blemay360/Chessboard/README.md

# chessboard
Code for a chessboard with computer vision piece tracking
