blemay360/Chessboard/Design/Gimp Files/vision chart.pdf

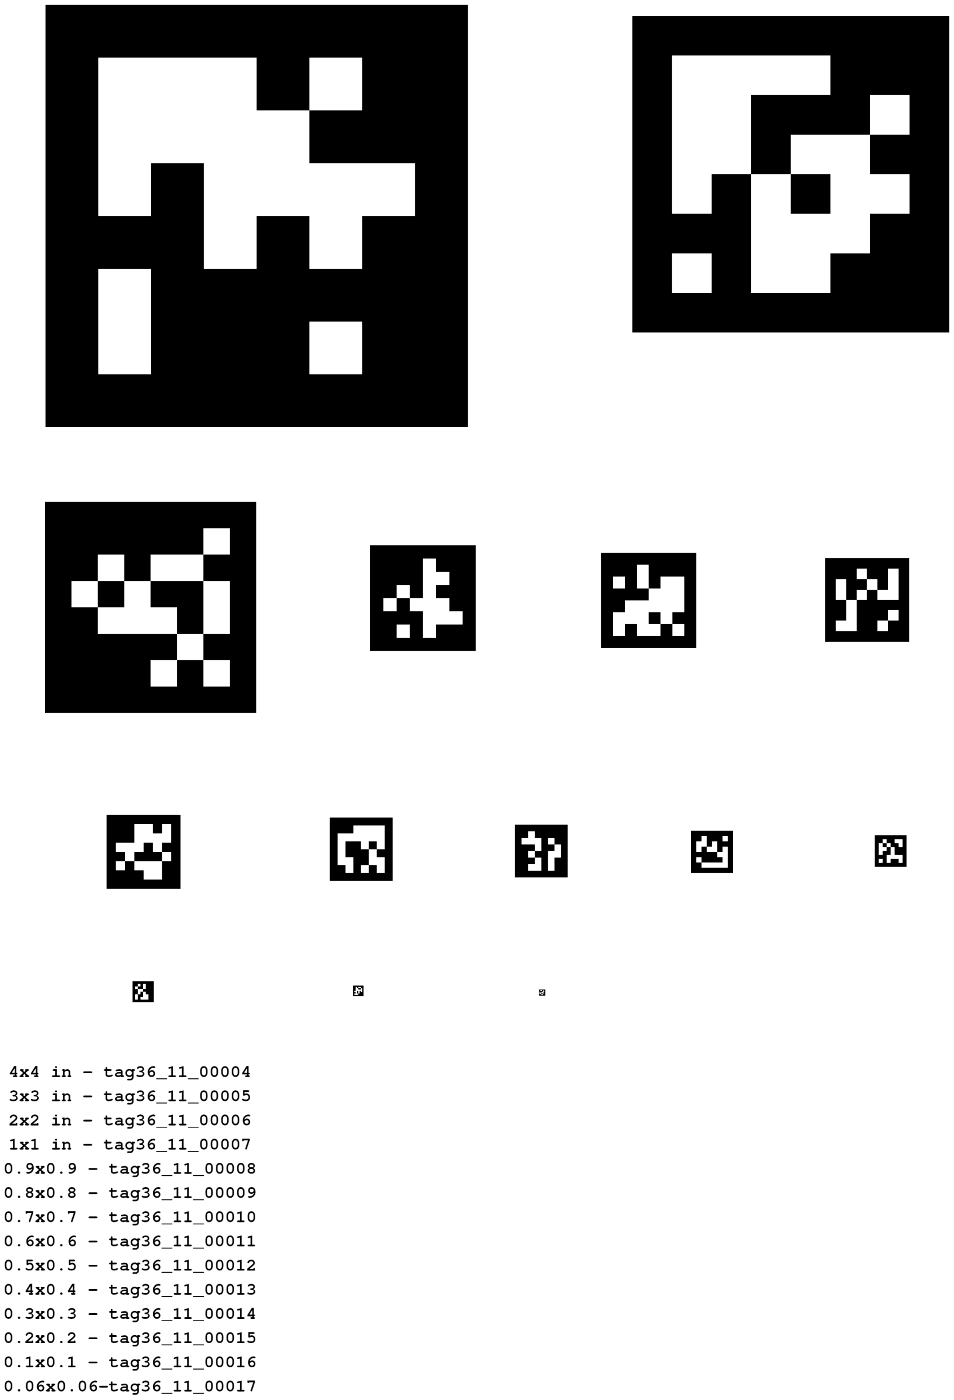
[picture p17: page 1]
