blemay360/Chessboard/Design/Report/Images/ControlSchematicDesign.png

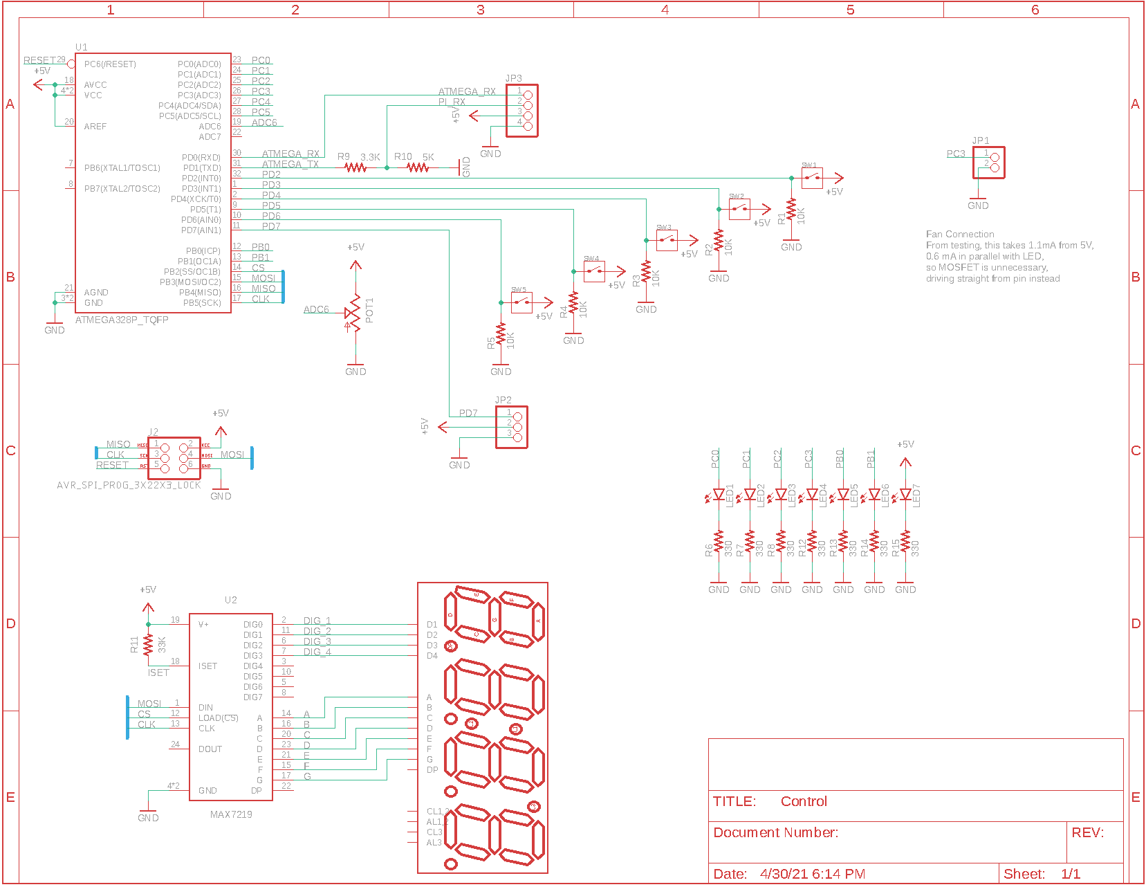
Design/Report/Images/ControlSchematicDesign.png
