blemay360/Chessboard/Software/TestingImages/ItalianGamePaper/ItalianGame1.jpg

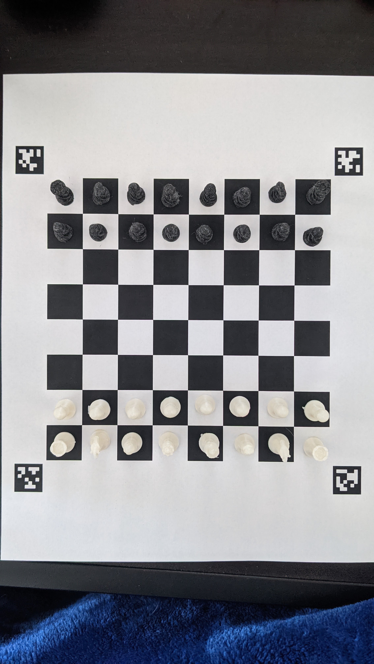
Software/TestingImages/ItalianGamePaper/ItalianGame1.jpg
