blemay360/Chessboard/Software/TestingImages/ItalianGamePaper/ItalianGame2.jpg

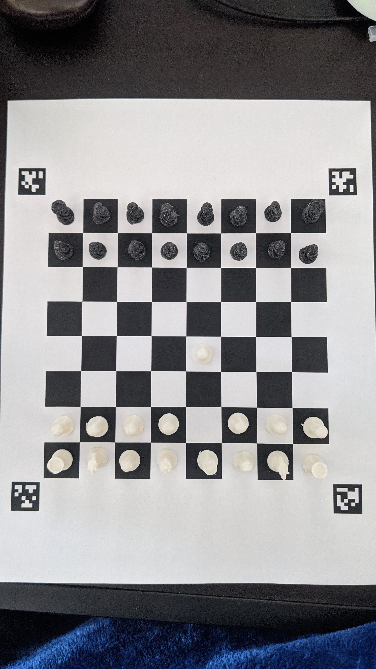
Software/TestingImages/ItalianGamePaper/ItalianGame2.jpg
