blemay360/Chessboard/Software/TestingImages/ItalianGamePaper/ItalianGame3.jpg

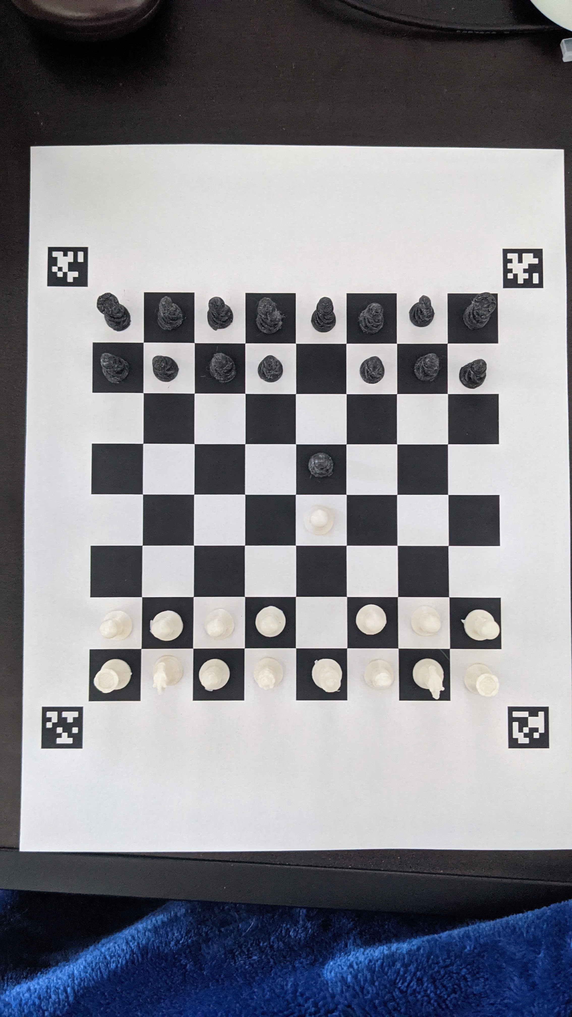
Software/TestingImages/ItalianGamePaper/ItalianGame3.jpg
