blemay360/Chessboard/Software/TestingImages/ItalianGamePaper/ItalianGame4.jpg

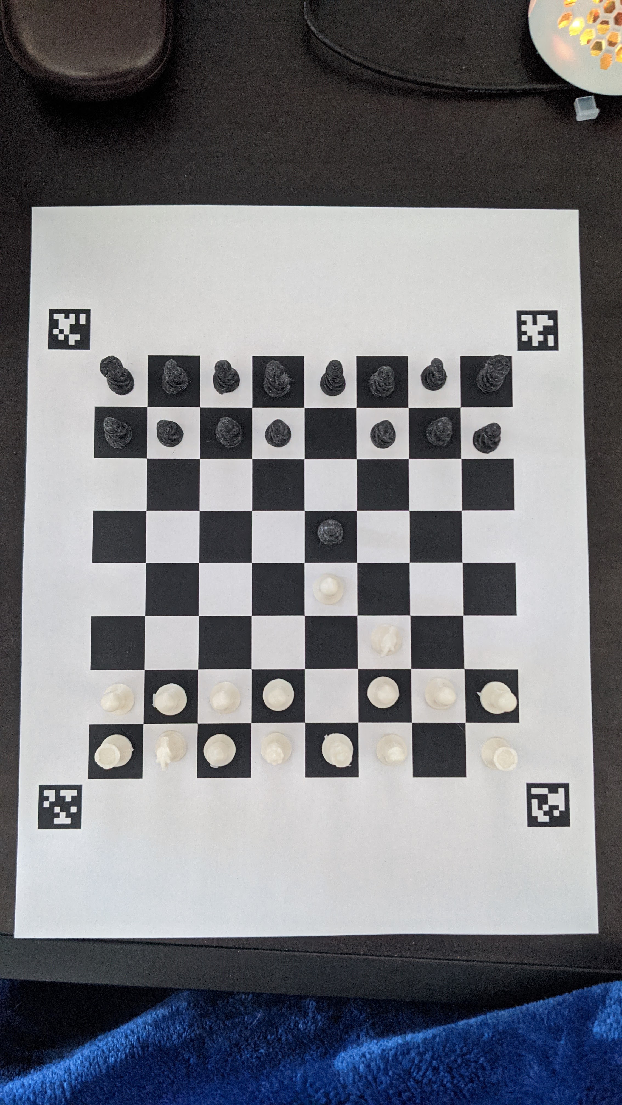
Software/TestingImages/ItalianGamePaper/ItalianGame4.jpg
