blemay360/Chessboard/Software/TestingImages/ItalianGamePaper/ItalianGame5.jpg

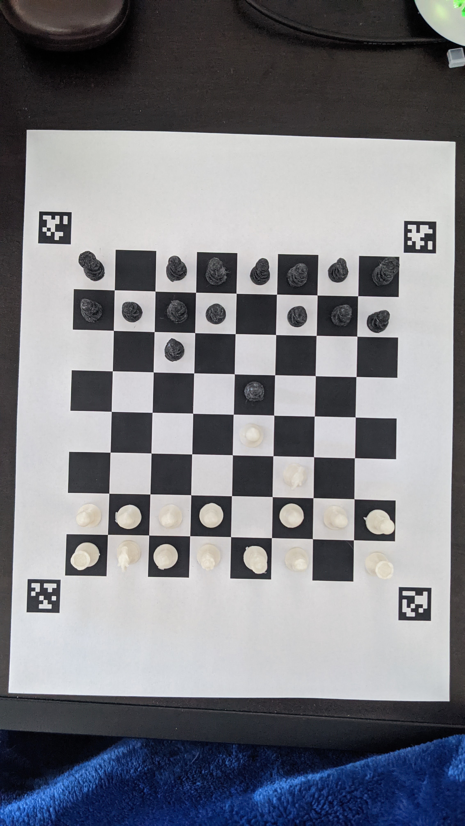
Software/TestingImages/ItalianGamePaper/ItalianGame5.jpg
