blemay360/Chessboard/Software/TestingImages/ItalianGamePaper/ItalianGame6.jpg

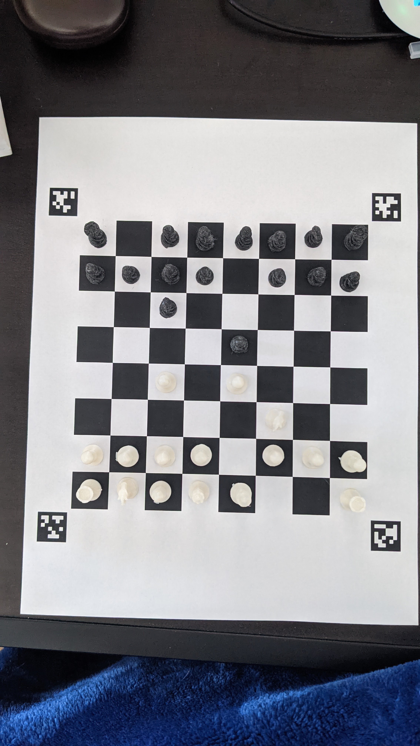
Software/TestingImages/ItalianGamePaper/ItalianGame6.jpg
