blemay360/Chessboard/Software/TestingImages/ItalianGamePaper/ItalianGame7.jpg

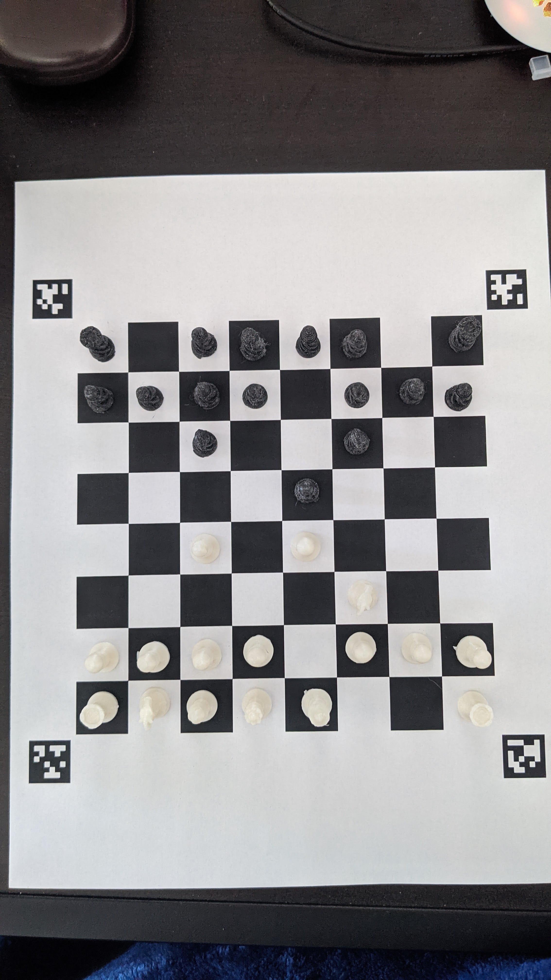
Software/TestingImages/ItalianGamePaper/ItalianGame7.jpg
