blemay360/Chessboard/Software/TestingImages/ItalianGamePaper/ItalianGame8.jpg

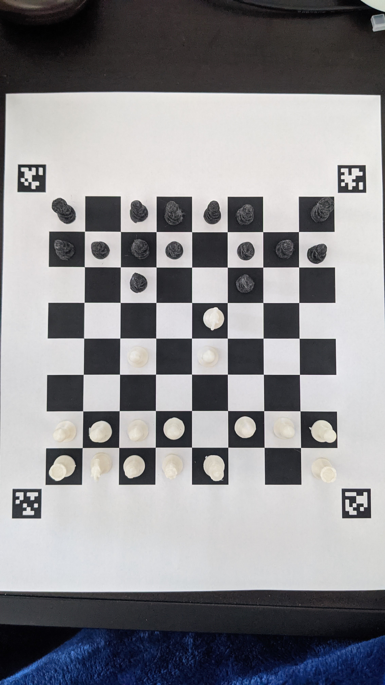
Software/TestingImages/ItalianGamePaper/ItalianGame8.jpg
