blemay360/Chessboard/Software/TestingImages/ItalianGamePaper/ItalianGame9.jpg

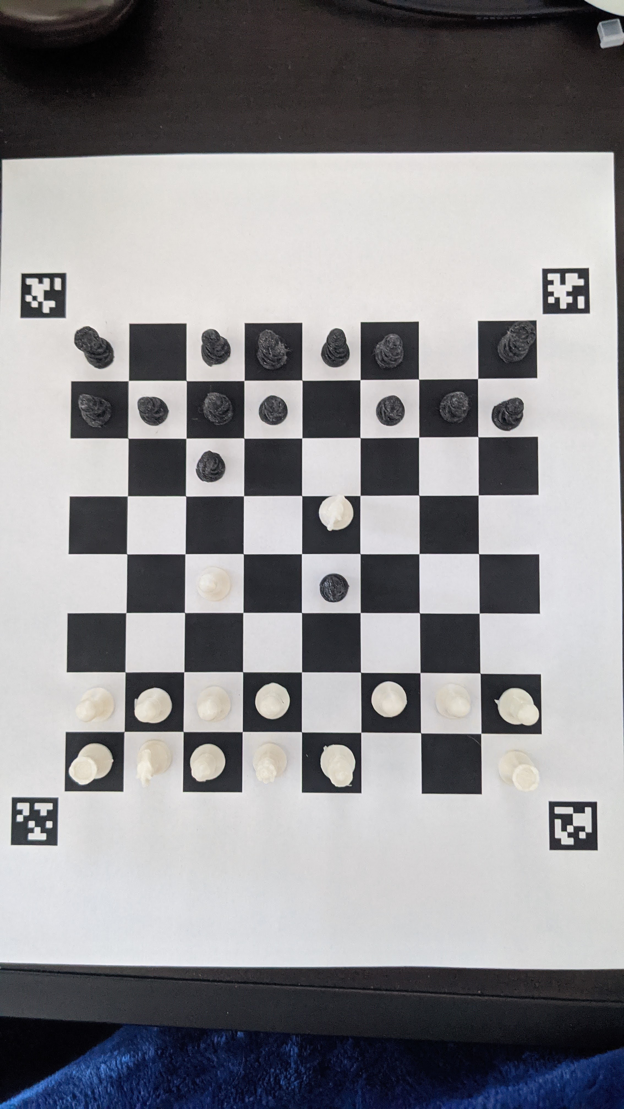
Software/TestingImages/ItalianGamePaper/ItalianGame9.jpg
