blemay360/Chessboard/Software/TestingImages/ItalianGamePaper/ItalianGame10.jpg

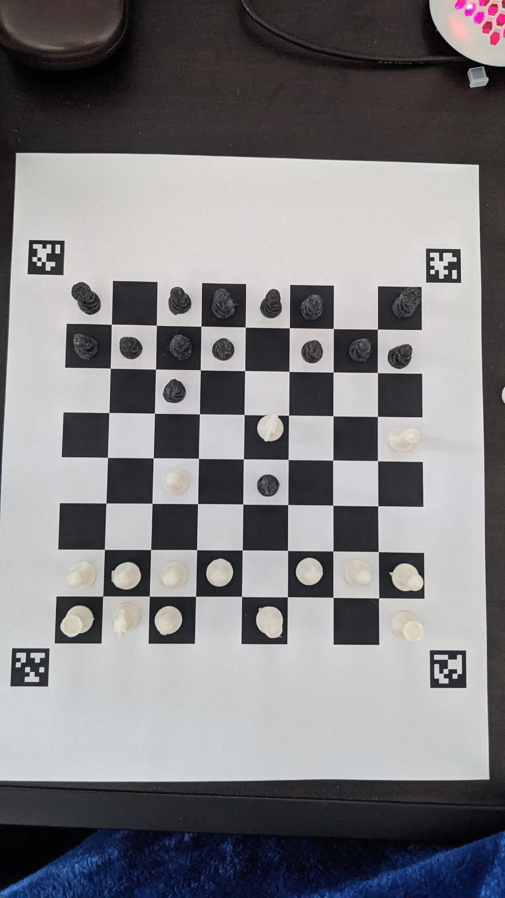
Software/TestingImages/ItalianGamePaper/ItalianGame10.jpg
