blemay360/Chessboard/Software/TestingImages/ItalianGamePaper/ItalianGame11.jpg

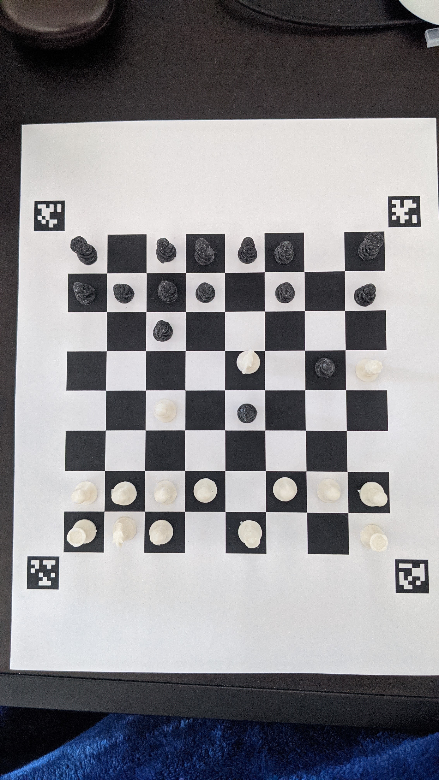
Software/TestingImages/ItalianGamePaper/ItalianGame11.jpg
