blemay360/Chessboard/Software/TestingImages/ItalianGamePaper/ItalianGame12.jpg

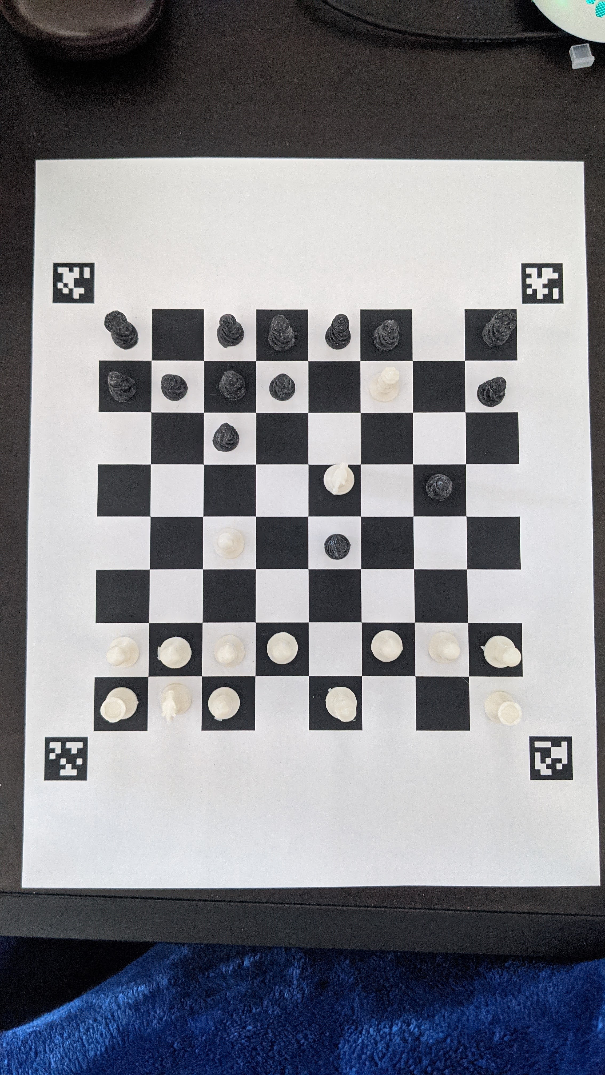
Software/TestingImages/ItalianGamePaper/ItalianGame12.jpg
