blemay360/Chessboard/Software/TestingImages/ItalianGamePaper/ItalianGame_AllBlack1.jpg

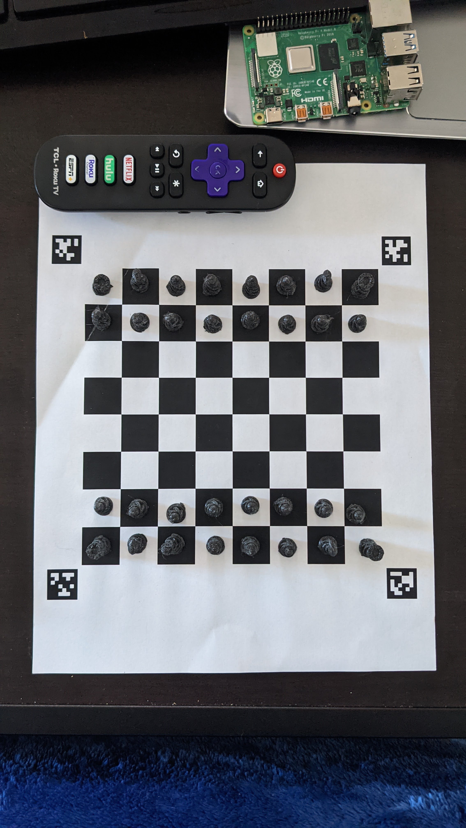
Software/TestingImages/ItalianGamePaper/ItalianGame_AllBlack1.jpg
