blemay360/Chessboard/Software/TestingImages/ItalianGamePaper/ItalianGame_AllBlack2.jpg

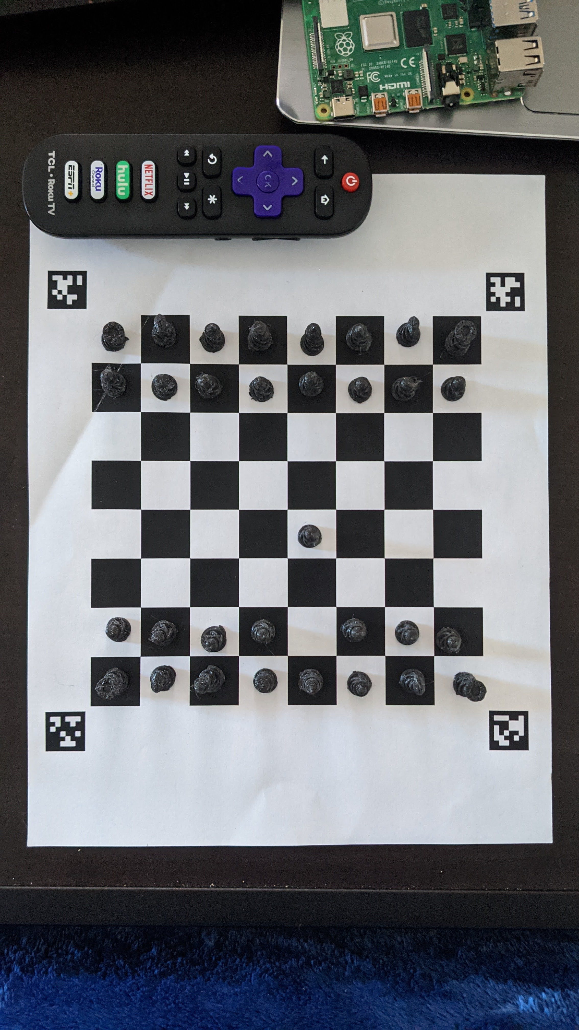
Software/TestingImages/ItalianGamePaper/ItalianGame_AllBlack2.jpg
