blemay360/Chessboard/Software/TestingImages/ItalianGamePaper/ItalianGame_AllBlack3.jpg

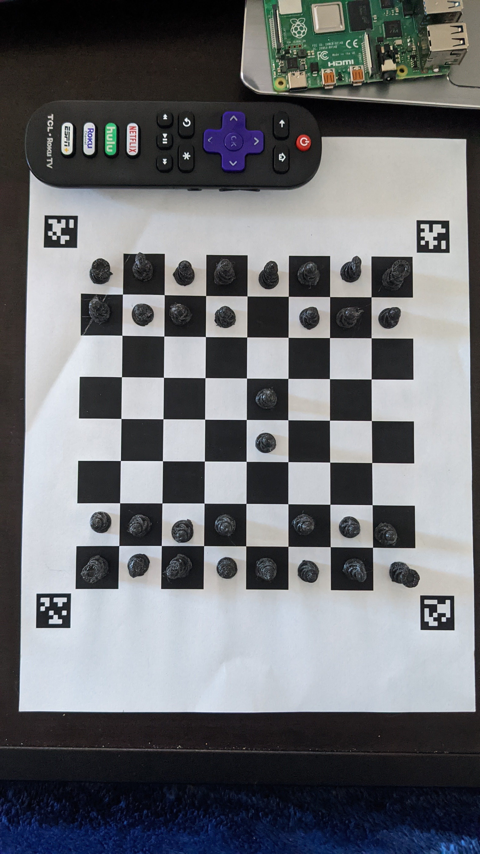
Software/TestingImages/ItalianGamePaper/ItalianGame_AllBlack3.jpg
