blemay360/Chessboard/Software/TestingImages/ItalianGamePaper/ItalianGame_AllBlack6.jpg

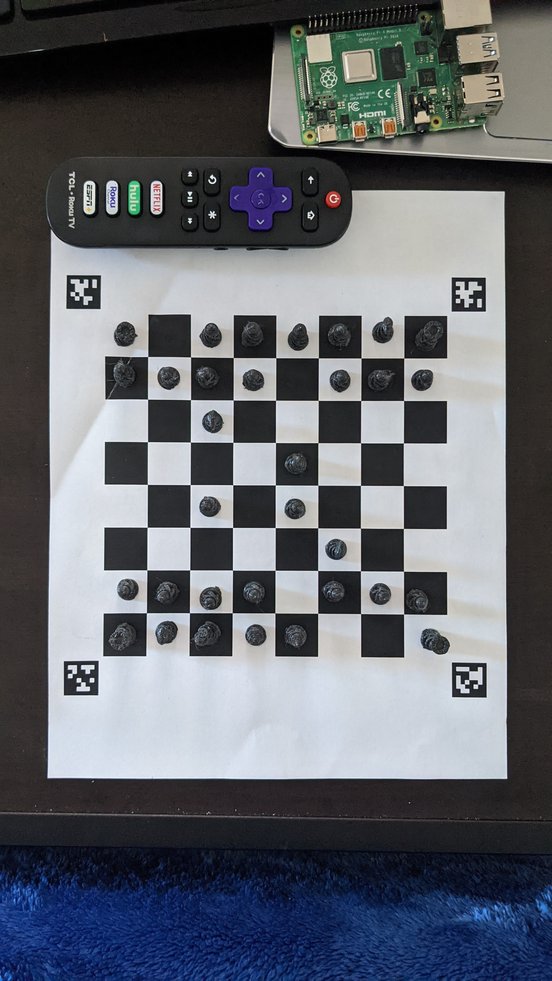
Software/TestingImages/ItalianGamePaper/ItalianGame_AllBlack6.jpg
