blemay360/Chessboard/Mechanical/STL files/Camera Standoff.stl

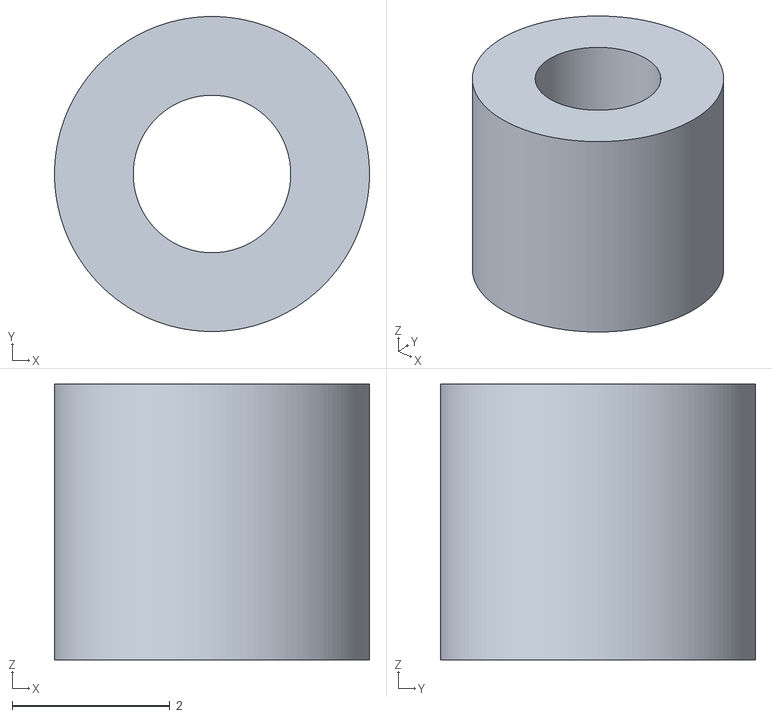
[picture p35: CAD file, 2021-04-05]
Mechanical/STL files/Camera Standoff.stl
4.00 x 4.00 x 3.50
