blemay360/Chessboard/Mechanical/STL files/Board mount MVP.stl

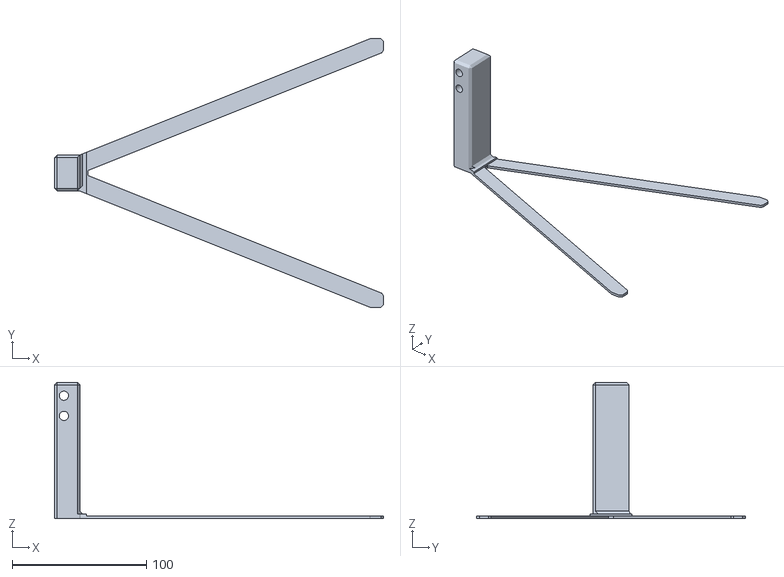
[picture p36: CAD file, 2021-04-05]
Mechanical/STL files/Board mount MVP.stl
245.0 x 200.0 x 101.6
