blemay360/Chessboard/Mechanical/STL files/Queen.STL

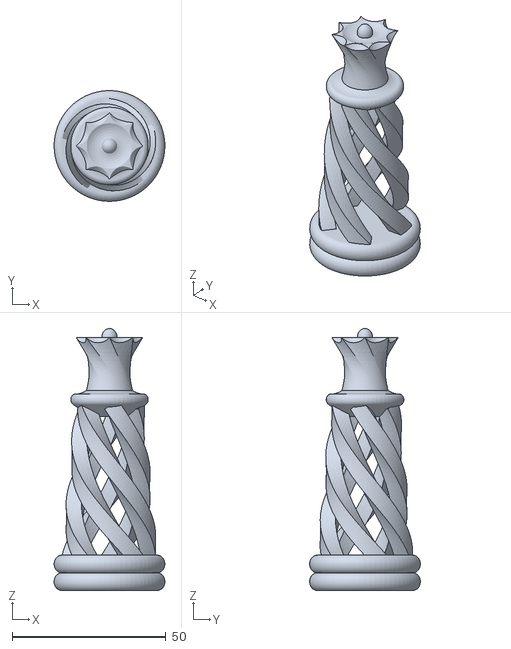
[picture p37: CAD file, 2021-03-10]
Mechanical/STL files/Queen.STL
36.0 x 36.0 x 85.1
