blemay360/Chessboard/Mechanical/STL files/Pawn.stl

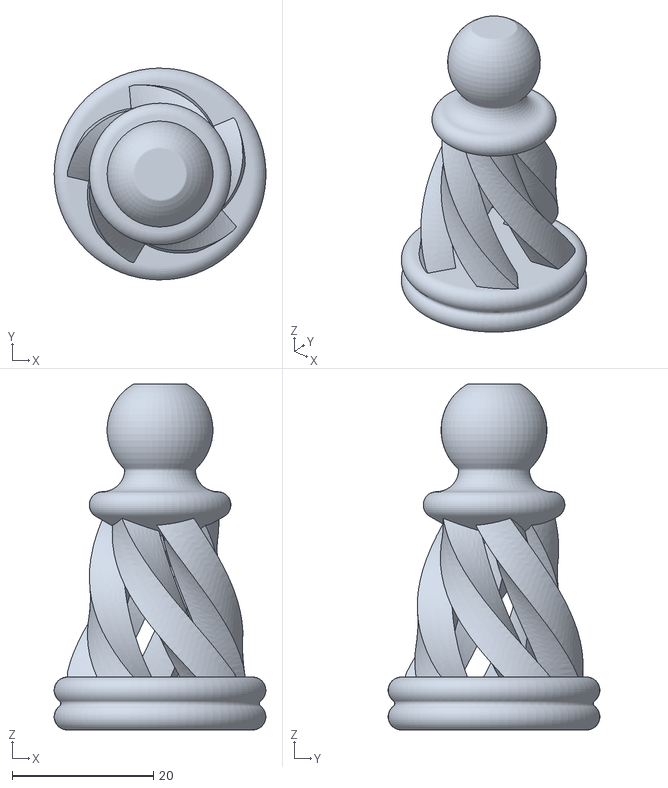
[picture p38: CAD file, 2021-03-10]
Mechanical/STL files/Pawn.stl
30.0 x 30.0 x 49.0
