blemay360/Chessboard/Mechanical/STL files/King.STL

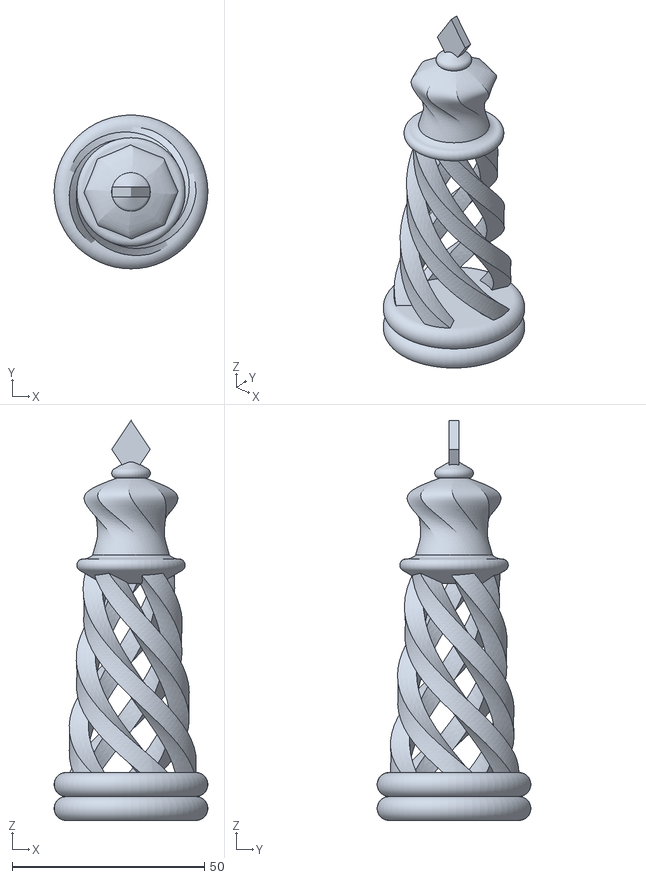
[picture p39: CAD file, 2021-03-10]
Mechanical/STL files/King.STL
40.0 x 40.0 x 104.0
