blemay360/Chessboard/Mechanical/STL files/Rook2.STL

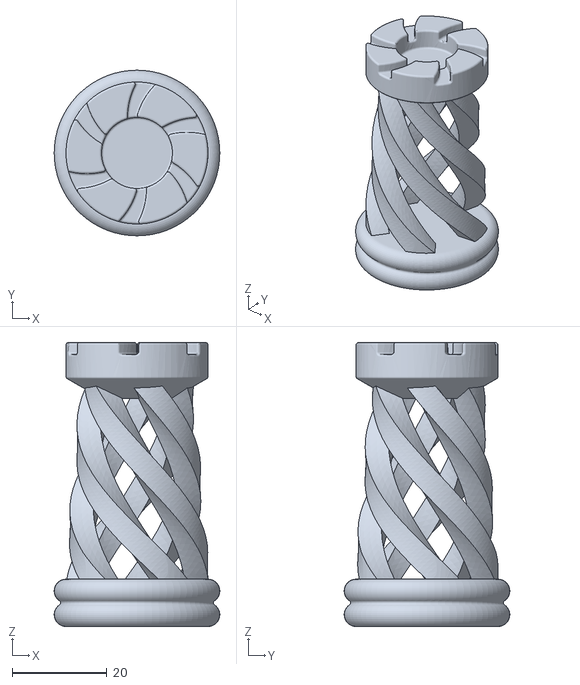
[picture p40: CAD file, 2021-03-10]
Mechanical/STL files/Rook2.STL
35.0 x 35.0 x 60.0
