blemay360/Chessboard/Mechanical/STL files/Knight.STL

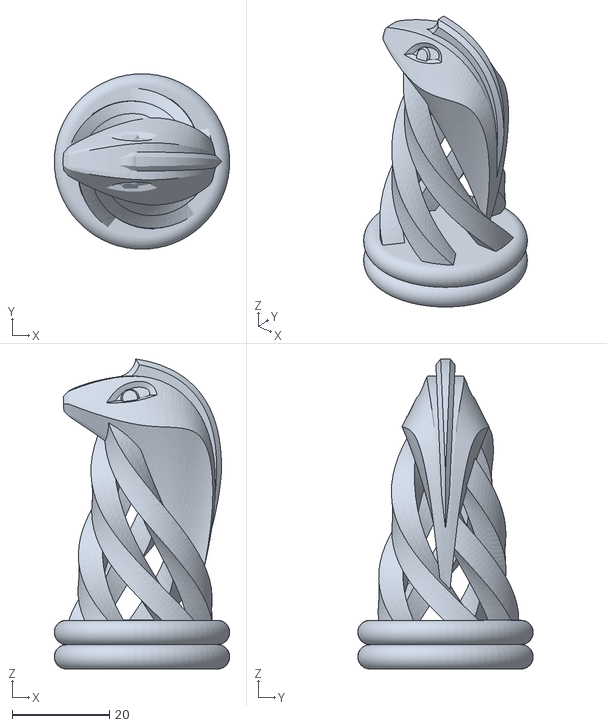
[picture p41: CAD file, 2021-03-10]
Mechanical/STL files/Knight.STL
36.0 x 36.0 x 63.6
