blemay360/Chessboard/Mechanical/STL files/Bishop.stl

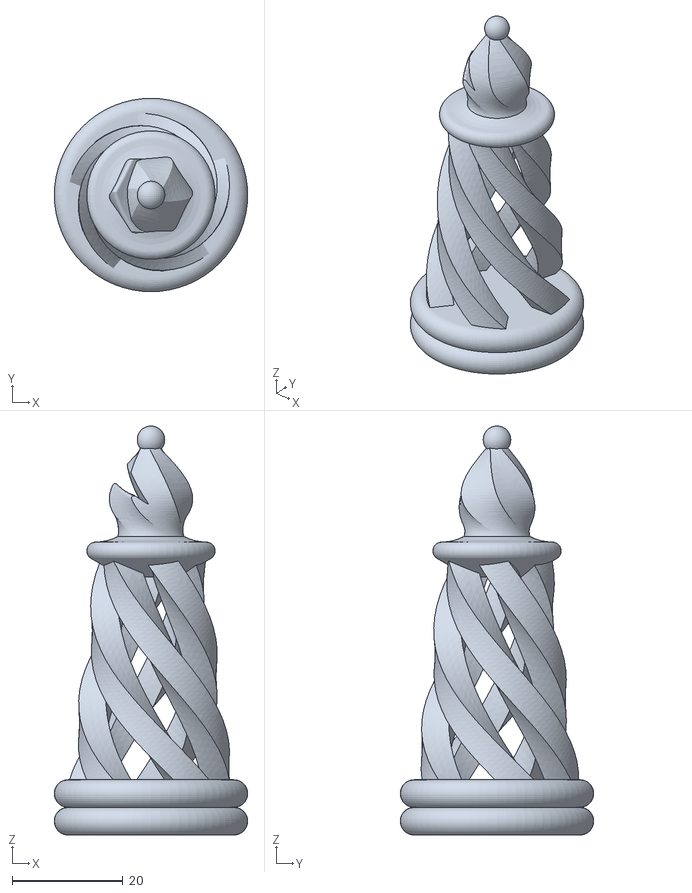
[picture p42: CAD file, 2021-03-10]
Mechanical/STL files/Bishop.stl
35.0 x 35.0 x 74.0
