blemay360/Chessboard/Design/Report/Images/11in_TestChessboard_16h5_Comparison_5pt.png

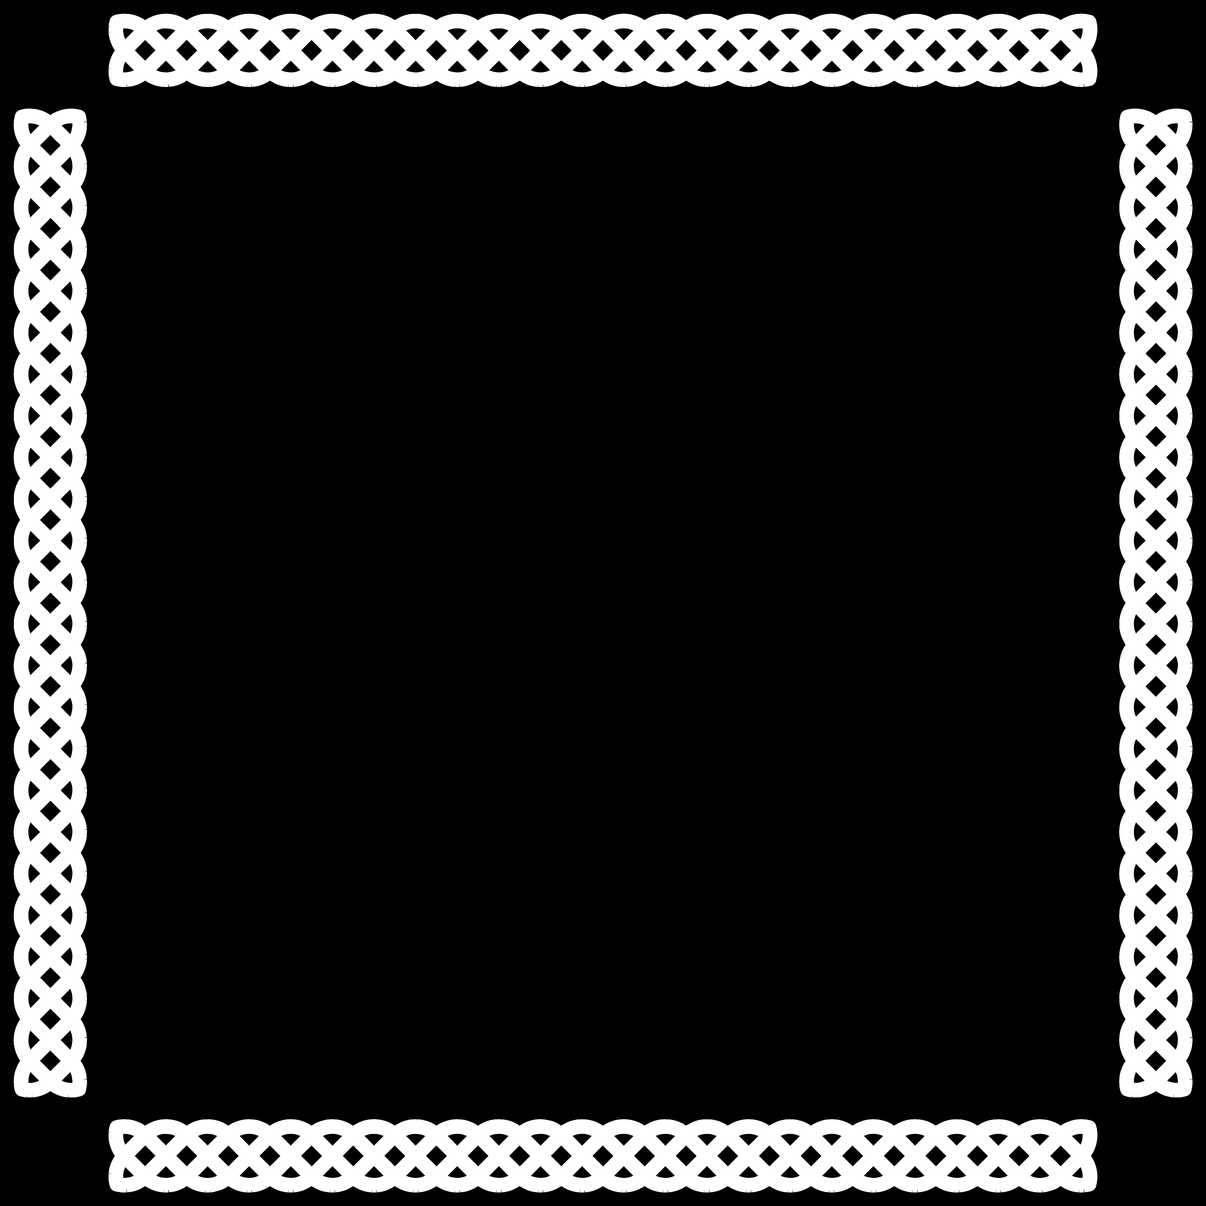
Design/Report/Images/11in_TestChessboard_16h5_Comparison_5pt.png
