blemay360/Chessboard/Software/BorderComparisonImages/11in_TestChessboard_16h5_Comparison_12pt.png

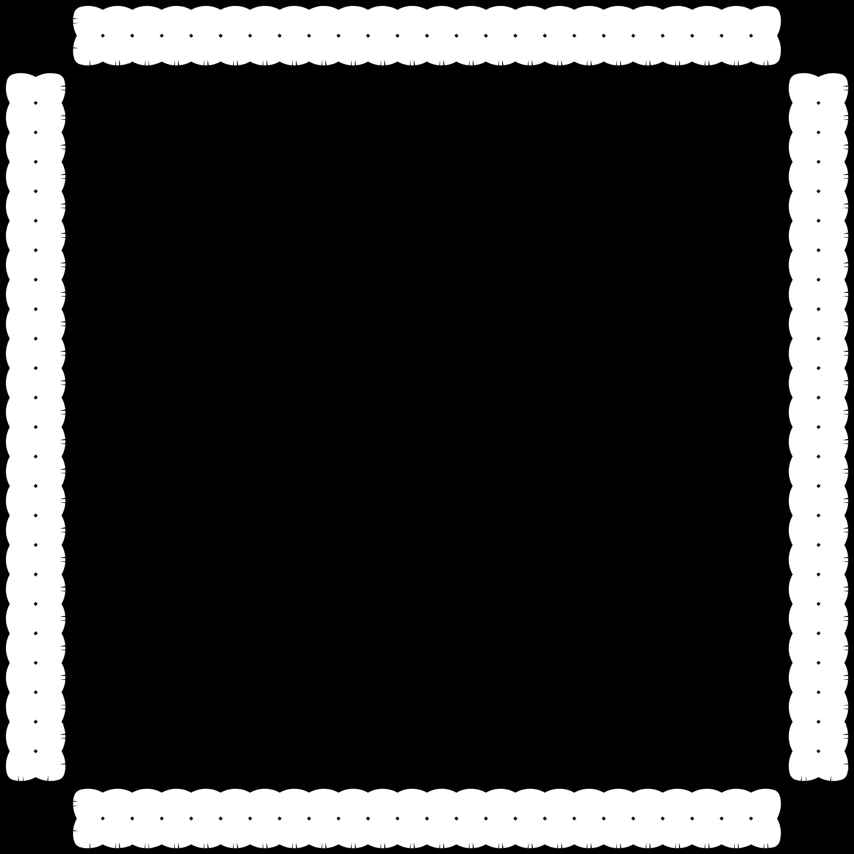
Software/BorderComparisonImages/11in_TestChessboard_16h5_Comparison_12pt.png
