blemay360/Chessboard/Software/TestingImages/ExampleCollage.png

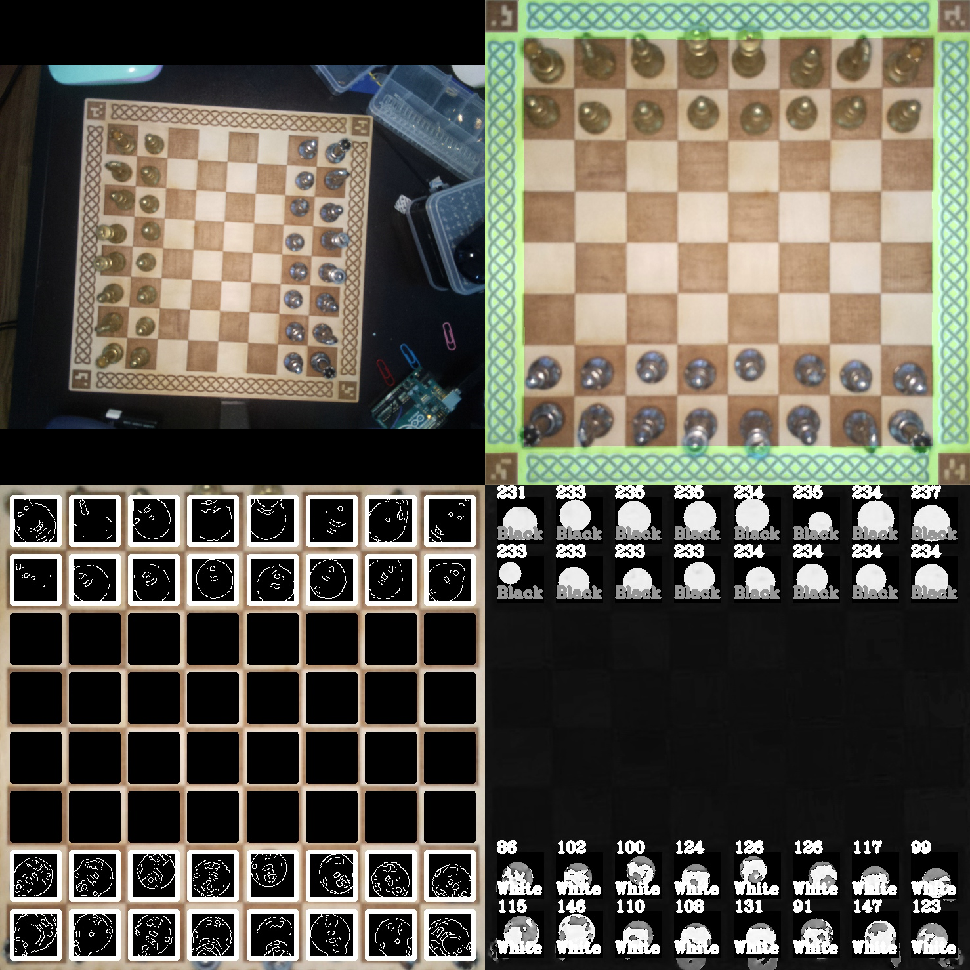
Software/TestingImages/ExampleCollage.png
