blemay360/Chessboard/Software/TestingImages/ItalianGamePaper/ItalianGame_CaptureTesting1.jpg

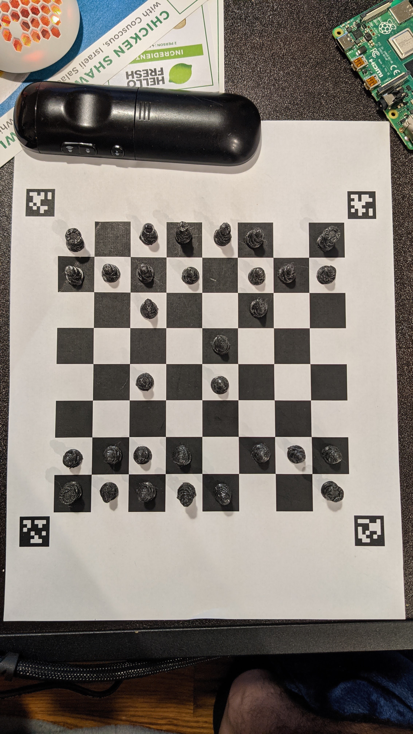
Software/TestingImages/ItalianGamePaper/ItalianGame_CaptureTesting1.jpg
