blemay360/Chessboard/Software/TestingImages/ItalianGamePaper/ItalianGame_CaptureTesting2.jpg

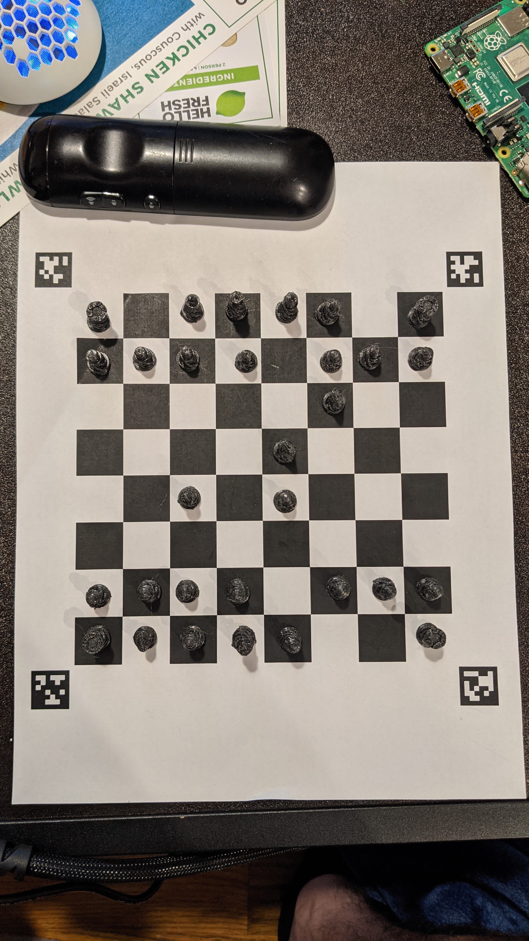
Software/TestingImages/ItalianGamePaper/ItalianGame_CaptureTesting2.jpg
