blemay360/Chessboard/Software/TestingImages/ItalianGamePaper/ItalianGame_CaptureTesting3.jpg

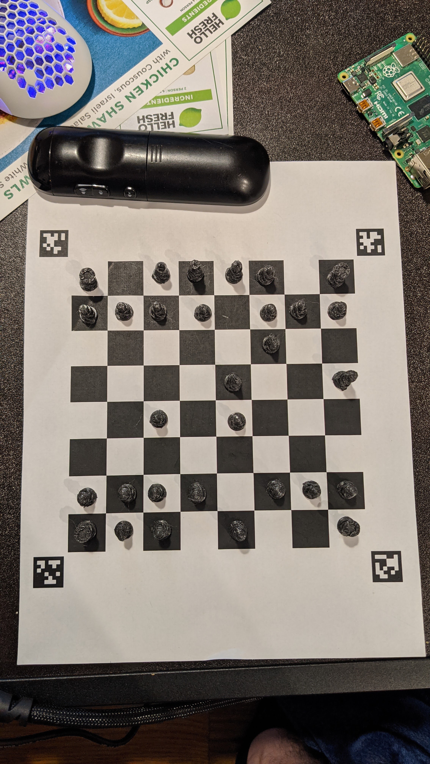
Software/TestingImages/ItalianGamePaper/ItalianGame_CaptureTesting3.jpg
