blemay360/Chessboard/Software/TestingImages/ItalianGamePaper/ItalianGame_CaptureTesting4.jpg

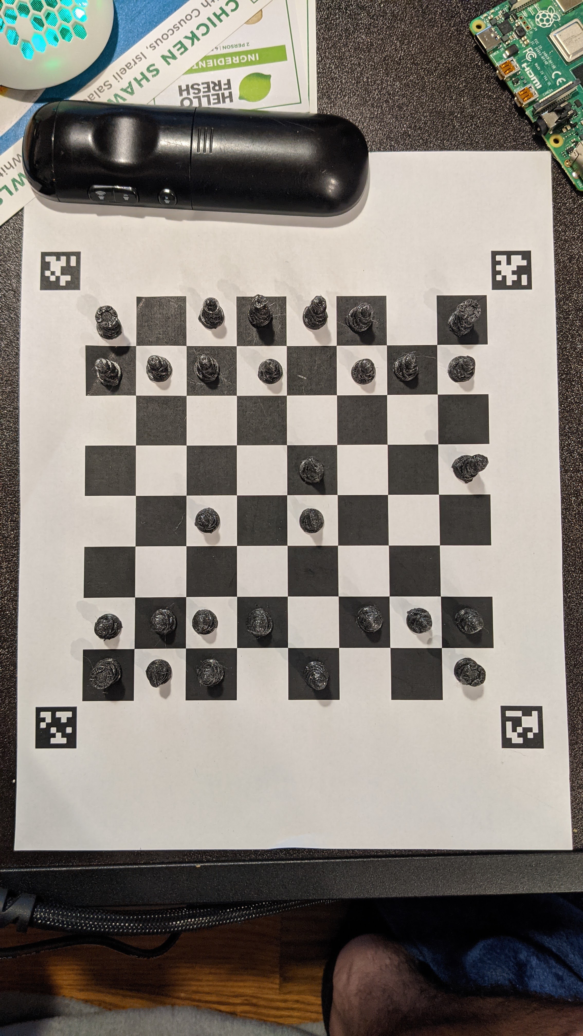
Software/TestingImages/ItalianGamePaper/ItalianGame_CaptureTesting4.jpg
