blemay360/Chessboard/Software/TestingImages/ItalianGamePaper/ItalianGame_CaptureTesting5.jpg

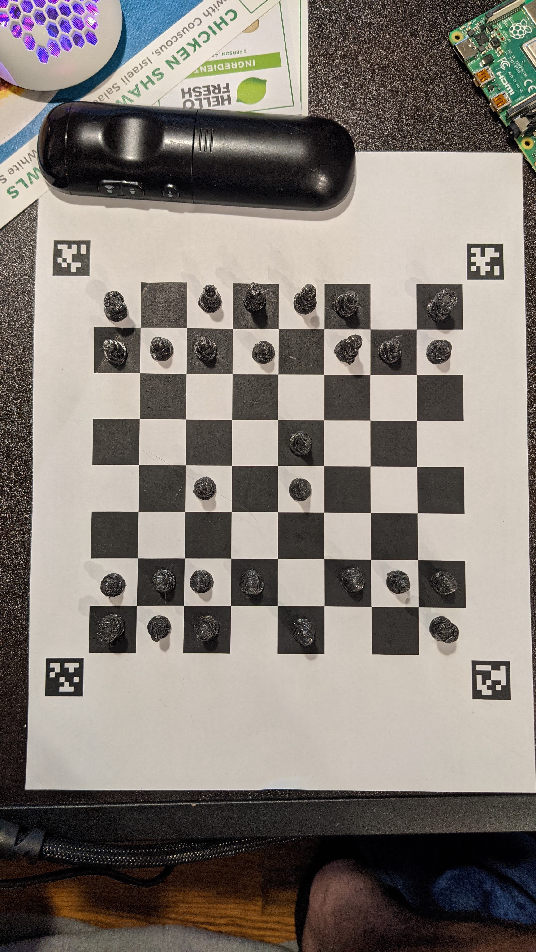
Software/TestingImages/ItalianGamePaper/ItalianGame_CaptureTesting5.jpg
