blemay360/Chessboard/Software/TestingImages/ItalianGamePaper/ItalianGame_CaptureTesting6.jpg

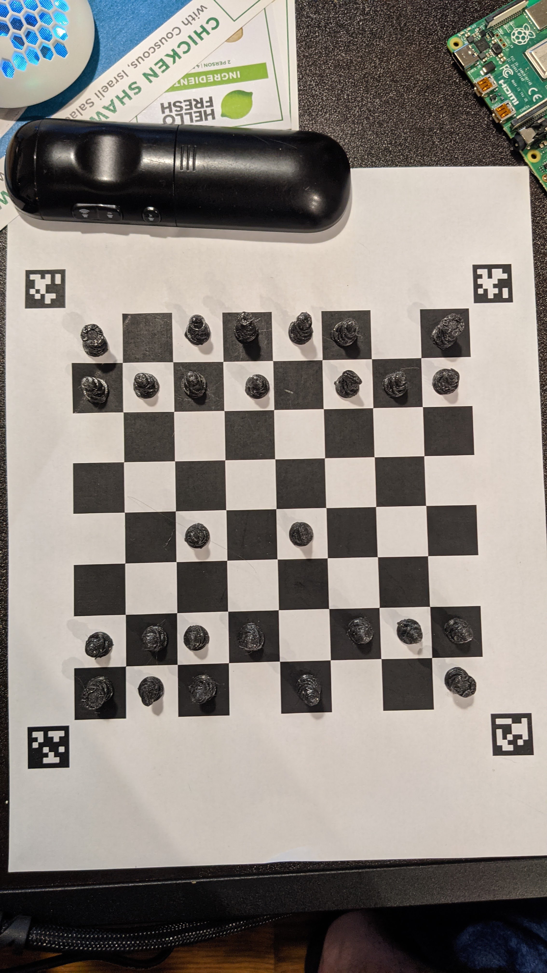
Software/TestingImages/ItalianGamePaper/ItalianGame_CaptureTesting6.jpg
