blemay360/Chessboard/Software/TestingImages/ItalianGamePaper/ItalianGame_CaptureTesting7.jpg

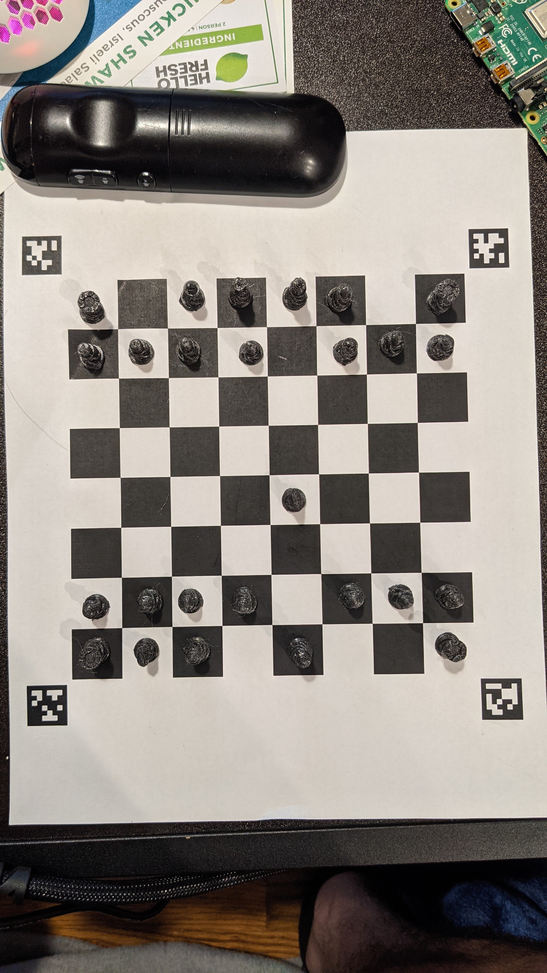
Software/TestingImages/ItalianGamePaper/ItalianGame_CaptureTesting7.jpg
