blemay360/Chessboard/Software/TestingImages/LargeBoard/1.jpg

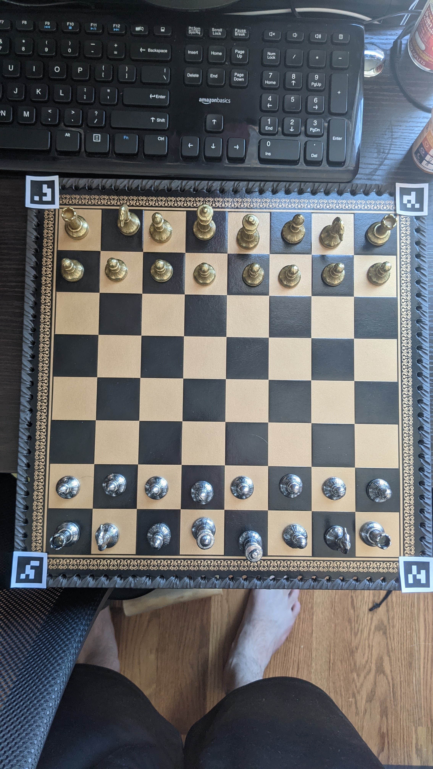
Software/TestingImages/LargeBoard/1.jpg
