blemay360/Chessboard/Software/TestingImages/LargeBoard/1night.jpg

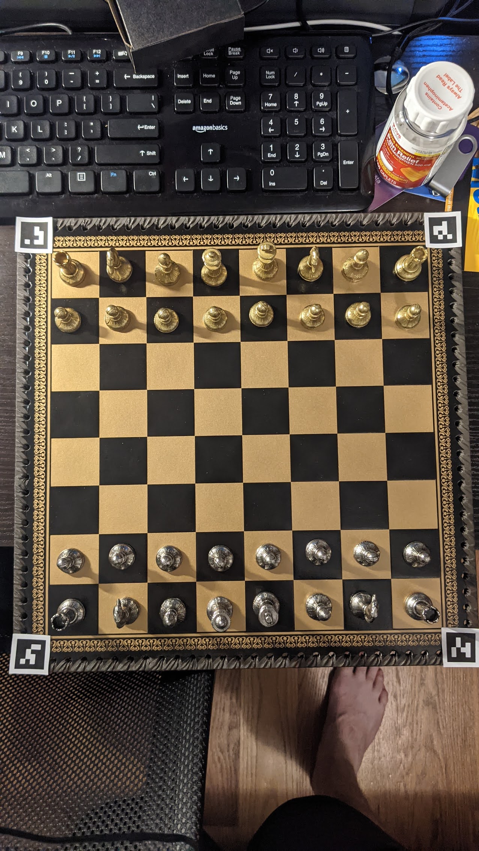
Software/TestingImages/LargeBoard/1night.jpg
