blemay360/Chessboard/Software/TestingImages/LargeBoard/2.jpg

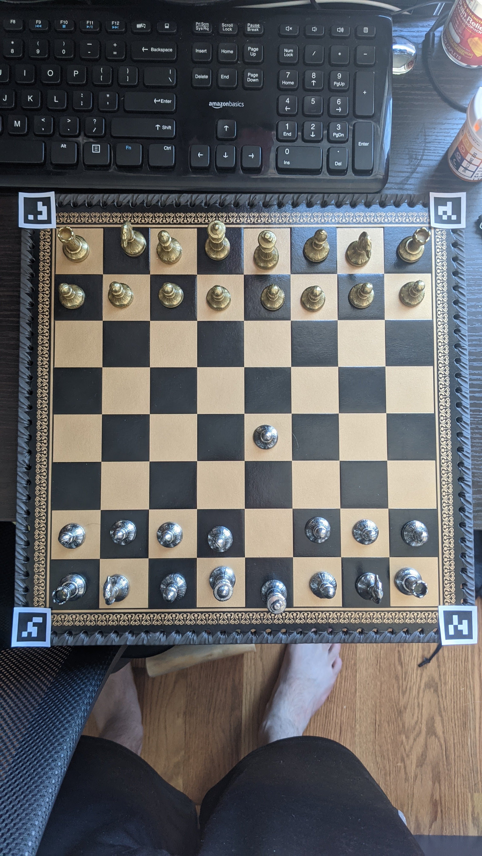
Software/TestingImages/LargeBoard/2.jpg
