blemay360/Chessboard/Software/TestingImages/LargeBoard/3.jpg

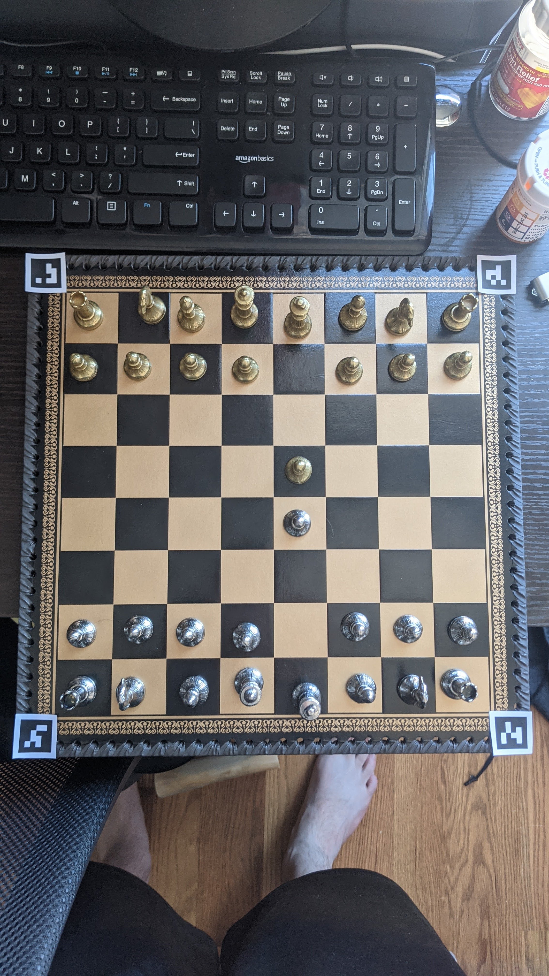
Software/TestingImages/LargeBoard/3.jpg
