blemay360/Chessboard/Software/TestingImages/LargeBoard/4.jpg

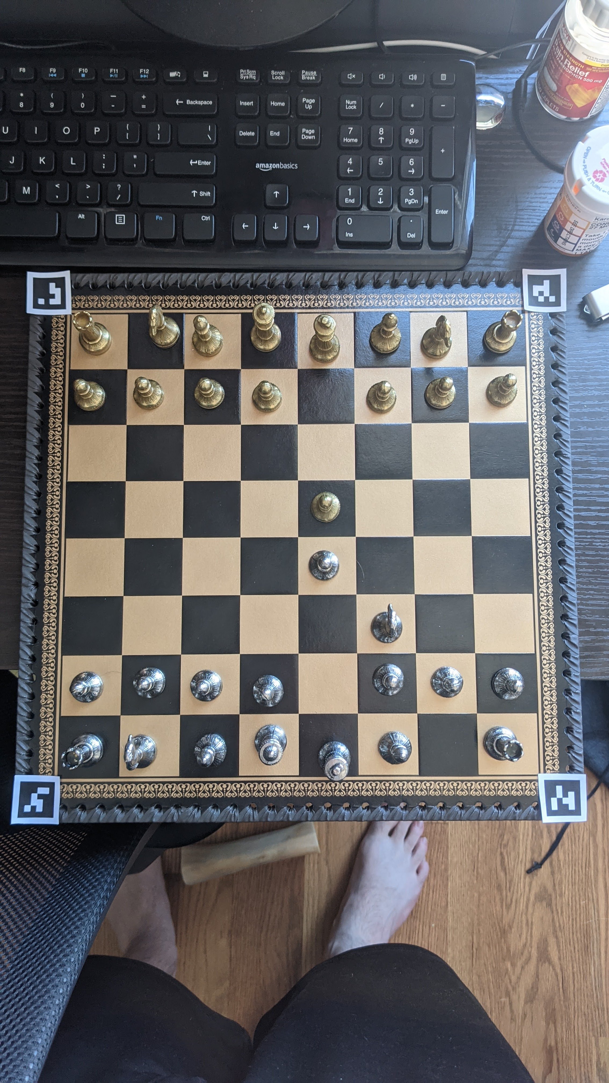
Software/TestingImages/LargeBoard/4.jpg
