blemay360/Chessboard/Software/TestingImages/LargeBoard/6.jpg

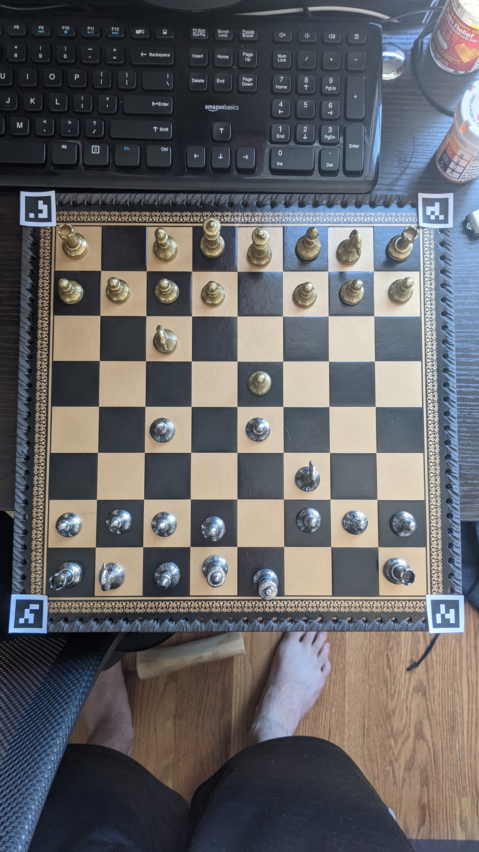
Software/TestingImages/LargeBoard/6.jpg
