blemay360/Chessboard/Software/TestingImages/MiscImages/3d_box.jpeg

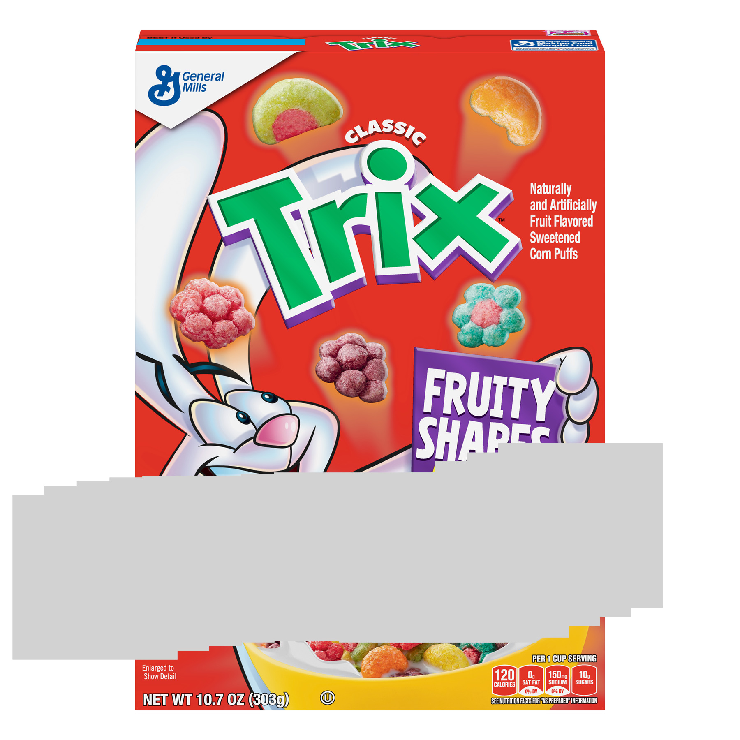
Software/TestingImages/MiscImages/3d_box.jpeg
