blemay360/Chessboard/Software/TestingImages/MiscImages/16bitApriltags.jpg

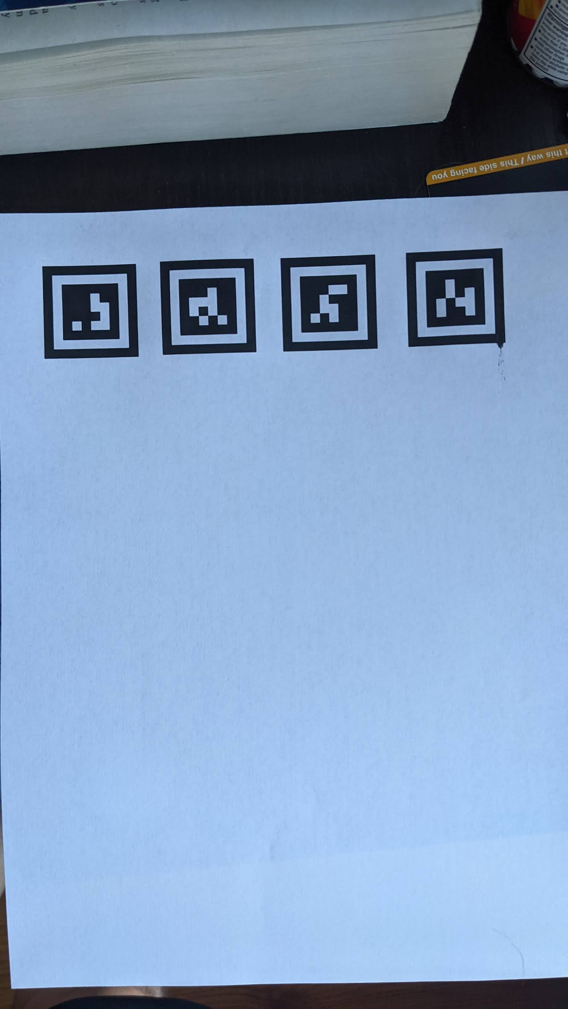
Software/TestingImages/MiscImages/16bitApriltags.jpg
