blemay360/Chessboard/Software/TestingImages/MiscImages/16bitApriltags_onBoard.jpg

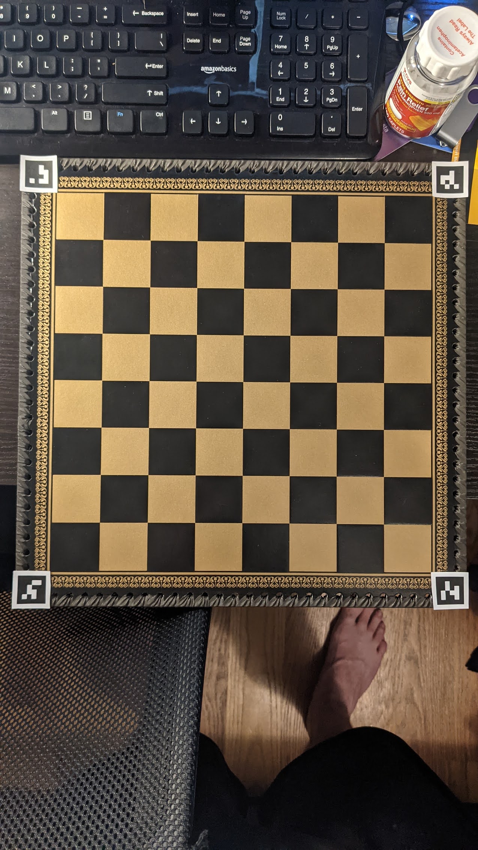
Software/TestingImages/MiscImages/16bitApriltags_onBoard.jpg
