blemay360/Chessboard/Software/TestingImages/MiscImages/16bitApriltagsCutout.jpg

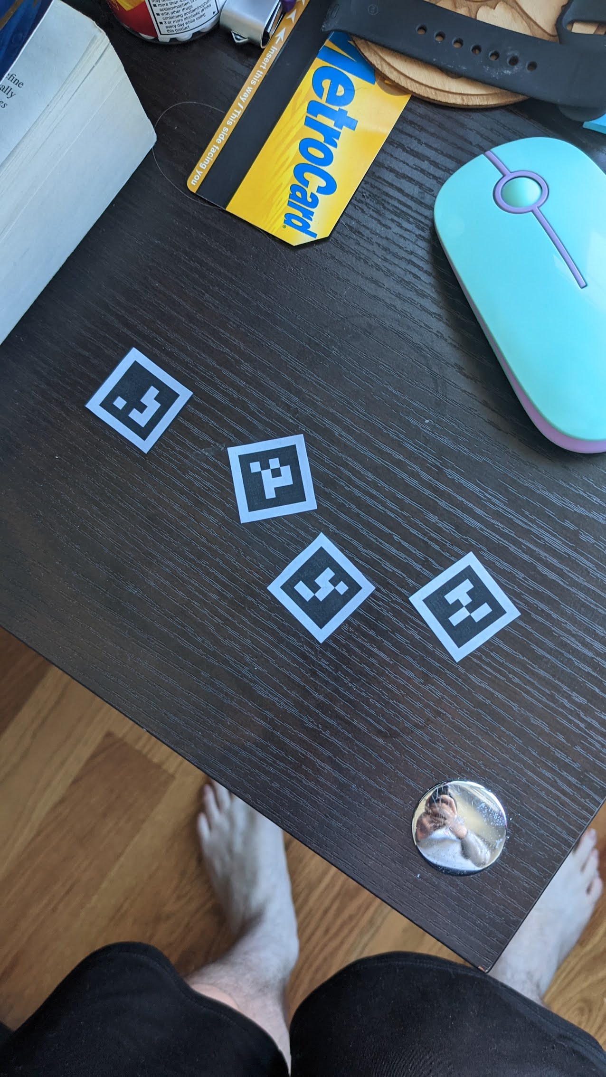
Software/TestingImages/MiscImages/16bitApriltagsCutout.jpg
