blemay360/Chessboard/Software/TestingImages/MiscImages/aprilTagImageBorders.jpg

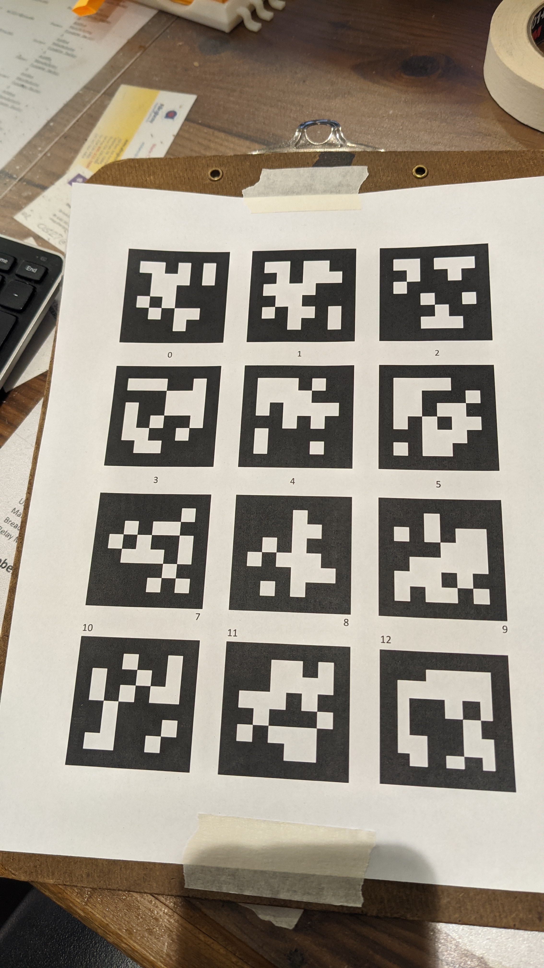
Software/TestingImages/MiscImages/aprilTagImageBorders.jpg
