blemay360/Chessboard/Software/TestingImages/MiscImages/box.jpeg

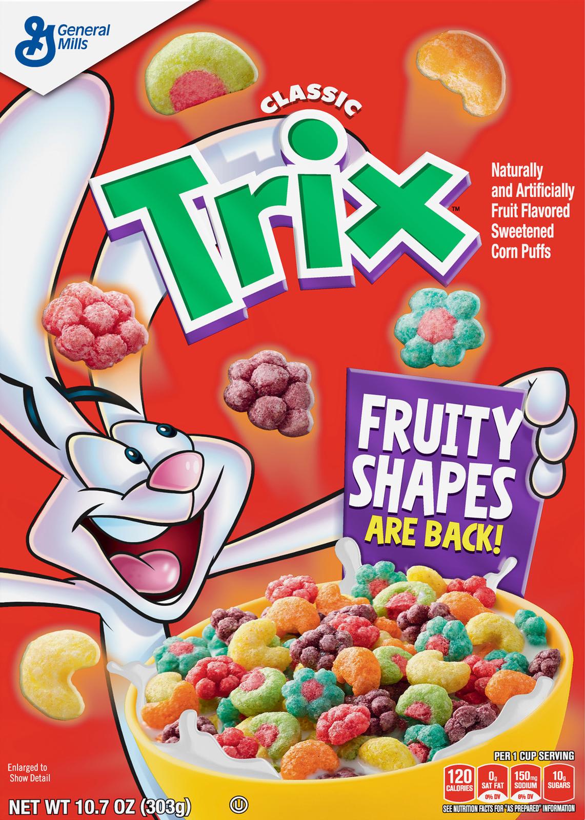
Software/TestingImages/MiscImages/box.jpeg
