blemay360/Chessboard/Software/TestingImages/MiscImages/box_on_table.jpeg

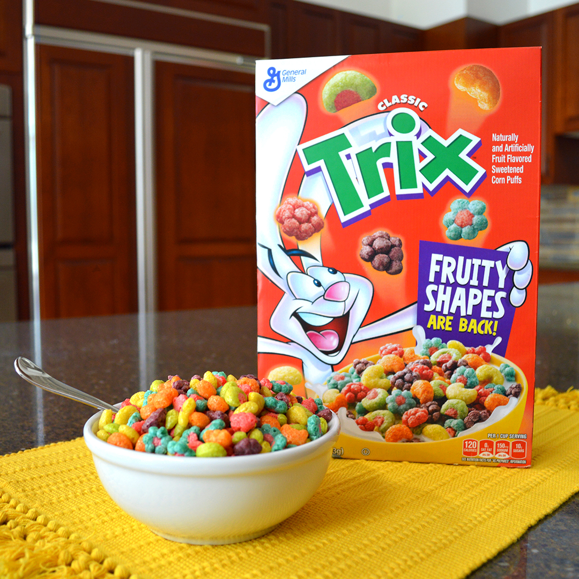
Software/TestingImages/MiscImages/box_on_table.jpeg
