blemay360/Chessboard/Software/TestingImages/MiscImages/CelticKnotTesting1.jpg

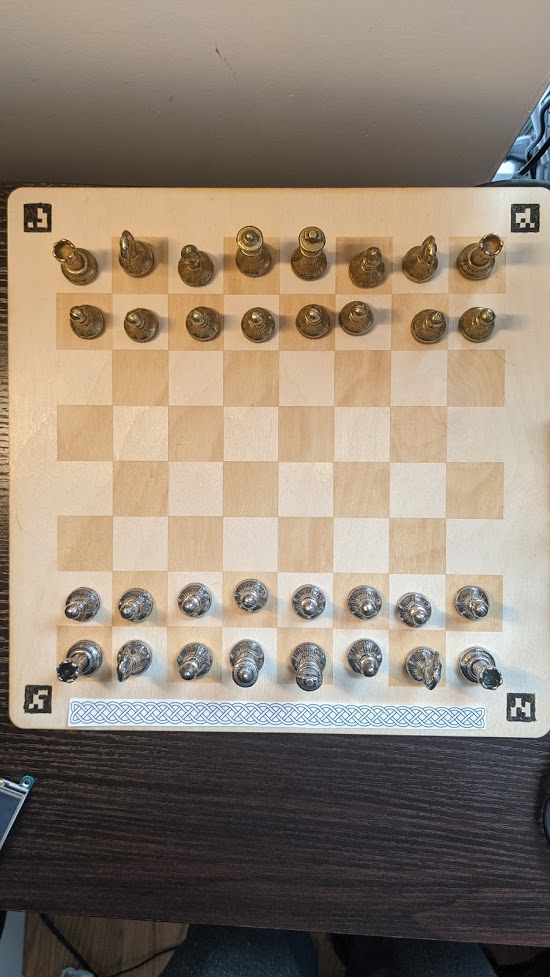
Software/TestingImages/MiscImages/CelticKnotTesting1.jpg
