blemay360/Chessboard/Software/TestingImages/MiscImages/CelticKnotTesting2.jpg

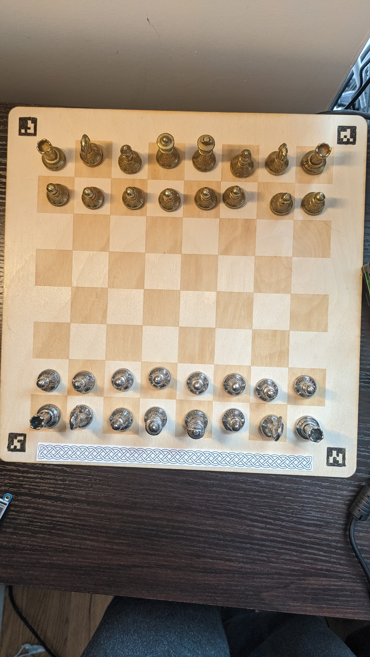
Software/TestingImages/MiscImages/CelticKnotTesting2.jpg
