blemay360/Chessboard/Software/TestingImages/MiscImages/chessboardAprilTagGrayBorder.jpg

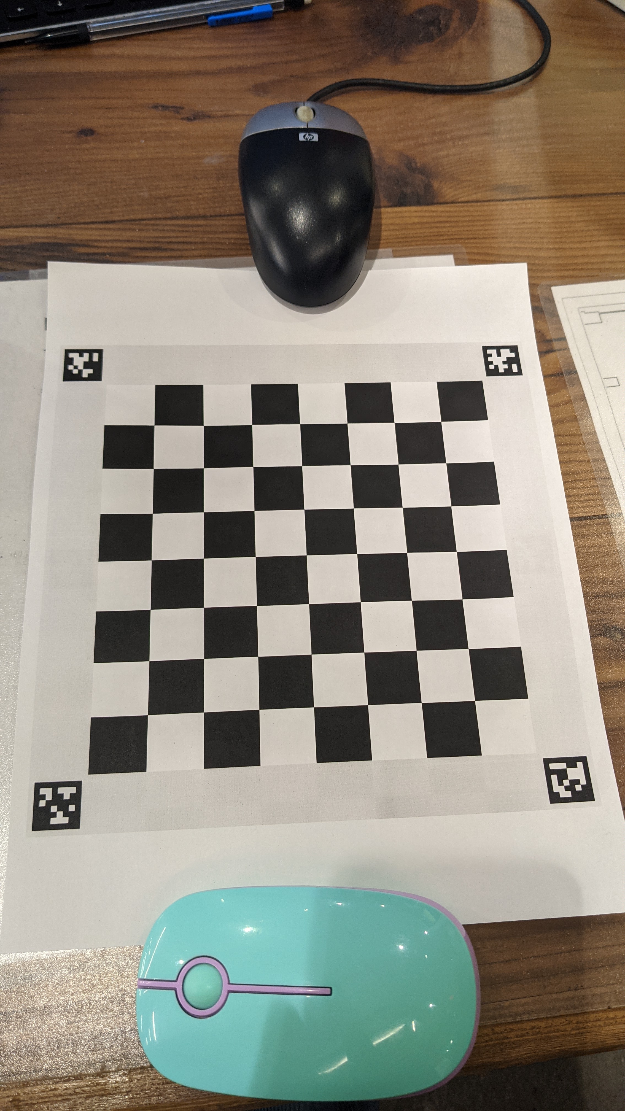
Software/TestingImages/MiscImages/chessboardAprilTagGrayBorder.jpg
