blemay360/Chessboard/Software/TestingImages/MiscImages/chessboardAprilTagWhiteBorder.jpg

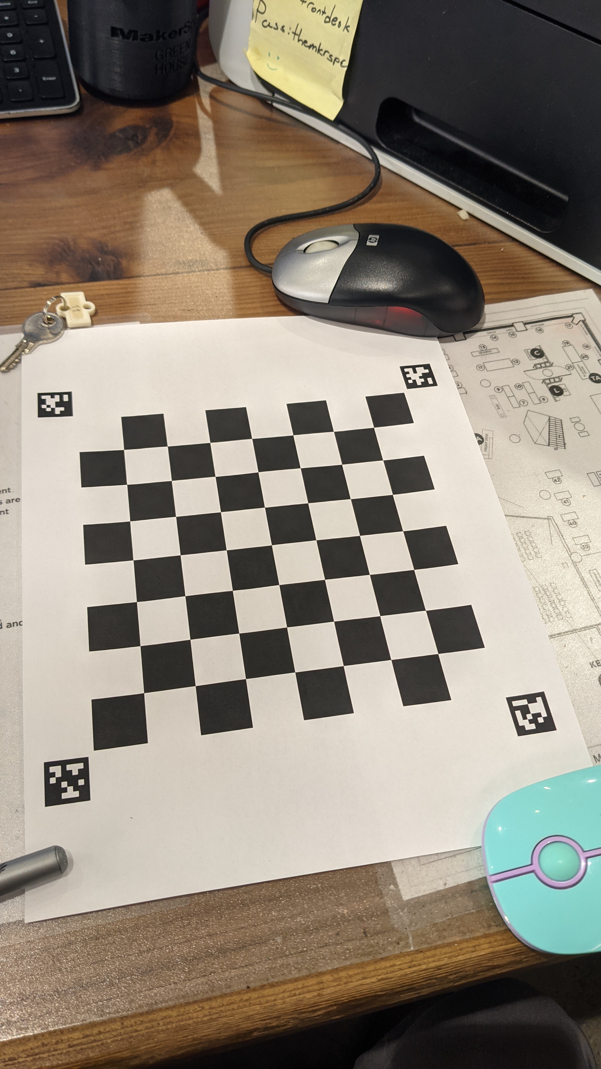
Software/TestingImages/MiscImages/chessboardAprilTagWhiteBorder.jpg
