blemay360/Chessboard/Software/TestingImages/MiscImages/chessboardAprilTagWhiteBorderOnePiece.jpg

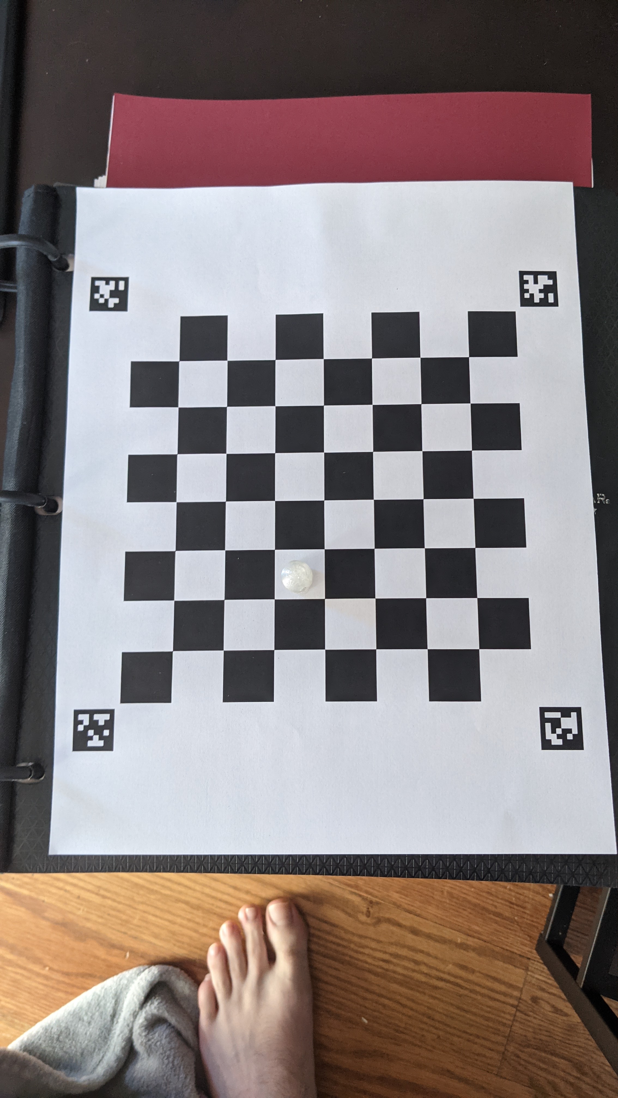
Software/TestingImages/MiscImages/chessboardAprilTagWhiteBorderOnePiece.jpg
