blemay360/Chessboard/Software/TestingImages/MiscImages/LightingTesting.jpg

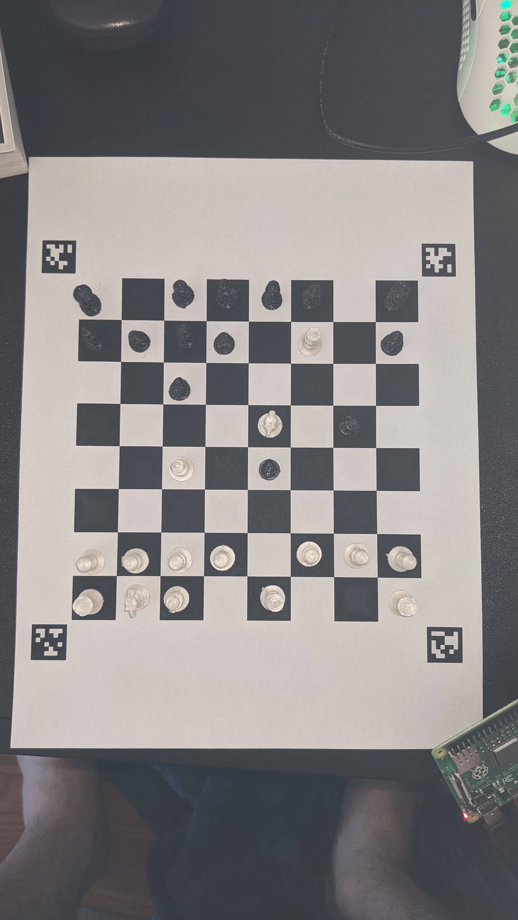
Software/TestingImages/MiscImages/LightingTesting.jpg
