blemay360/Chessboard/Software/TestingImages/MiscImages/LightingTesting_cropped.jpg

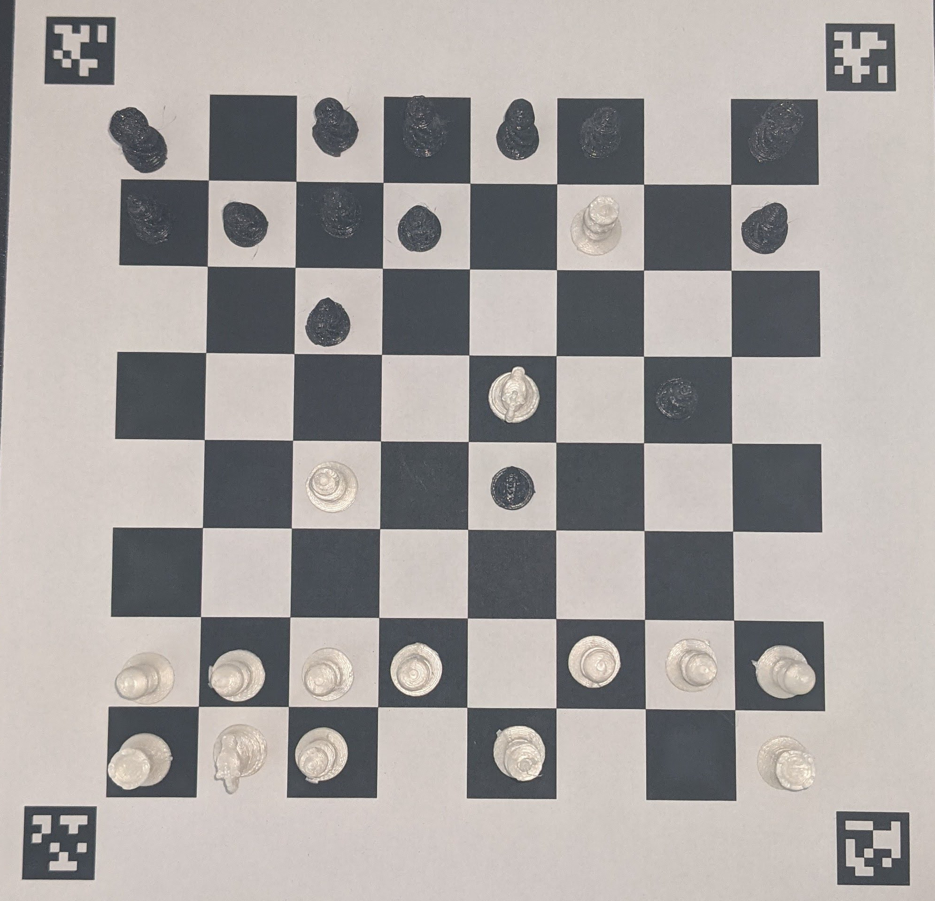
Software/TestingImages/MiscImages/LightingTesting_cropped.jpg
