blemay360/Chessboard/Software/TestingImages/MiscImages/PXL_20210308_211909004~2.jpg

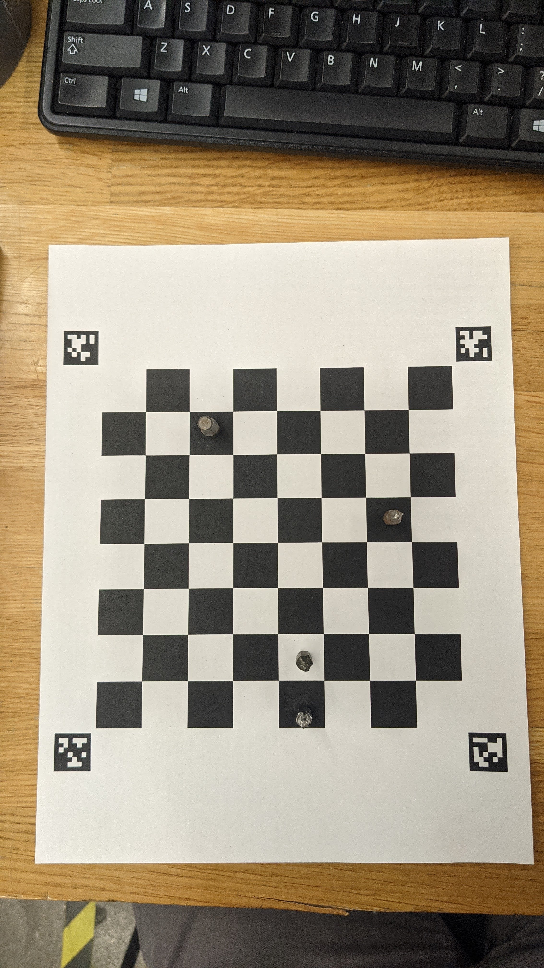
Software/TestingImages/MiscImages/PXL_20210308_211909004~2.jpg
