blemay360/Chessboard/Software/TestingImages/MiscImages/PXL_20210308_230904002.jpg

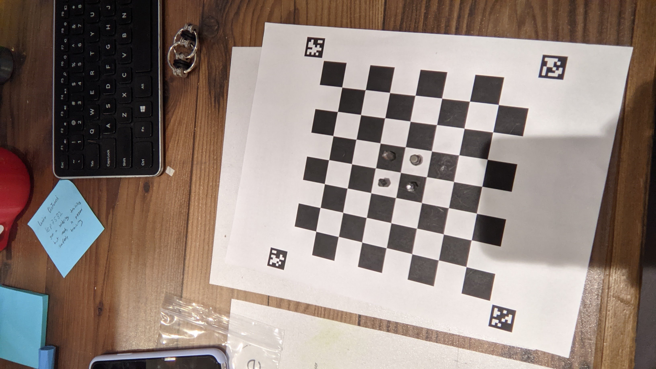
Software/TestingImages/MiscImages/PXL_20210308_230904002.jpg
