blemay360/Chessboard/Software/TestingImages/MiscImages/PXL_20210309_190502183.jpg

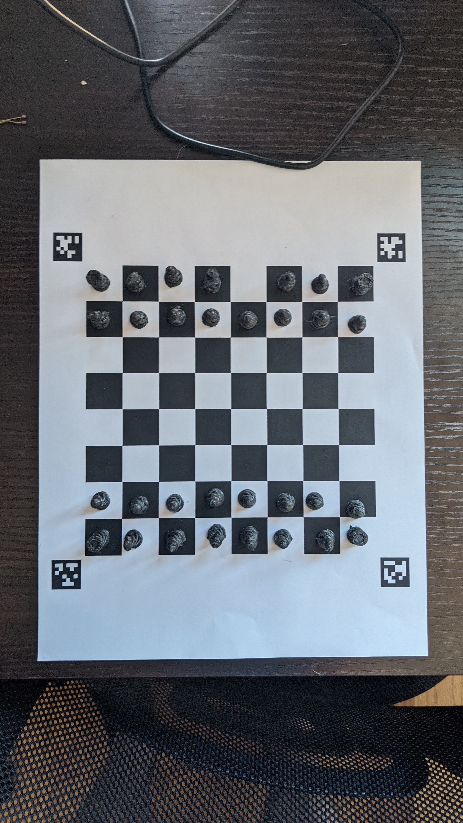
Software/TestingImages/MiscImages/PXL_20210309_190502183.jpg
