blemay360/Chessboard/Software/TestingImages/PiImages/1_cropped.jpg

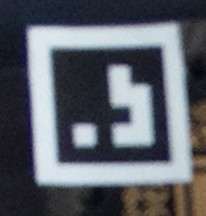
Software/TestingImages/PiImages/1_cropped.jpg
