blemay360/Chessboard/Software/TestingImages/StandardSeries/1.jpg

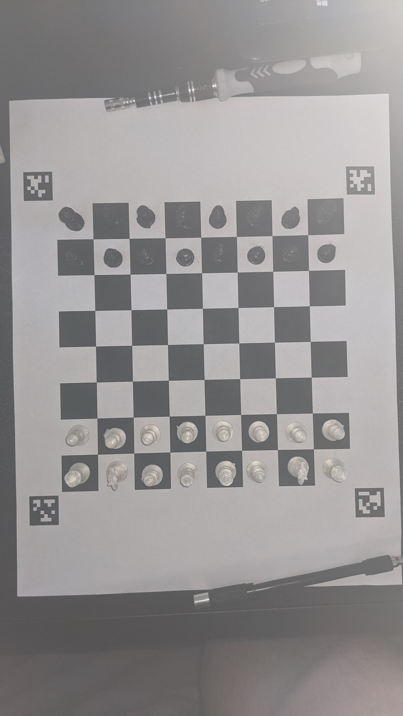
Software/TestingImages/StandardSeries/1.jpg
