blemay360/Chessboard/Software/TestingImages/StandardSeries/2.jpg

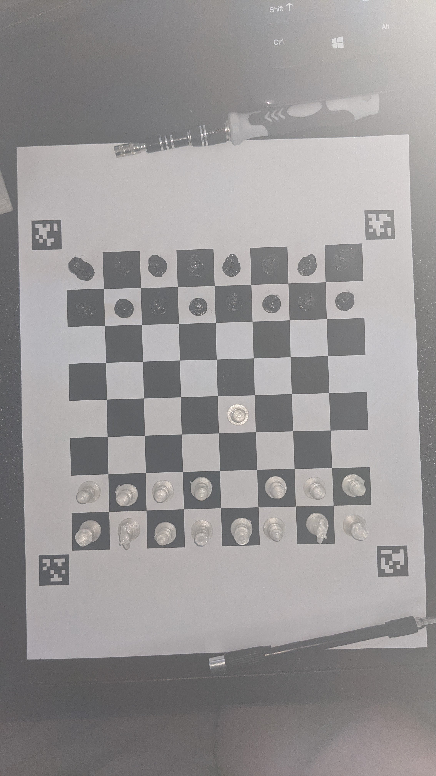
Software/TestingImages/StandardSeries/2.jpg
