blemay360/Chessboard/Software/TestingImages/StandardSeries/3.jpg

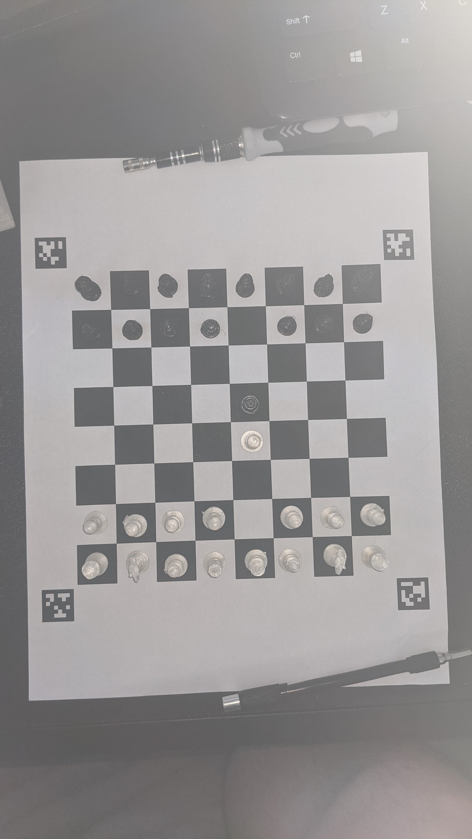
Software/TestingImages/StandardSeries/3.jpg
