blemay360/Chessboard/Software/TestingImages/StandardSeries/4.jpg

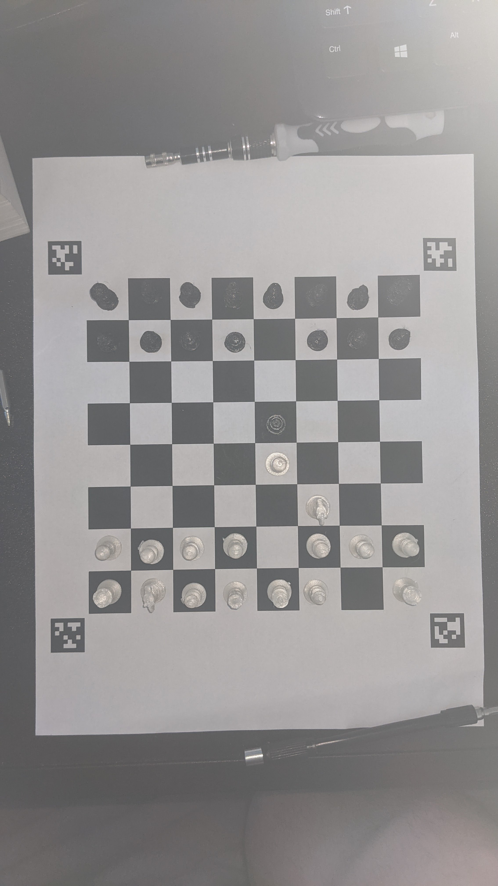
Software/TestingImages/StandardSeries/4.jpg
