blemay360/Chessboard/Software/TestingImages/StandardSeries/5.jpg

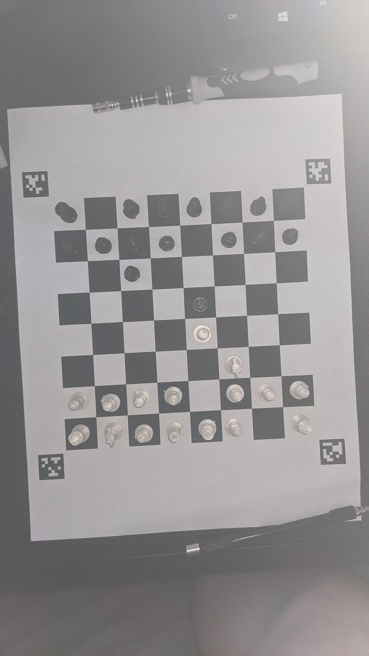
Software/TestingImages/StandardSeries/5.jpg
