blemay360/Chessboard/Software/TestingImages/StandardSeries/6.jpg

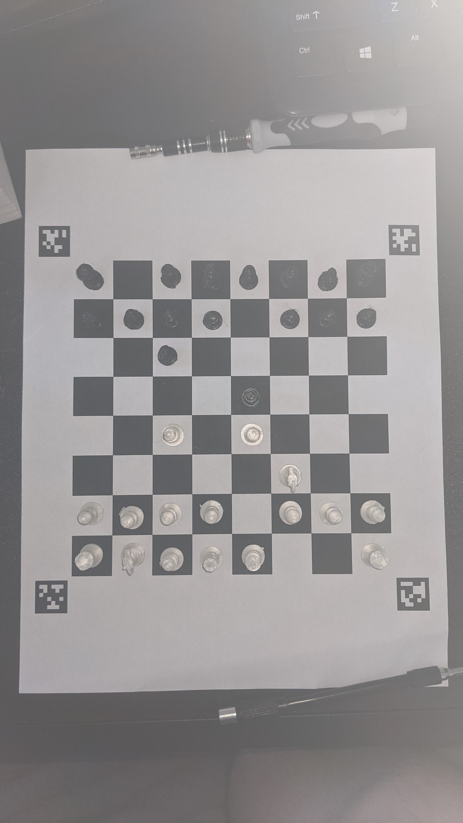
Software/TestingImages/StandardSeries/6.jpg
