blemay360/Chessboard/Software/TestingImages/StandardSeries/7.jpg

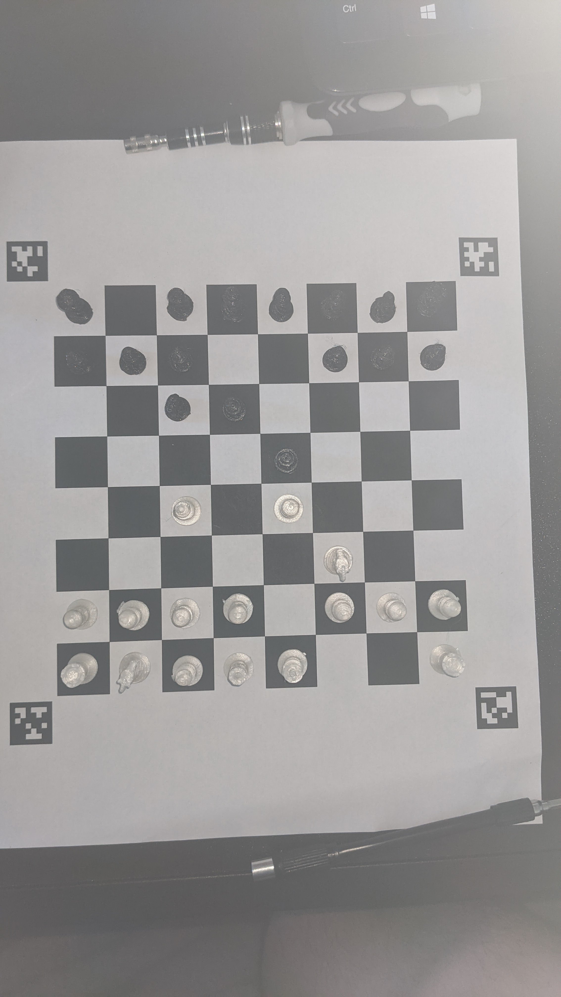
Software/TestingImages/StandardSeries/7.jpg
