blemay360/Chessboard/Software/TestingImages/StandardSeries/8.jpg

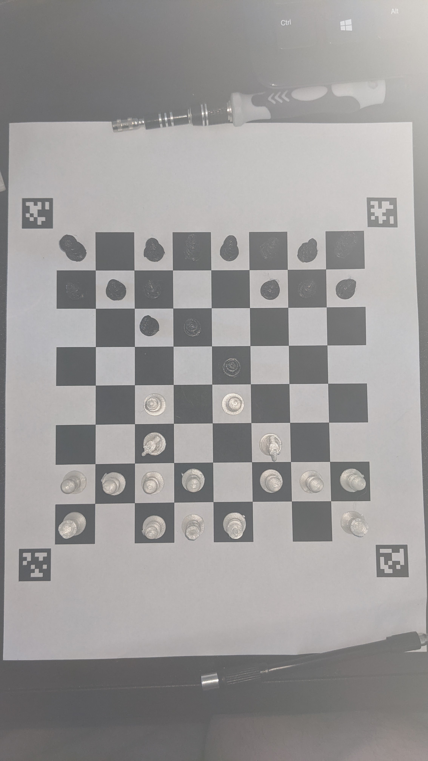
Software/TestingImages/StandardSeries/8.jpg
