blemay360/Chessboard/Software/TestingImages/StandardSeries/10.jpg

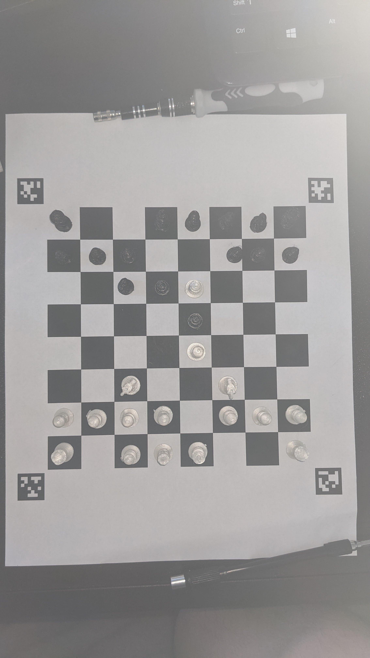
Software/TestingImages/StandardSeries/10.jpg
