blemay360/Chessboard/Software/TestingImages/StandardSeries/13.jpg

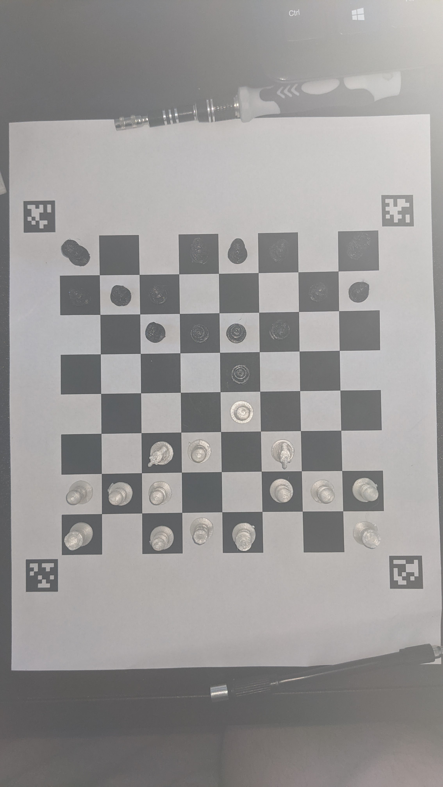
Software/TestingImages/StandardSeries/13.jpg
