blemay360/Chessboard/Software/TestingImages/StandardSeries/14.jpg

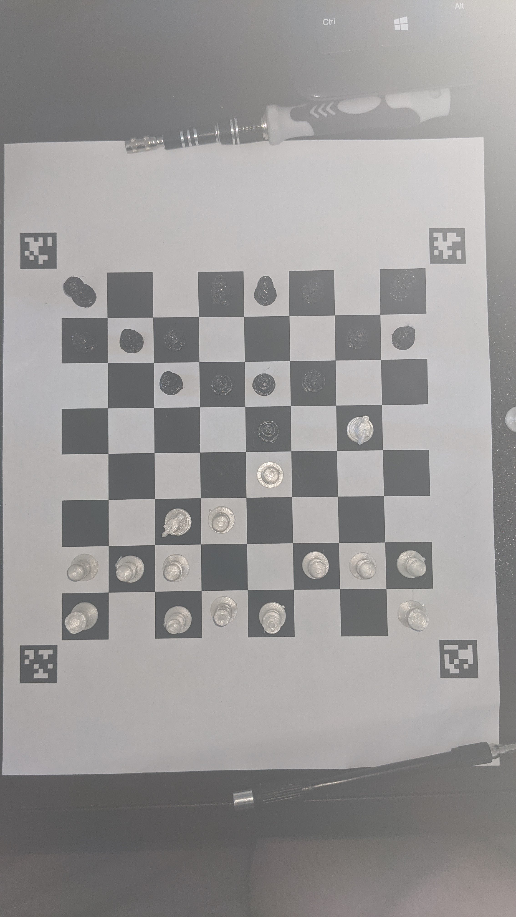
Software/TestingImages/StandardSeries/14.jpg
