blemay360/Chessboard/Software/TestingImages/StandardSeries/15.jpg

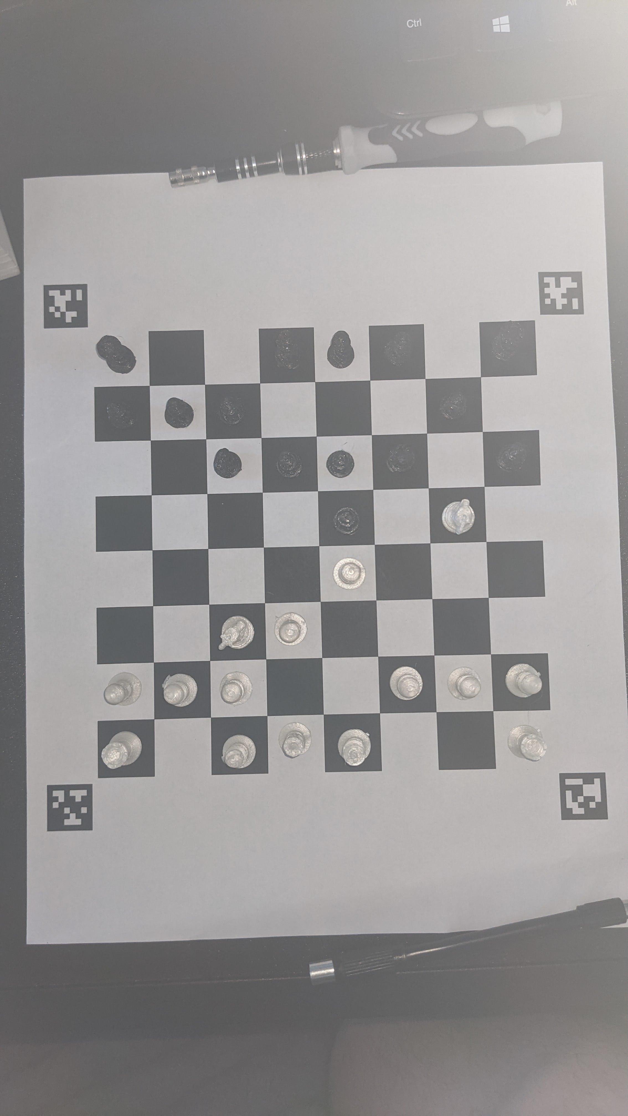
Software/TestingImages/StandardSeries/15.jpg
