blemay360/Chessboard/Software/TestingImages/StandardSeries/17.jpg

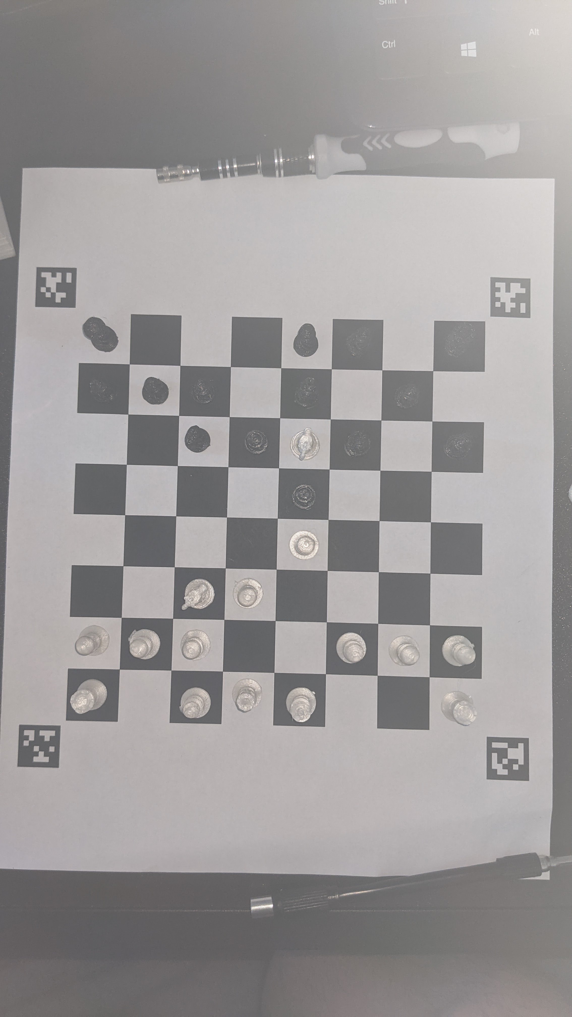
Software/TestingImages/StandardSeries/17.jpg
