blemay360/Chessboard/Software/TestingImages/StandardSeries/18.jpg

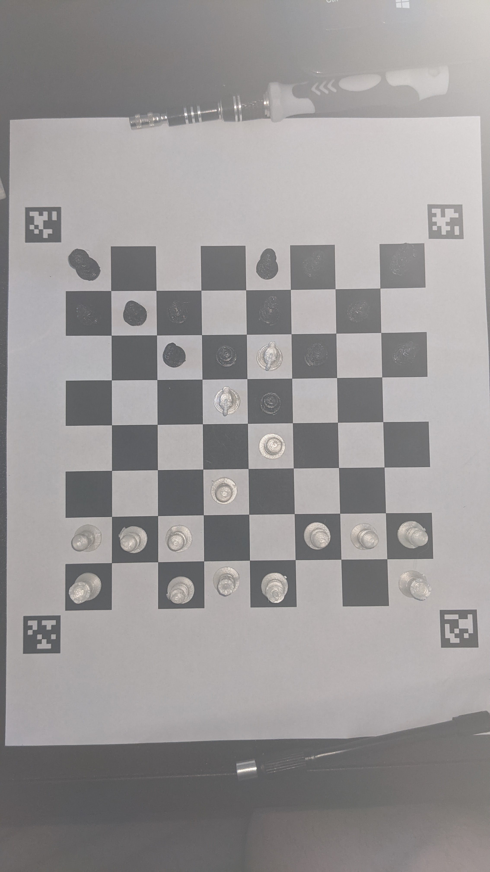
Software/TestingImages/StandardSeries/18.jpg
