blemay360/Chessboard/Software/TestingImages/StandardSeries/22.jpg

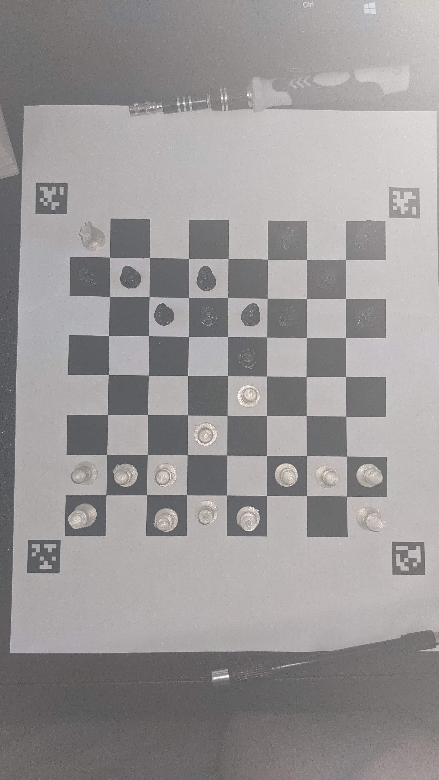
Software/TestingImages/StandardSeries/22.jpg
