blemay360/Chessboard/Software/TestingImages/StandardSeries/23.jpg

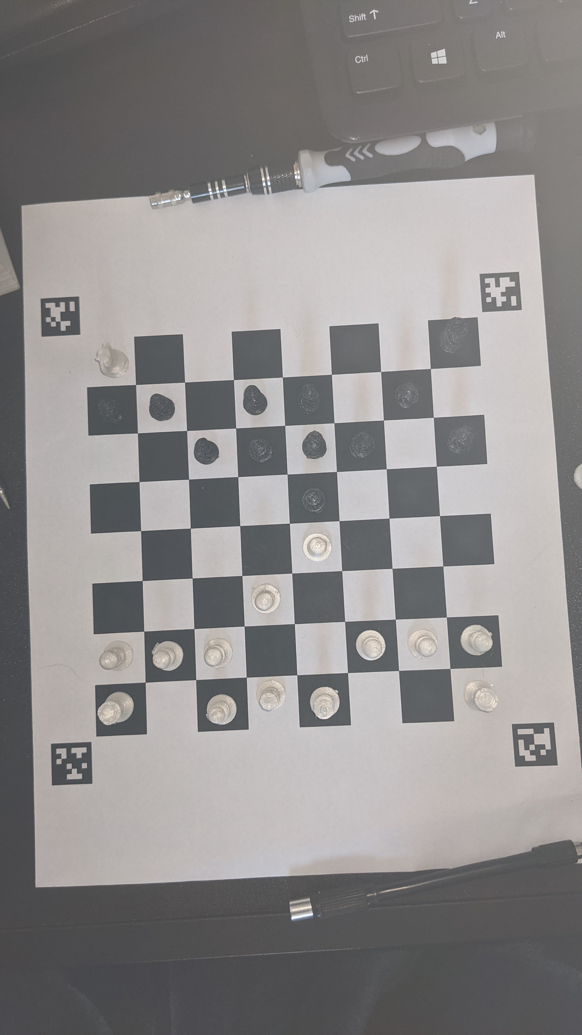
Software/TestingImages/StandardSeries/23.jpg
