blemay360/Chessboard/Software/TestingImages/StandardSeries/24.jpg

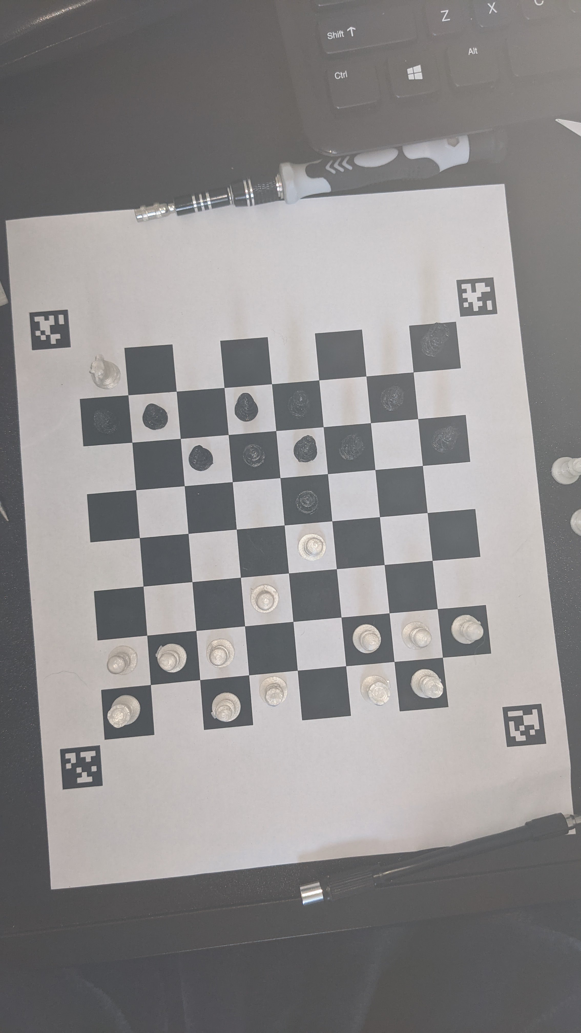
Software/TestingImages/StandardSeries/24.jpg
