blemay360/Chessboard/Software/TestingImages/StandardSeries/25.jpg

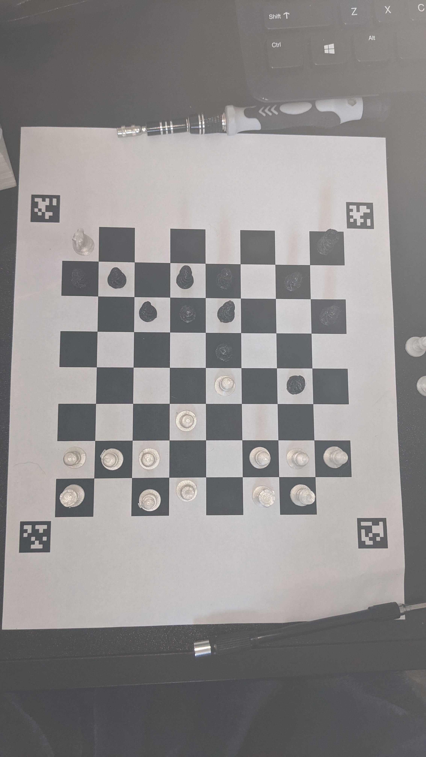
Software/TestingImages/StandardSeries/25.jpg
