blemay360/Chessboard/Software/TestingImages/StandardSeries/26.jpg

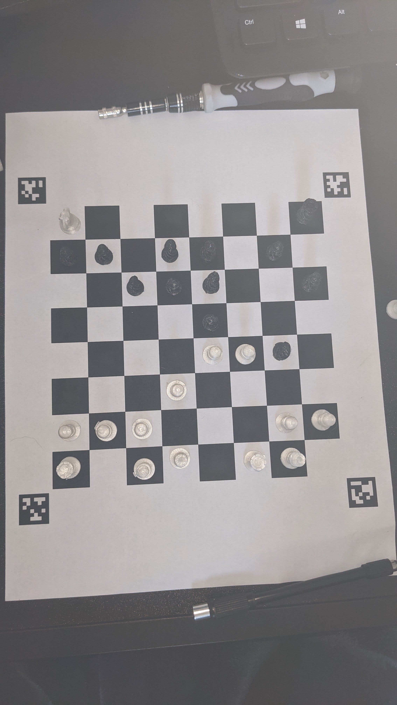
Software/TestingImages/StandardSeries/26.jpg
