blemay360/Chessboard/Software/TestingImages/StandardSeries/27.jpg

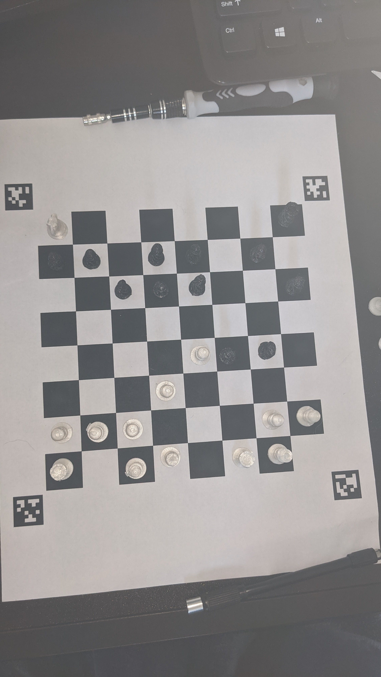
Software/TestingImages/StandardSeries/27.jpg
