blemay360/Chessboard/Software/TestingImages/StandardSeries/28.jpg

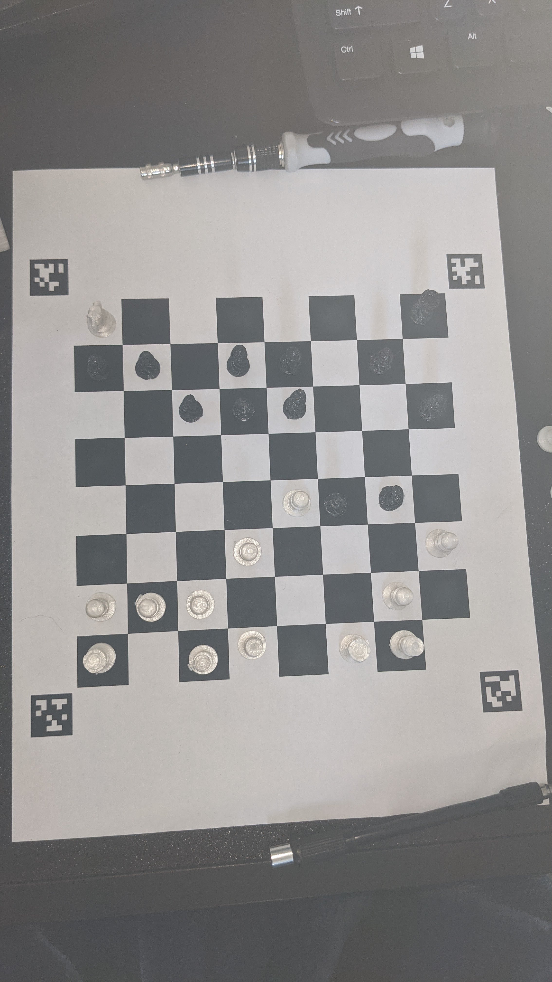
Software/TestingImages/StandardSeries/28.jpg
