blemay360/Chessboard/Software/TestingImages/StandardSeries/29.jpg

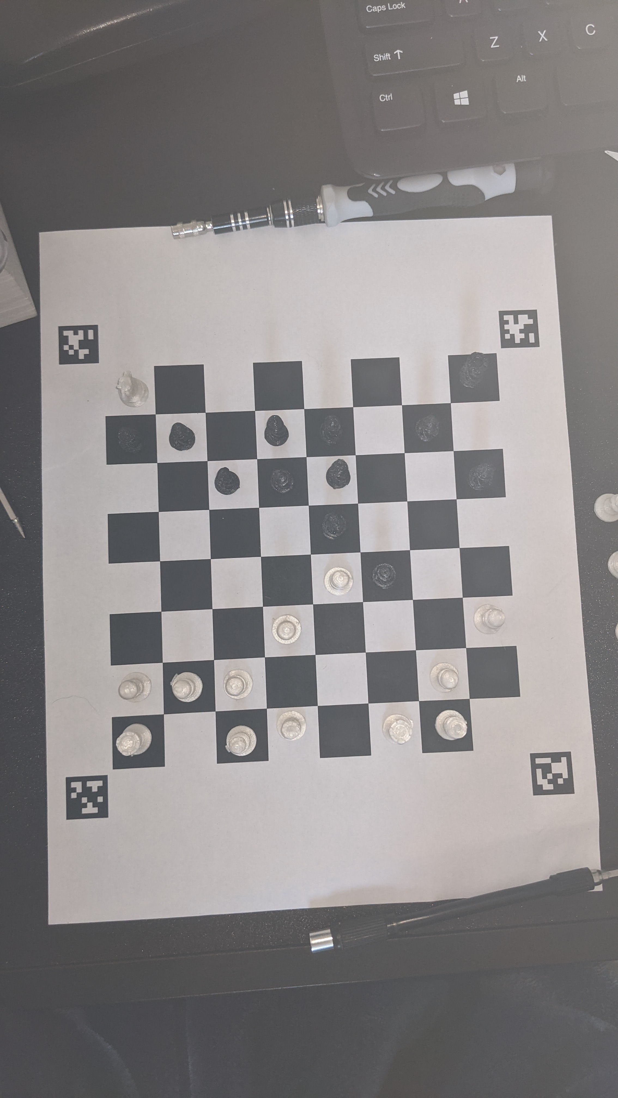
Software/TestingImages/StandardSeries/29.jpg
