blemay360/Chessboard/Software/TestingImages/StandardSeries/30.jpg

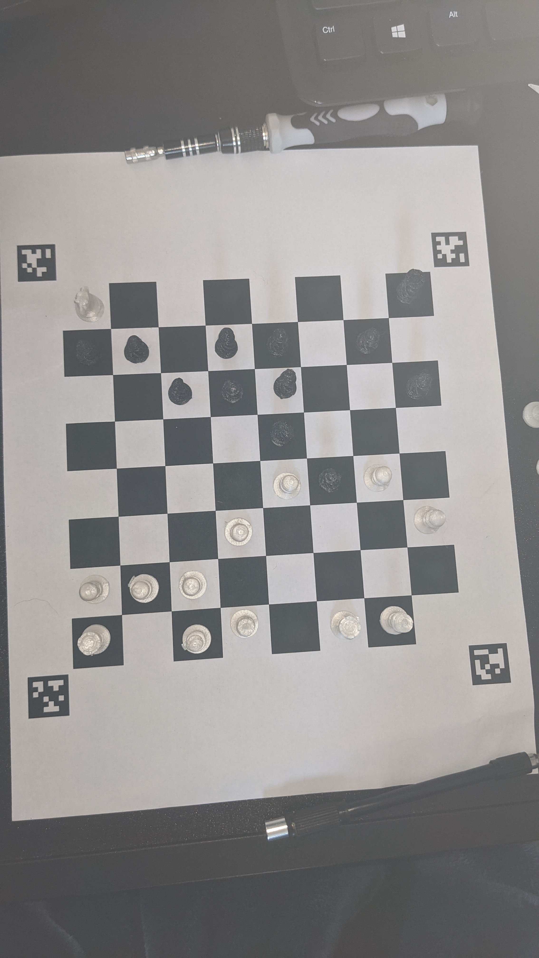
Software/TestingImages/StandardSeries/30.jpg
