blemay360/Chessboard/Software/TestingImages/StandardSeries/31.jpg

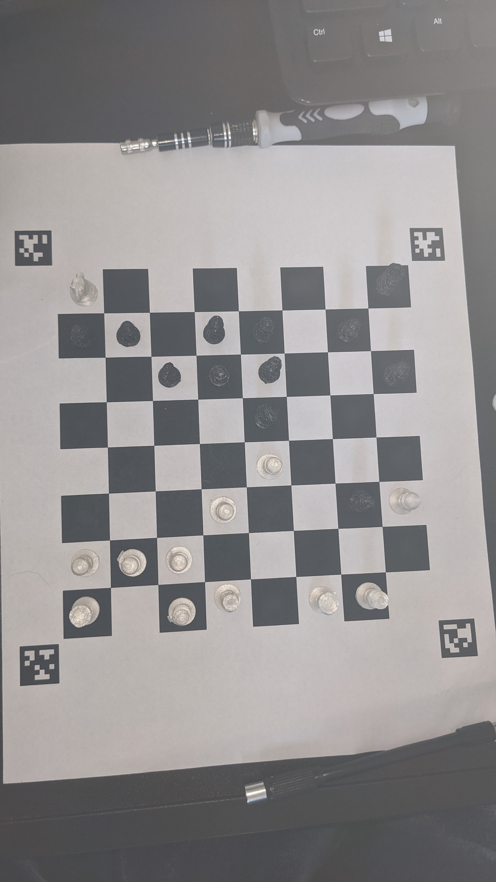
Software/TestingImages/StandardSeries/31.jpg
