blemay360/Chessboard/Software/TestingImages/StandardSeries/33.jpg

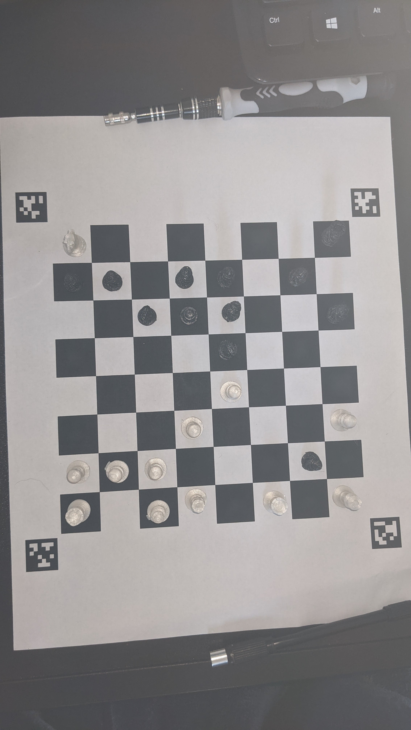
Software/TestingImages/StandardSeries/33.jpg
