blemay360/Chessboard/Software/TestingImages/StandardSeries/34.jpg

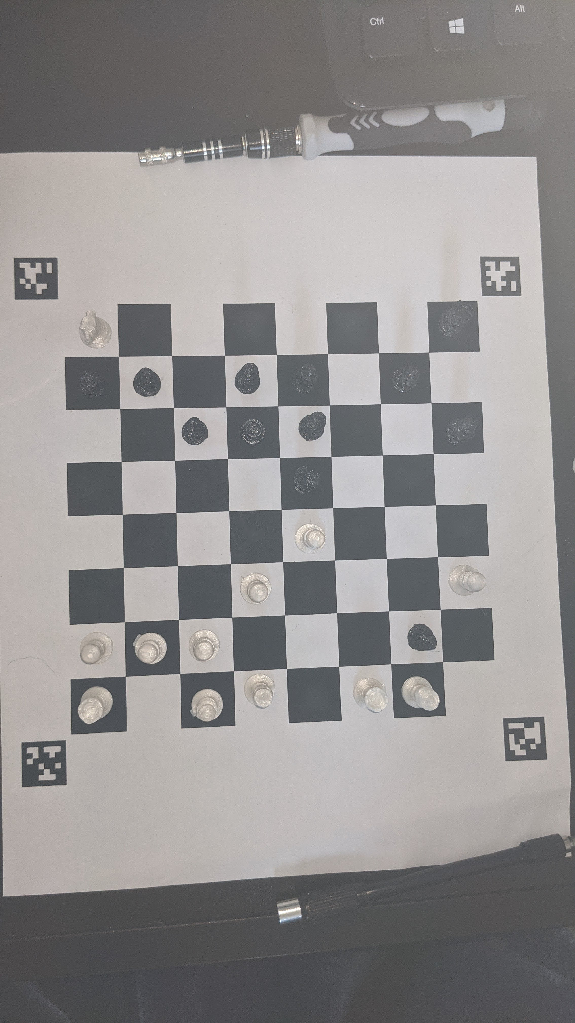
Software/TestingImages/StandardSeries/34.jpg
