blemay360/Chessboard/Software/TestingImages/StandardSeries/35.jpg

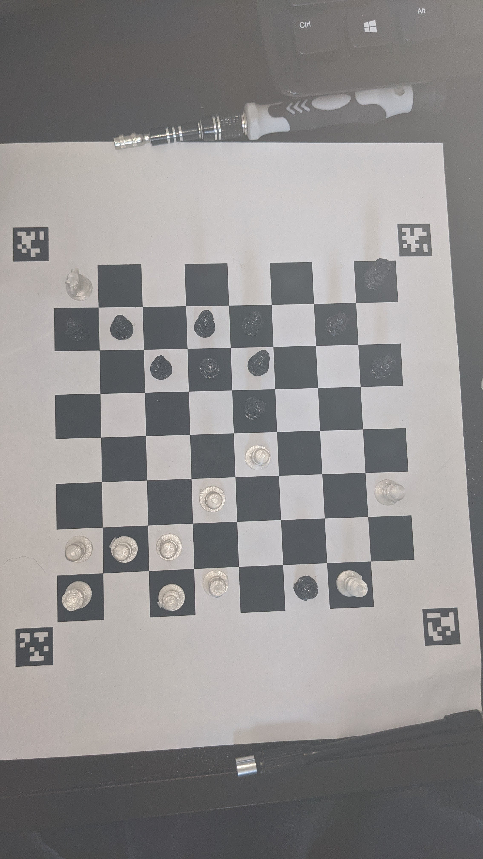
Software/TestingImages/StandardSeries/35.jpg
