blemay360/Chessboard/Software/TestingImages/Debugging/Wed May 19 12:32:13 2021.jpg

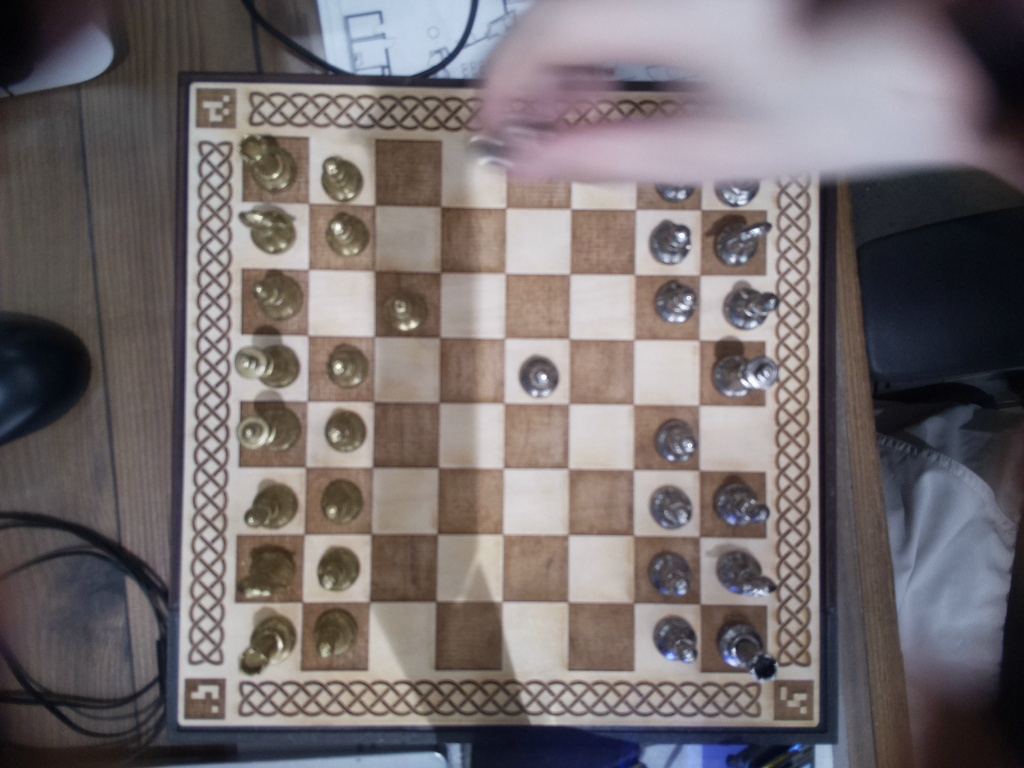
Software/TestingImages/Debugging/Wed May 19 12:32:13 2021.jpg
