blemay360/Chessboard/Software/TestingImages/Debugging/Wed May 19 12:33:01 2021.jpg

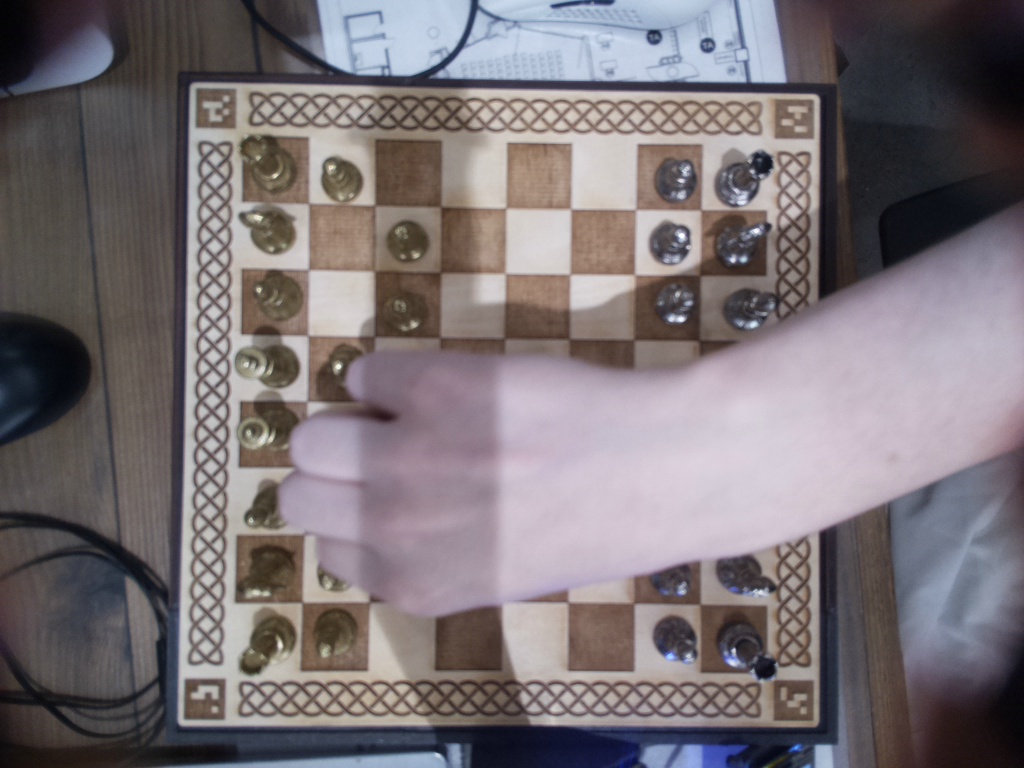
Software/TestingImages/Debugging/Wed May 19 12:33:01 2021.jpg
