blemay360/Chessboard/Electronics/ControlBoard/PCB Files/Control.brd

## EAGLE design Electronics/ControlBoard/PCB Files/Control.brd (2021-05-17)

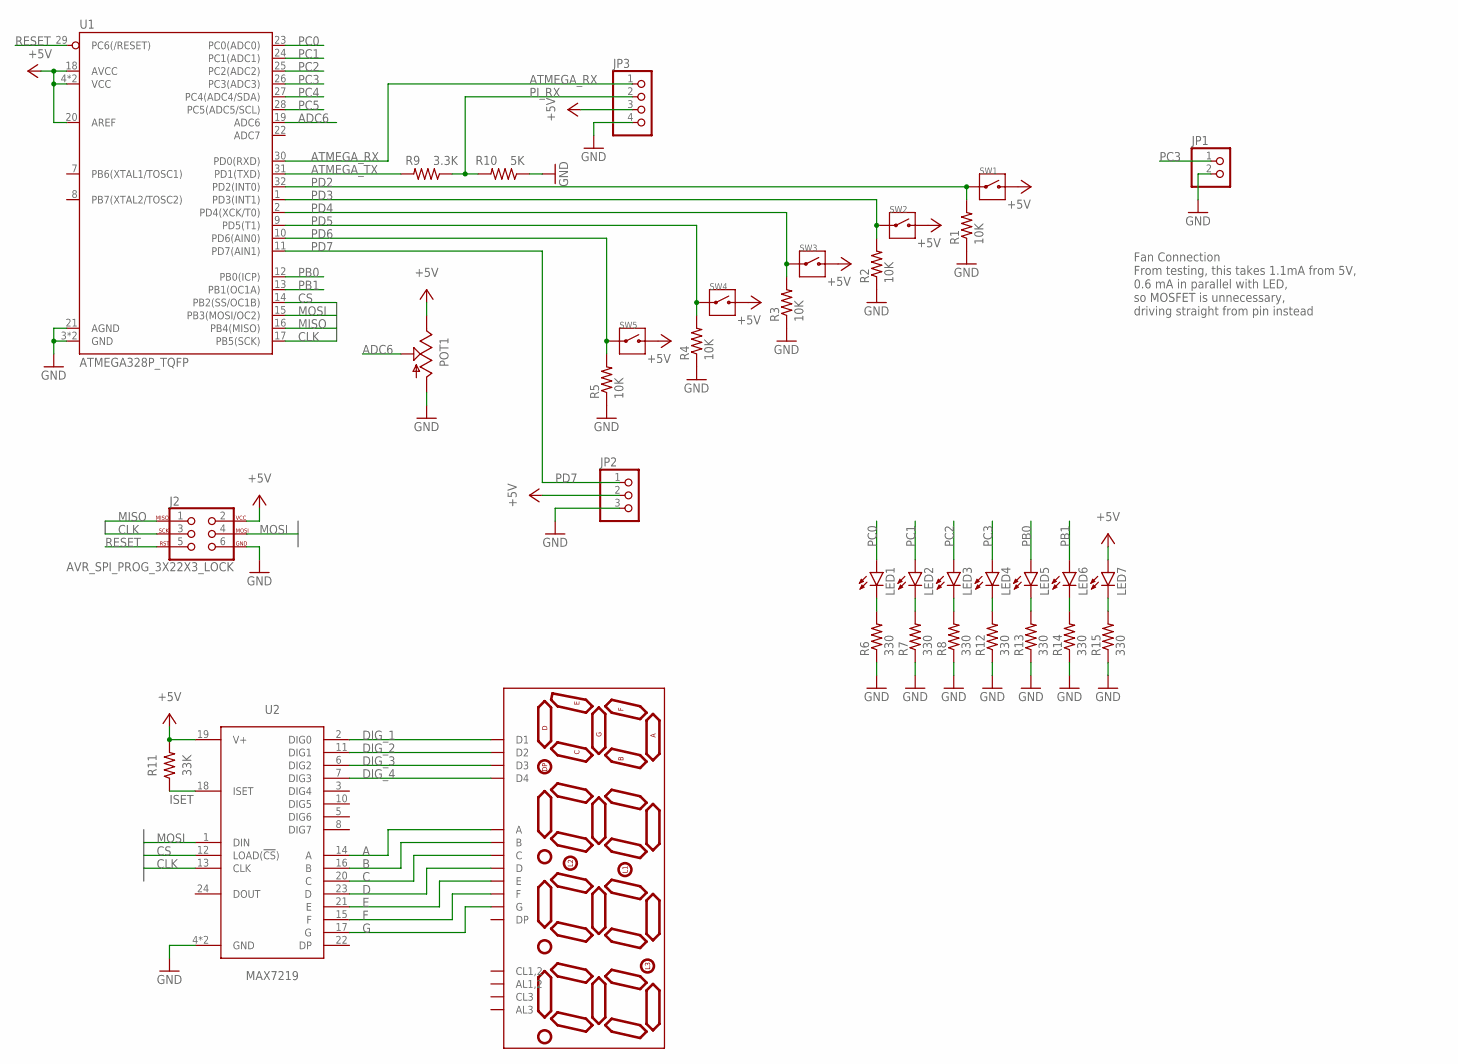
[picture p122: schematic Control.sch]

Parts:
DS1: TDCG1060M_COMMONCATHODE; TDCG1060M
J2: AVR_SPI_PROG_3X22X3_LOCK; 2X3_LOCK
JP1: PINHD-1X2; 1X02
JP2: PINHD-1X3; 1X03
JP3: PINHD-1X4; 1X04
LED1, LED2, LED3, LED4, LED5, LED6, LED7: LEDCHIP-LED0603; CHIP-LED0603
POT1: POT_PTV09A-4225F-B103
R1, R2, R3, R4, R5: 10K; R0603
R6, R7, R8, R12, R13, R14, R15: 330; R0603
R9: 3.3K; R0603
R10: 5K; R0603
R11: 33K; R0603
SW1, SW2, SW3, SW4, SW5: BUTTON; B3F-1000
U1: ATMEGA328P_TQFP; TQFP32-08
U2: MAX7219; SOIC127P1032X265-24N

Connections:
+5V: J2.2, JP2.2, JP3.3, LED7.A, POT1.3 (E), R11.2, SW1.3, SW1.4, SW2.3, SW2.4, SW3.3, SW3.4, SW4.3, SW4.4, SW5.3, SW5.4, U1.4 (VCC), U1.6 (VCC), U1.18 (AVCC), U1.20 (AREF), U2.19 (V+)
A: DS1.14 (A), U2.14 (A)
ADC6: POT1.2 (S), U1.19 (ADC6)
ATMEGA_RX: JP3.1, U1.30 (PD0(RXD))
ATMEGA_TX: R9.2, U1.31 (PD1(TXD))
B: DS1.16 (B), U2.16 (B)
C: DS1.13 (C), U2.20 (C)
CLK: J2.3, U1.17 (PB5(SCK)), U2.13 (CLK)
CS: U1.14 (PB2(SS/OC1B)), U2.12 (LOAD(!CS!))
D: DS1.3 (D), U2.23 (D)
DIG_1: DS1.1 (D1), U2.2 (DIG0)
DIG_2: DS1.2 (D2), U2.11 (DIG1)
DIG_3: DS1.6 (D3), U2.6 (DIG2)
DIG_4: DS1.8 (D4), U2.7 (DIG3)
E: DS1.5 (E), U2.21 (E)
F: DS1.11 (F), U2.15 (F)
G: DS1.15 (G), U2.17 (G)
GND: J2.6, JP1.2, JP2.3, JP3.4, POT1.1 (A), R1.1, R2.1, R3.1, R4.1, R5.1, R6.1, R7.1, R8.1, R10.1, R12.1, R13.1, R14.1, R15.1, U1.3 (GND), U1.5 (GND), U1.21 (AGND), U2.4 (GND), U2.9 (GND)
ISET: R11.1, U2.18 (ISET)
MISO: J2.1, U1.16 (PB4(MISO))
MOSI: J2.4, U1.15 (PB3(MOSI/OC2)), U2.1 (DIN)
unnamed: LED1.C, R6.2
unnamed: LED2.C, R7.2
unnamed: LED3.C, R8.2
unnamed: LED4.C, R12.2
unnamed: LED5.C, R13.2
unnamed: LED6.C, R14.2
unnamed: LED7.C, R15.2
PB0: LED5.A, U1.12 (PB0(ICP))
PB1: LED6.A, U1.13 (PB1(OC1A))
PC0: LED1.A, U1.23 (PC0(ADC0))
PC1: LED2.A, U1.24 (PC1(ADC1))
PC2: LED3.A, U1.25 (PC2(ADC2))
PC3: JP1.1, LED4.A, U1.26 (PC3(ADC3))
PC4: U1.27 (PC4(ADC4/SDA))
PC5: U1.28 (PC5(ADC5/SCL))
PD2: R1.2, SW1.1, SW1.2, U1.32 (PD2(INT0))
PD3: R2.2, SW2.1, SW2.2, U1.1 (PD3(INT1))
PD4: R3.2, SW3.1, SW3.2, U1.2 (PD4(XCK/T0))
PD5: R4.2, SW4.1, SW4.2, U1.9 (PD5(T1))
PD6: R5.2, SW5.1, SW5.2, U1.10 (PD6(AIN0))
PD7: JP2.1, U1.11 (PD7(AIN1))
PI_RX: JP3.2, R9.1, R10.2
RESET: J2.5, U1.29 (PC6(/RESET))

Notes on the sheet:
Fan Connection From testing, this takes 1.1mA from 5V, 0.6 mA in parallel with LED, so MOSFET is unnecessary, driving straight from pin instead

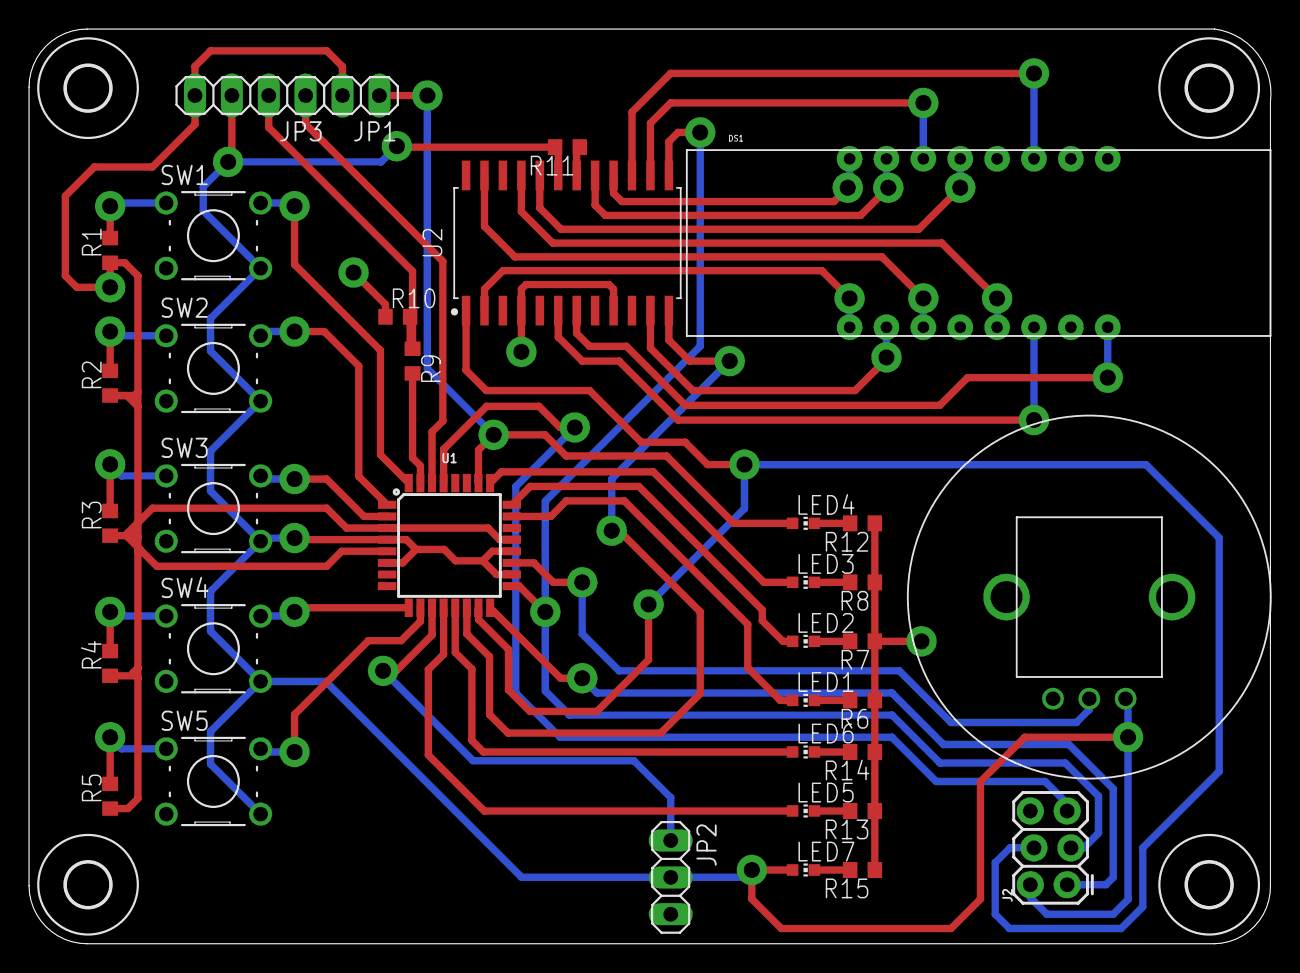
[picture p123: board Control.brd from above]

Board: 2 copper layers, 85.5 x 63.0 mm, 39 parts (0 on the bottom side), 42 nets.

Other parts of the board:
U$2, U$3, U$4, U$5: 3,0
