blemay360/Chessboard/Software/Chessboard.py

#Variables to change stuff on a high level
#Whether to display any extra info windows
display = [False, False, False, False, True] #[0, 1, 2, 3, 4] 0 displays input frame 1 displays  apriltag detection, 2 displays knot detection, 3 displays piece edge detection, 4 displays color
#How long to pause in milliseconds after displaying an image. 0 waits until a key is pressed
wait = 0
#Whether to play against a computer
vs_comp = False
#Whether to process frames from a video and save output
process_video=False
#File directory to get images from
image_directory = 'TestingImages/Debugging/'

#Importing needed libraries
import contextlib
with contextlib.redirect_stdout(None):
    import pygame
import chess, time, pygame, chess.engine, cv2, copy, math, os, sys, imutils
import numpy as np
from apriltag import apriltag
from sklearn.cluster import KMeans

#If run on my laptop, disable pi specific code
if (os.uname()[1] == "blemay360-Swift-SF314-53G"):
    #print("Running on laptop")
    pi = False
#Else enable pi code
else:
    #print("Running on pi")
    pi = True

#Import pi specific libraries
if pi:
    from picamera.array import PiRGBArray
    from picamera import PiCamera

'''
-----------------------------------------TO DO--------------------------------------------------
Look into discarding frames on consececutive frames being similar
Test error detection for get_detection_array 
    Take off two pieces at once
    Add an extra piece
Add adaptive thresholding to get_detection_array
'''

def end_program():
    global engine
    engine.quit()

#-----------------------------------------APRILTAG FUNCTIONS
def detect_apriltags(family, image, previous_detections=False):
    global wait
    '''
    Takes a family of apriltags to look for, as well as an image to look at, and returns an array with a dictionary of detection info for each apriltag detected in the image
    '''
    #Only needs to be done once, but for ease of coding we'll do it every function call
    detector = apriltag(family)
        
    #Convert input image to grayscale
    gray_img = cv2.cvtColor(image, cv2.COLOR_BGR2GRAY) 

    #If we have the previous location for each tag and already know where to look
    if previous_detections and not any(map(lambda ele: ele is None, previous_detections)):
        #For reference, on a sample image, measuring the entire image of 4 apriltags took 0.7629 seconds, one cropped apriltag took 0.0028 seconds
        #Empty list to add dictionaries for each tag to
        detection_list = []
        #Percent to increase the corner location of the window
        percent_increase = 1.3
        #Dictionary to help cycle through each corner
        corners_dict = {0:'lb', 1:'rb', 2:'rt', 3:'lt'}
        #Go through each tag
        for tag_id in range(4):
            #Find the lowest y value of the top two tag corners
            top = min(return_tag_info(previous_detections, tag_id, 'lt')[1], return_tag_info(previous_detections, tag_id, 'rt')[1])
            #Find the highest y value of the lower two tag corners
            bottom = max(return_tag_info(previous_detections, tag_id, 'lb')[1], return_tag_info(previous_detections, tag_id, 'rb')[1])
            #Find the lowest x value of the left 80two tag corners
            left = min(return_tag_info(previous_detections, tag_id, 'lt')[0], return_tag_info(previous_detections, tag_id, 'lb')[0])
            #Find the highest x value of the right two tag corners
            right = max(return_tag_info(previous_detections, tag_id, 'rt')[0], return_tag_info(previous_detections, tag_id, 'rb')[0])
            
            #If any of the values above aren't found, return None to search whole image
            if (top == -1) or (bottom == -1) or (left == -1) or (right == -1):
                detection_list = [None, None, None, None]
                break
            
            #Slightly increase the window to look for the apriltag in
            top = bottom - int(percent_increase * abs(bottom - top))
            bottom = top + int(percent_increase * abs(bottom - top))
            left = right - int(percent_increase * abs(right - left))
            right = left + int(percent_increase * abs(right - left))
            
            #Search for an apriltag in the area arounnd the last seen tag
            detections = detector.detect(gray_img[top:bottom, left:right])
            
            #If there was an apriltag detected
            if (detections != ()):
                #Offset the coordinates from the detections to apply to the whole image, not the closely cropped one
                offset_center = (return_tag_info(detections, tag_id, 'center')[0] + left, return_tag_info(detections, tag_id, 'center')[1] + top)
                #Initialize list to store the coordinates of the offset coordinates
                offset_corners = [0] * 4
                #Go through each corner to offset the coordinates
                for i in range(4):
                    #Offset coordinates for the cuurent corner and add to the offset_corners list
                    offset_corners[i] = [return_tag_info(detections, tag_id, corners_dict[i])[0] + left, return_tag_info(detections, tag_id, corners_dict[i])[1] + top]
                #Reconstruct dictionary for the current tag and append to the list of tags
                detection_list.append({'hamming':return_tag_info(detections, tag_id, 'hamming'), 'margin':return_tag_info(detections, tag_id, 'margin'), 'id':return_tag_info(detections, tag_id, 'id'), 'center':offset_center, 'lb-rb-rt-lt':offset_corners})
            else:
                detection_list.append(None)
                
        #Convert list of detections to tuple to return to original variable type
        detections = tuple(detection_list)
    else:
        detections = None

    if not previous_detections or any(map(lambda ele: ele is None, detections)):
        #Look for apriltags
        detections = detector.detect(gray_img)
        
        #Make an empty list to add tags with the correct ids
        pruned_detection_list = []
        #Make an empty list to add margins to only keep best tags of each id
        margin_list = [0]*4
        #For each detected tag
        for tag in detections:
            #If the tag id is 0, 1, 2, or 3 and the detection confidence is good
            if (tag['id'] < 4) and (tag['margin'] > 5):
                if (tag['margin'] > margin_list[tag['id']]):
                    #Add the tag info to the detection list
                    pruned_detection_list.append(tag)
                    margin_list[tag['id']] = tag['margin']
        #Replace the old detection tuple with the new modified detection list
        detections = tuple(pruned_detection_list)
        
        #If the detections are under 4
        if (len(detections) < 4):
                #print("Missing an apriltag")
                #print("Apriltags found: " + str(len(detections)))
                #print(detections)
                ##Set the window to be able to be resized
                #cv2.namedWindow("Input Image", cv2.WINDOW_NORMAL)
                ##Resize the window
                #if pi:
                    #cv2.resizeWindow("Input Image", 200, 200)
                #else:
                    #cv2.resizeWindow("Input Image", 700, 700)
                ##Show the image
                #cv2.imshow("Input Image", image)
                ##Wait for a keypress
                #cv2.waitKey(wait)
                #Return empty list
                return detections, False
        #If there are extra apriltags detected with duplicate ids
        elif (len(detections) > 4):
            #print("Detected Extra Apriltag")
            #Sort the detection list by descending confidence in tag detection
            pruned_detection_list.sort(reverse=True, key=return_tag_margin)
            #Remove the lowest confidence tags until only 4 are left
            for i in range(len(detections) - 4):
                #Remove the last value in the sorted list
                pruned_detection_list.pop()
            #Sort the list by tag id to return it to the original order
            pruned_detection_list.sort(key=return_tag_id)
            #Replace the previous detection tuple by the modified one
            detections = tuple(pruned_detection_list)
    elif (any(map(lambda ele: ele is None, detections))):
        return detections, False
    
    #Return variable with detected apriltag info
    return detections, True

def return_tag_info(detections, tag_id, info='center'):
    '''
    Function to easily parse the apriltag detection array
    Takes in the detection array, the desired tag to get info for, as well as the desired vertex to get the coordinates for
    '''
    
    index = None
    for tag in range(len(detections)):
        if (detections[tag]['id'] == tag_id):
            index = tag
            
    if (index == None):
        #print("Error finding apriltag " + str(tag_id))
        return (-1, -1)
    
    #If the info variable isn't there or is 'center'
    if (info == 'center'):
        #Set x value of the center coordinate
        x = detections[index]['center'][0]
        #Set y value of the center coordinate
        y = detections[index]['center'][1]
        #Output is the x and y coordinates in a tuple, rounded and cast to ints to the nearest pixel
        output = (int(round(x)), int(round(y)))
    #If the info variable is asking for hamming
    elif (info == 'hamming'):
        output = detections[index]['hamming']
    #If the info variable is asking for hamming
    elif (info == 'margin'):
        output = detections[index]['margin']
        #If the info variable is asking for hamming
    elif (info == 'id'):
        output = detections[index]['id']
    #Otherwise if the desired coordinate is not the center
    else:
        #Dictionary for converting from text descriptions of the corners to the index of the info coordinate in the apriltag array
        corner_dict = { 'lb':0, 'rb':1, 'rt':2, 'lt':3 }
        #Set x value of the info coordinate
        x = detections[index]['lb-rb-rt-lt'][corner_dict[info]][0]
        #Set y value of the info coordinate
        y = detections[index]['lb-rb-rt-lt'][corner_dict[info]][1]
        #Output is the x and y coordinates in a tuple, rounded and cast to ints to the nearest pixel
        output = (int(round(x)), int(round(y)))
    return output

def grab_inside_corners(detections):
    '''
    Function for returning the inner coordinates of the apriltags on the chessboard
    Takes the detection array in as an input, and uses the return_tag_info function to get the corner coordinates of each tag
    Returns each corner in a 4 element list
    '''
    lt = return_tag_info(detections, 0, 'rb')
    rt = return_tag_info(detections, 1, 'lb')
    rb = return_tag_info(detections, 3, 'lt')
    lb = return_tag_info(detections, 2, 'rt')
    return lt, rt, lb, rb

def grab_outside_corners(detections):
    '''
    Function for returning the inner coordinates of the apriltags on the chessboard
    Takes the detection array in as an input, and uses the return_tag_info function to get the corner coordinates of each tag
    Returns each corner in a 4 element list
    '''
    lt = return_tag_info(detections, 0, 'lt')
    rt = return_tag_info(detections, 1, 'rt')
    rb = return_tag_info(detections, 3, 'rb')
    lb = return_tag_info(detections, 2, 'lb')
    return lt, rt, lb, rb

def return_tag_margin(input_list):
    return input_list['margin']

def return_tag_id(input_list):
    return input_list['id']

#-----------------------------------------IMAGE UTILITIES
def copy_image(image, num_copies):
    '''
    Function to return any number of copies of an image
    Takes in the image as an input, as well as the number of copies to make
    '''
    #Start the output as a one element tuple containing a copy of the input image
    output = (copy.copy(image),)
    
    #Iterate for num_copies - 1 times to copy the rest of the images needed
    for i in range(num_copies - 1):
        #Add the other copied images to the output tuple
        output = output + (copy.copy(image),)
        
    return output

def measure_distance(pt1, pt2):
    '''
    Function to clean up lines where distance measuring is needed
    Takes in two coordinates as input
    Uses pythagorean theorem to calculate distance
    Distance is returned as an int
    '''
    return int(math.sqrt((pt1[0] - pt2[0])**2 + (pt1[1] - pt2[1])**2)) 

def measure_angle(pt1, pt2):
    theta = abs(math.atan2(pt2[1] - pt1[1], pt2[0] - pt1[0]))
    if (theta < 1.6) and (theta > 1.5):
        return 1
    elif (theta < 0.1) and (theta > 0):
        return 0
    else:
        return "Trigger a type error in measure_angle"

def circle_image(image, coordinates, color, ratio):
    '''
    Add circles to a given image
    WON'T WORK FOR TWO COORDINATES!!
    Takes the image to add a circle to as an argument, as well as the coordinates at which to place the circle, the color to make the circle, and whether the image is from a picture or video, which changes the ratio and thus the desired radius of the circle
    Doesn't return anything
    '''
    #Color definition dictionary
    color_dict = {'blue':(255, 0, 0), 'green':(0, 255, 0), 'red':(0, 0, 255)}
    
    #Fill entire circle
    thickness = -1

    #If the image is from a picture, use a large radius circle to make the circle more visible on a large picture
    if (ratio == 'picture'):
        radius = 12
    elif (isinstance(ratio, int)):
        radius = ratio
    #If the image is from a video, use a small radius circle so as to not take up too much space
    else:
        radius = 3

    #If there are multiple circles to add to the picture
    if (len(coordinates) > 2):
        #Cycle through all the coordinates
        for i in range(len(coordinates)):
            #Add a circle to the image at coordinates[i]
            cv2.circle(image, coordinates[i], radius, color_dict[color], thickness)
    #If there is only one circle to add
    else:
        #Add circle to image
        cv2.circle(image, coordinates, radius, color_dict[color], thickness)
        
def show_images(*arg):
    '''
    Function to display any number of images at once
    If the images are very large and need to be resized, the first argument should be 'resize'
    Takes in tuples of the name of the window and the image to display
    Returns nothing
    '''
    #If the images are very large and need to be resized
    if (arg[0] == 'resize'):
        #If displaying on the pi
        if pi:
            #Iterate through each image, skipping the first argument
            for i in range(1, len(arg)):
                #Set the window to be able to be resized
                cv2.namedWindow(arg[i][0], cv2.WINDOW_NORMAL)
                #Resize the window to 200 by 200 pixels
                cv2.resizeWindow(arg[i][0], 200,200)
                #Show the image
                cv2.imshow(arg[i][0], arg[i][1])
        else:
            #Iterate through each image, skipping the first argument
            for i in range(1, len(arg)):
                #Set the window to be able to be resized
                cv2.namedWindow(arg[i][0], cv2.WINDOW_NORMAL)
                #Resize the window to 700 by 700 pixels
                cv2.resizeWindow(arg[i][0], 700,700)
                #Show the image
                cv2.imshow(arg[i][0], arg[i][1])
    #If the images should be displayed as is
    else:
        #Cycle through all the images
        for i in range(len(arg)):
            #Diplay the image
            cv2.imshow(arg[i][0], arg[i][1])

def get_hist(image):
    hsv_image = cv2.cvtColor(image, cv2.COLOR_BGR2HSV)
    
    h_bins = 50
    s_bins = 60
    histSize = [h_bins, s_bins]
    
    # hue varies from 0 to 179, saturation from 0 to 255
    h_ranges = [0, 180]
    s_ranges = [0, 256]
    ranges = h_ranges + s_ranges # concat lists

    # Use the 0-th and 1-st channels
    channels = [0, 1]
    
    hist = cv2.calcHist([hsv_image], channels, None, histSize, ranges, accumulate=False)
    cv2.normalize(hist, hist, alpha=0, beta=1, norm_type=cv2.NORM_MINMAX)
    
    return hist

#-----------------------------------------IMAGE DETECTION FUNCTIONS
def perspective_shift(image, corners):
    '''
    Function to perform a perspectivve shift on an image
    Used to cut out unnecessary parts of the image and just focus on the chessboard, as well as make sectioning the chessboard easier
    Takes in the image to shift, as well as the coordinates of the image that should become the new corners of the image
    Returns the shifted image
    '''
    #Measure the distance of each size of the chessboard and keep the maximum length
    distance = max(measure_distance(corners[0], corners[1]), measure_distance(corners[1], corners[2]), measure_distance(corners[2], corners[3]), measure_distance(corners[3], corners[0]))
    
    #Convert the input corner coordinates to float
    pts1 = np.float32(corners)
    #Set the size of the output image to be the maximum chess side length of pixels from the input image and convert to float
    pts2 = np.float32([[0,0],[distance,0],[0,distance],[distance,distance]])
    
    #Get matrix with which to shift the image using the coordinates of corners from the input image and the coordinates of where those points should be in the output image
    M = cv2.getPerspectiveTransform(pts1,pts2)
    #Perform perspective shift
    shifted_image = cv2.warpPerspective(image, M, (distance,distance))
    
    return shifted_image

#Default edge_count_threshold, gets updated on first frame to better suit current conditions
edge_count_threshold = 50000

def get_detection_color_array(image, turn_background, first_frame=False):
    global edge_count_threshold, wait
    '''
    Function to detect pieces on a chessboard
    Takes in an image of just the chessboard, perspective shifted, and the amount of pieces on the board in the previous frame to help with thresholding
    Returns the input image with each square replaced with its edge detection array and color coded squares showing which squares are deemed to have pieces in them
    The rectangles used for edge detection are the inside parts of the squares of the chessboard
    Each square was made to be 10 x 10 pixels before being scaled up, 10% of the square width is taken off when calculating corner coordinates, so the measured rectangle ends up being the inside 8 x 8 of the square
    A white rectange means a piece was detected, a black rectangle means the square is empty
    '''
    
    add_text_to_image = True
    
    #Make a copy of the input image to modify to show detection
    detection_image = copy.copy(image)
    color_image = cv2.cvtColor(copy.copy(image), cv2.COLOR_BGR2HSV)
    #color_image = copy.copy(image)
    color_image = np.stack((color_image[:,:,0],) *3, axis=-1)
     
    #Rectangle color for empty squares
    empty_color = (0, 0, 0)
    #Rectangle color for filled squares
    occupied_color = (255, 255, 255)
    
    if pi:
        #Size of text to add to image
        text_size = 0.25
        #Thickness of text to add to image
        text_thickness = 1
        #Thickness of lines to draw on image
        line_thickness = 4
    else:
        #Size of text to add to image
        text_size = 0.75
        #Thickness of text to add to image
        text_thickness = 4
        #Thickness of lines to draw on image
        line_thickness = 3
    
    #Size of the input image, assumed to be a square because the input image should be perspective shifted
    size = detection_image.shape[0]
    #Calculate the size of a pixel on the paper (NOT an actual pixel, the pixel here refers to creating the chessboard)
    #The apriltag is separated from the chessboard by one pixel, each square of the chessboard is 10 pixels wide, meaning 82 pixels for the width/height of the input image
    pixel = size / 82
    #Amount of space to move inwards from the corner of the square when setting up the region of interest
    margin = 1
    
    #Initialize array for storing the edge count of each square of the chessboard
    edge_count = np.zeros((8, 8), dtype=int)
    #Initialize array for storing the determination for whether each square is occupied
    detection_array = np.zeros((8, 8), dtype=int)
    #Initialize array for storing the color of each piece
    color_array = np.zeros((8, 8), dtype=int)
    
    if first_frame:
        #Initialize list to store the amount of edges detected in each occupied square
        occupied_edge_count = [0] * 32
    
    #Iterate through each rank of the chessboard
    for y in range(8):
        #Iterate through each file of the chessboard
        for x in range(8):
            #Calculate the coordinates of the upper left corner of the rectangle to be measured
            lt = (int(round(pixel + margin * pixel + 10 * pixel * x)), int(round(pixel + margin * pixel + 10 * pixel * y)))
            #Calculate the coordinates of the lower right corner off the rectange to be measured
            rb = (int(round(pixel +10 * pixel * (x + 1) - margin * pixel)), int(round(pixel + 10 * pixel * (y + 1) - margin * pixel)))
            
            #Crop out only the current square for analysis
            square = detection_image[lt[1]:rb[1], lt[0]:rb[0]]
            
            #Perform edge detection on the square, replacing the relevant part of the input image with the edge detection array, storing the edge count in the edge_count array, and taking in the center of mass of the detected edges as well as the standard deviation of points
            detection_image[lt[1]:rb[1], lt[0]:rb[0]], edge_count[y][x], x_average, y_average, std = piece_detection(square)            
            
            #If this is the first frame, all squares in the 0th, 1st, 6th, and 7th are known to be occupied
            if first_frame and ((y == 0) or (y == 1) or (y == 6) or (y == 7)):
                #Save edge count to use in setting the edge_count_threshold
                occupied_edge_count[(y % 4) * 8 + x] = edge_count[y][x]
                #If the edge_count is below the current edge_count_threshold, raise the edge_count to be above the threshold so it starts as a occupied square
                if (edge_count[y][x] <= edge_count_threshold):
                    edge_count[y][x] = edge_count_threshold + 1
            
            #If the edge count of the square exceeds edge_count_threshold the square is deemed occupied
            if (edge_count[y][x] > edge_count_threshold):
                #Add a rectangle of the appropriate color to the output image
                detection_image = cv2.rectangle(detection_image, lt, rb, occupied_color, line_thickness)
                #Mark the square as occupied in the output array
                detection_array[y][x] = 1
                #Measure the average color of the piece
                color_image[lt[1]:rb[1], lt[0]:rb[0]], color_array[y][x] = average_color(color_image[lt[1]:rb[1], lt[0]:rb[0]], x_average, y_average, std)
                #Add text to image to show the value of the color of that square
                cv2.putText(color_image, str(color_array[y][x]), (int(lt[0]), int(lt[1] + pixel*0)), cv2.FONT_HERSHEY_COMPLEX, text_size, (255, 255, 255), text_thickness)
            #If the edge cound of the square is or is under edge_count_threshold, then the square is empty
            else:
                #Add a rectangle of the appropriate color to the output image
                detection_image = cv2.rectangle(detection_image, lt, rb, empty_color, line_thickness)
                #Mark the square as occupied in the output array
                detection_array[y][x] = 0

    if first_frame:
        #Set new edge_count_threshold to be smaller than the lowest edge count of an occupied square
        edge_count_threshold = int(min(occupied_edge_count) * 0.4)
    
    if (np.count_nonzero(detection_array) > (turn_background[0] + turn_background[1]) or np.count_nonzero(detection_array) < (turn_background[0] + turn_background[1] - 1)):
        if (first_frame):
            input("Pieces not in starting postition. Press enter to restart game")
            process_game()
        print("Error detecting number of pieces on board")
        print("Counted " + str(np.count_nonzero(detection_array)) + " pieces")
        print("Expected " + str(turn_background[0] + turn_background[1]) + " or " + str((turn_background[0] + turn_background[1]) - 1) + " pieces")
        print("Edge count threshold is " + str(edge_count_threshold))
        print(detection_array)
        print(edge_count)
        return detection_image, -1*np.ones((8, 8), dtype=int), color_image, -1*np.ones((8, 8), dtype=int)
        #show_images('resize', ("Piece Detection", detection_image))
        #cv2.waitKey(wait)
        
        #Maybe change the threshold here?
    
    turn_dict = {0:"white", 1:"black"}
    #If one less piece is on the board in the current frame than the sum of pieces expected from both sides of the board
    if (np.count_nonzero(detection_array) + 1 == turn_background[0] + turn_background[1]):
        #Subtract one piece from whichever side didn't just move
        turn_background[turn_background[2]] -= 1
        #print("Subtracting a piece from " + turn_dict[turn_background[2]])
        #show_images("resize", ("Subtracting a piece from" + str(turn_background[2]), image))
        #cv2.waitKey(wait)

    #Flatten the color array to a 1D array to bbe able to sort it
    raveled_color_array = np.ravel(color_array)
    #Sort the nonzero values of the flattened color array
    color_array_sorted = np.sort(raveled_color_array[np.flatnonzero(color_array)])
    
    #Dictionary for what to display on each square of the output image depending on its color_array value
    #color_ref = {0:"Empty", 1:"Black", 2:"White"}
    color_ref = {0:("Empty", (255, 255, 255)), 1:("Black", (150, 150, 150)), 2:("White", (255, 255, 255))}
    
    #Iterate through each rank (horizontal row)
    for y in range(8):
        #Iterate through each file (vertical column)
        for x in range(8):
            #If the current square is occupied
            if (color_array[y][x] > 0):
                #If the average color of the current piece is in the bottom x number of average piece colors on the board, label it as white
                #x is gotten from the turn_background list, where turn_background[0] tells the number of white pieces expected on the board
                #turn_background is updated above based on when the detection array shows a piece disappeared
                if (color_array[y][x] in color_array_sorted[:turn_background[0]]):
                    #Label the current square as having a white piece
                    color_array[y][x] = 2
                #If the current piece color isn't determined to be white, label it black
                else:
                    #Label it black
                    color_array[y][x] = 1
                if add_text_to_image:
                    #Calculate the coordinates of the upper left corner of the rectangle to be measured
                    lt = (int(round(pixel + margin * pixel + 10 * pixel * x)), int(round(pixel + margin * pixel + 10 * pixel * y)))
                    #Label the current square with the determination of whether it is empty, or what color piece it has
                    #Add a rectangle of the appropriate color to the output image
                    #color_image = cv2.rectangle(color_image, lt, rb, color_ref[color_array[y][x]], int(pixel)*2)
                    cv2.putText(color_image, color_ref[color_array[y][x]][0], (int(lt[0]), int(lt[1] + pixel*7)), cv2.FONT_HERSHEY_COMPLEX, text_size, color_ref[color_array[y][x]][1], text_thickness)
    
    #print(edge_count)
    #print(detection_array)
    #print(color_array)
    return detection_image, detection_array, color_image, color_array

def piece_detection(image):
    '''
    Function to perform edge detection on an image, and return the array of edges and how many edge were measured, as well as the center of mass of the edges and the standard deviation of the edges
    Takes in the image to measure, and outputs the measured image and the number of edges
    '''
    #Blur the image to get rid of noise and bad edge measurements
    blurred = cv2.medianBlur(image,3)
    #Perform edge measurement
    edges = cv2.Canny(blurred,80,100)
    
    #If there are edges
    if np.count_nonzero(edges):
        #Find average y location of edges
        y_average = int(round(np.mean(np.nonzero(edges)[0])))
        #Find average x location of edges
        x_average = int(round(np.mean(np.nonzero(edges)[1])))
        #Find standard deviation of edges in y direction
        y_std = int(round(np.std(np.nonzero(edges)[0])))
        #Find standard deviation of edges in x direction
        x_std = int(round(np.std(np.nonzero(edges)[1])))
        #Average standard deviation values to get circle radius
        std = int(round(1.35 * (y_std + x_std) / 2))
    #If there are no edges
    else:
        #Set all statistics values to 0
        y_average, x_average, std = 0, 0, 0
        
    #Copy edge detection image 3 times so it can replace a section of a 3 channel image
    edges = np.stack((edges,)*3, axis=-1)
    #Find total amount of edges
    edge_count = np.sum(edges)
    
    if (std < image.shape[0] // 5):
        std = image.shape[0] // 5
    
    return edges, edge_count, x_average, y_average, std

def average_color(image, x, y, radius):
    '''
    Function to average the hue of a hsv image
    Takes in a hsv image and returns an average of the nonzero hues inside a given circle
    '''
    #show_images('resize', ("Input Image", image))
    #cv2.waitKey(0)
    #Create an empty mask the size of the input image
    mask = np.zeros((image.shape[0], image.shape[1]), dtype=np.uint8)
    #Place a white circle on the mask with the given dimensions
    cv2.circle(mask, (x, y), radius, (255, 255, 255), -1)
    #Create a new image called color_measure by only keeping the hue pixels that intersect with the white circle on the mask
    color_measure = np.stack((image[:,:,0]*mask,) * 3, axis=-1)
    #Measure average color from nonzero pixels
    average = round(np.average(color_measure[np.nonzero(mask)]))
    #Find the minimum hue value of the piece, gold pieces generally have minimum values in the 100s, silver pieces have minimum values close to 0
    minimum = min(np.ravel(color_measure[np.nonzero(mask)]))
    #Find standard deviation of the hue of the piece
    std = np.std(np.ravel(color_measure[np.nonzero(mask)]))
    #Add the lowest value of the array to the average in order to correct for glare
    if (average < 130) and (average > 90) and False:
        average = 0
    offset_average = average - std
    
    return color_measure, offset_average

def focus_on_border(image, detections):
    '''
    Function to black out apriltags and inside of chessboard
    Takes the image to black out, and the apriltag detections
    Returns the blacked out image
    '''
    #Retrieve inside corners
    inside_corners = grab_inside_corners(detections)
    #Retrieve outside corners
    outside_corners = grab_outside_corners(detections)
    
    #Make an empty array the size of the input image to run through a perspective shift
    inside_corner_array = np.zeros(shape=[image.shape[0], image.shape[1]], dtype=np.uint8)
    #Add in white pixels at each 4 inside corners
    for corner in inside_corners:
        inside_corner_array[corner[1]][corner[0]] = 255
    
    #Shift image with colored inside corners
    shifted_inside_corner = perspective_shift(inside_corner_array, outside_corners)
    
    #Get the locations of each nonzero pixels in the shifted image
    points = np.nonzero(shifted_inside_corner)
    
    #Make an empty array to store nonzero points in
    corners = [0] * len(points[0])
    
    #For each nonzero pixel
    for i in range(len(points[0])):
        #Add the coordinates to the corners array
        corners[i] = [points[0][i], points[1][i]]
    
    #Use K mean classification to find the centers of the 4 clusters at each corner
    kmeans = KMeans(n_clusters=4, random_state=0).fit(corners)
    
    #Map the cluster centers to two lists of the x and y coordinates, each list is a masked array
    x_list, y_list = map(np.ma.array, zip(*kmeans.cluster_centers_))
    
    #Get the indicies of each corners coordinate in x_list and y_list
    #The top left corner will have the lowest summed coordinates since the origin is in the top left corner
    top_left = np.argmin(x_list + y_list)
    #Mask the top left coordinate so it isn't considered for a different corner
    x_list[top_left] = np.ma.masked
    #The bottom right corner will have the highest summed coordinates since it's furthest from the origin
    bottom_right = np.nanargmax(x_list + y_list)
    #The bottom left corner will be the one with the lowest remaining x coordinate (since top left is masked and not considered)
    bottom_left = np.nanargmin(x_list)
    #The top right corner is the last remaining corner
    top_right = 6 - top_left - bottom_right - bottom_left
    
    #Remove the mask from the x coordinate list to make the top left value usable
    x_list.mask = np.ma.nomask
            
    #Convert the four indicies into integer coordinates of each corner
    top_left = (int(x_list[top_left]), int(y_list[top_left]))
    bottom_right = (int(x_list[bottom_right]), int(y_list[bottom_right]))
    bottom_left = (int(x_list[bottom_left]), int(y_list[bottom_left]))
    top_right = (int(x_list[top_right]), int(y_list[top_right]))
    
    #Black out inside chessboard area
    image[top_left[1]:bottom_left[1], top_left[0]:top_right[0]] = 0
    #Black out corners where apriltags are
    #Top left
    image[0:top_left[1]+5, 0:top_left[1]+5] = 0
    #Top right
    image[0:top_right[1]+5, top_right[0]-5:image.shape[1]] = 0
    #Bottom left
    image[bottom_left[1]-5:image.shape[0], 0:bottom_left[0]+5] = 0
    #Bottom right
    image[bottom_right[1]-5:image.shape[0], bottom_right[0]-5:image.shape[1]] = 0
    
    return image

def knot_detection(image, border_template, detections):
    '''
    Function to observe linear celtic knot pattern around border of chessboard and check whether any part of the pattern isn't visible
    Takes in the image to check and location of apriltags in the image
    Returns true if the image isn't blocked, false if it is blocked
    '''
    #Whether to display the output and how long to wait for
    global display, wait
    
    #Convert copy of the reference image to grayscale
    template = cv2.cvtColor(copy.copy(border_template), cv2.COLOR_BGR2GRAY)
    
    #Retrive outside corners of the apriltags
    outside_corners = grab_outside_corners(detections)
    
    #If all the outside corners were found
    if not any(map(lambda ele: ele is None, outside_corners)):
        #Crop and perspective shift image using the outside corners of the apriltags
        image = perspective_shift(image, outside_corners)

        #Blur the image to get rid of noise and bad edge measurements
        blurred = cv2.medianBlur(image,3)
        #Perform edge measurement
        edges = cv2.Canny(blurred,80,100)

        #Black out the apriltags and the inside chessboard area, leaving only the knot pattern
        edges = focus_on_border(edges, detections)
        
        #Get input image size
        w = image.shape[0]
        h = image.shape[1]
        
        #The reference images had a border around the apriltag, the apriltag detection from the camera doesn't leave any border, the offset is how many pixels to cut off from the edges
        offset = 24 #Math says this value should be 34, but there might be some camera distortion that makes 24 work better
        #Crop the border around the edges of the reference image and resize it to the same size of the input image
        template = cv2.resize(template[offset:3300-offset, offset:3300-offset], (w, h))
        #Boost any nonzero template value to 255 since resizing lowers some edge values
        template = cv2.inRange(template, 1, 255)
        
        #Keep only the edges that fall inside the template
        edges = template - cv2.inRange(template - edges, 127, 255)        
        
        #Size of the square to use in blurring, large = more blurred
        blur_size = 30
        ksize = (blur_size, blur_size)
        #Blur edges to expand how much space is taken up by the edge lines
        edges_blurred = cv2.blur(edges, ksize)
        #Boost any nonzero edge values to 255
        edges_blurred = cv2.inRange(edges_blurred, 1, 255)
        
        #Subtract blurred edges from template, any remaining nonzero pixels are pixels that were blocked from camera view
        blocked_edges = cv2.inRange(template - edges_blurred, 127, 255)
        
        #Stack the blocked edges, edges, and blurred edges to all display in the same image
        output = np.stack((template // 4, edges_blurred // 4, blocked_edges // 2), axis=-1)
        
        edge_knots = cv2.addWeighted(image, 1, output, 1, 0)
        '''
        if display[3]:
            #Show calculated results over the image
            show_images("resize", ("Edges", edge_knots))
            #show_images("resize", ("Edges", edges_blurred))
            #Wait for keypress
            cv2.imwrite("TestingImages/OutputImages/KnotDetection"+ time.ctime(time.time()) + ".jpg", cv2.addWeighted(image, 1, output, 1, 0))
            cv2.waitKey(1)
        '''
        #If there were no blocked edges return true
        if not np.count_nonzero(blocked_edges):
            return True, edge_knots
        #Else return false
        else:
            return False, edge_knots
    #If there was an apriltag corner missing, return false
    else:
        return False, edge_knots
    
#-----------------------------------------IMAGE DETECTION MAIN
def process_frame(frame, border_template, turn_background, first_frame, previous_detections=False):
    global wait
    #Assume frame is good until find evidence otherwise
    valid_frame = True
    
    #Which apriltags should be looked for
    #Tags I've used in the project: 'tag16h5', 'tag36h11', 'tagStandard41h12'
    tag_family = 'tag16h5'
    
    if first_frame:
        #Run apriltag detection on whole image
        detections, valid_frame = detect_apriltags(tag_family, frame)
    else:
        #Run apriltag detection, focusing on the area where the tags were last seen
        detections, valid_frame = detect_apriltags(tag_family, frame, previous_detections)
    
    #Make blank images in case frame isn't valid, then blank images are shown instead of processed frames
    edge_knots = np.zeros((frame.shape[0], frame.shape[0], 3), dtype=np.uint8)
    color_detection = np.zeros((frame.shape[0], frame.shape[0], 3), dtype=np.uint8)
    piece_detection = np.zeros((frame.shape[0], frame.shape[0], 3), dtype=np.uint8)
    
    #Find center position of frame (not actually center, offset to fit "Missing Apriltag Detection" in center)
    frame_center = (int(frame.shape[0] // 6), int(frame.shape[0] // 2))
    
    #Add text to display when a tag is missing from the detected group
    cv2.putText(edge_knots, "Missing Apriltag Detection", frame_center, cv2.FONT_HERSHEY_COMPLEX, 1.1, (255, 255, 255), 3)
    cv2.putText(color_detection, "Missing Apriltag Detection", frame_center, cv2.FONT_HERSHEY_COMPLEX, 1.1, (255, 255, 255), 3)
    cv2.putText(piece_detection, "Missing Apriltag Detection", frame_center, cv2.FONT_HERSHEY_COMPLEX, 1.1, (255, 255, 255), 3)
    
    #Place rectangles on each apriltag
    apriltag_rect = copy.copy(frame)
    for i in range(len(detections)):
        apriltag_rect = cv2.polylines(apriltag_rect, [np.round(detections[i]['lb-rb-rt-lt']).astype(int)], True, (255, 0, 0), 2)
        cv2.putText(apriltag_rect, str(detections[i]['id']), (np.round(detections[i]['center']).astype(int)[0] - 8,np.round(detections[i]['center']).astype(int)[1] + 8) , cv2.FONT_HERSHEY_COMPLEX, 0.75, (255, 255, 255), 4)
        
    apriltag_rect = apriltag_rect[0:apriltag_rect.shape[0], 128:896]
    
    #If 4 apriltags are seen (one in each 4 corners of chessboard), crop image and run detection functions
    if detections and valid_frame:
        edge_clear, edge_knots = knot_detection(frame, border_template, detections)
        
        if not edge_clear:
            #print("Border not clear")
            valid_frame = False
            color_array = np.zeros((8, 8), dtype=int)
            
            #Overwrite piece and color detection images to put new message
            color_detection = np.zeros((frame.shape[0], frame.shape[0], 3), dtype=np.uint8)
            piece_detection = np.zeros((frame.shape[0], frame.shape[0], 3), dtype=np.uint8)
            
            frame_center = (int(frame.shape[0] // 7), int(frame.shape[0] // 2))
            
            #Put new message in piece and color detection images for when border is not clear
            cv2.putText(color_detection, "Border Design is Obstructed", frame_center, cv2.FONT_HERSHEY_COMPLEX, 1.1, (255, 255, 255), 3)
            cv2.putText(piece_detection, "Border Design is Obstructed", frame_center, cv2.FONT_HERSHEY_COMPLEX, 1.1, (255, 255, 255), 3)
        else:
            #Shift perspective to make to make the inside corners of the apriltags the corners of the image
            shifted = perspective_shift(copy.copy(frame), grab_inside_corners(detections))
            
            #Go through each square of the chessboard to tell if square is populated with piece and measure piece color
            piece_detection, detection_array, color_detection, color_array = get_detection_color_array(shifted, turn_background, first_frame)
            
            if np.amin(detection_array < 0):
                valid_frame = False
                color_array = np.zeros((8, 8), dtype=int)
    #If not all four apriltags are visisble
    else:
        valid_frame = False
        color_array = np.zeros((8, 8), dtype=int)
    
    return valid_frame, detections, color_array, apriltag_rect, edge_knots, piece_detection, color_detection

#-----------------------------------------CHESS MOVE FUNCTIONS
def create_board_array():
    '''
    Function to create an array of chess pieces in the starting configuration
    Each element has an bmp file icon for the piece, the location of that icon on the chessboard, and the character representation of the piece
    Takes no input
    Returns the board array
    '''
    #List of filenames to use, the order corresponds to the piece_dict dictionary
    if pi:
        filenames = ['Icons/rook_black.bmp', 
                 'Icons/knight_black.bmp', 
                 'Icons/bishop_black.bmp', 
                 'Icons/queen_black.bmp', 
                 'Icons/king_black.bmp', 
                 'Icons/pawn_black.bmp', 
                 'Icons/pawn_white.bmp', 
                 'Icons/rook_white.bmp', 
                 'Icons/knight_white.bmp', 
                 'Icons/bishop_white.bmp', 
                 'Icons/queen_white.bmp', 
                 'Icons/king_white.bmp']
    else:
        filenames = ['Icons/rook_black.svg', 
                 'Icons/knight_black.svg', 
                 'Icons/bishop_black.svg', 
                 'Icons/queen_black.svg', 
                 'Icons/king_black.svg', 
                 'Icons/pawn_black.svg', 
                 'Icons/pawn_white.svg', 
                 'Icons/rook_white.svg', 
                 'Icons/knight_white.svg', 
                 'Icons/bishop_white.svg', 
                 'Icons/queen_white.svg', 
                 'Icons/king_white.svg']
    #Dictionary for converting the character representation of each piece to the filename of that piece icon
    piece_dict = {'r':0, 'n':1, 'b':2, 'q':3, 'k':4, 'p':5, 'P':6, 'R':7, 'N':8, 'B':9, 'Q':10, 'K':11}
    #Dictionary for correct sizing of each icon
    #Found by printing out the rectangle of each icon after importing then dividing by two
    #size_dict = {'r':(17, 21), 'n':(17, 22), 'b':(17, 22), 'q':(21, 22), 'k':(20, 22), 'p':(17, 21), 'P':(17, 21), 'R':(17, 21), 'N':(17, 22), 'B':(17, 22), 'Q':(21, 22), 'K':(20, 22)}
    size_dict = {'r':(34, 42), 'n':(34, 44), 'b':(34, 44), 'q':(42, 44), 'k':(40, 44), 'p':(34, 42), 'P':(34, 42), 'R':(34, 42), 'N':(34, 44), 'B':(34, 44), 'Q':(42, 44), 'K':(40, 44)}
    
    #Get the starting position of a chessboard in fen format, then at each '/', yielding a list of 8 elements for each rank of the board
    position = chess.STARTING_BOARD_FEN.split('/')

    #Initialize an 8 x 8 x 3 array for each square of the chessboard, and the 3 pieces of info for each piece
    board_array = np.empty(shape=(8, 8, 3),dtype='object')
    
    #For each element of the position list
    for y in range(8):
        #Empty squares are represented by a number for the amount of continuous emmpty squares in that section of the rank, so ranks 3-6 are just the string '8' and can be skipped
        if (position[y].isdigit() != True):
            #For each character in the filled ranks
            for x in range(8):
                #Load the icon into the first element by referencing the piece_dict to convert character to filename
                board_array[x][y][0] = pygame.image.load(filenames[piece_dict[position[y][x]]])
                #Scale icon to fit with pi screen
                if pi:
                    board_array[x][y][0] = pygame.transform.scale(board_array[x][y][0], size_dict[position[y][x]])
                #Place the rectangle location in the second element
                board_array[x][y][1] = board_array[x][y][0].get_rect()
                #Put the string representation of the piece in the third element
                board_array[x][y][2] = position[y][x]
    
    return board_array

def update_board_array_uci(board, board_array, uci):
    '''
    Updates the board_array from a uci notation string
    First the uci move is tested to see if it is a unique case that requires extra actions like:
        white or black castling on queenside or kingside
        a pawn promotion
        en passant capture
    If the move isn't any of the above, the code from the else statement is run
    '''
    #Dictionary for converting the file letter notation to the board_array x coordinate
    files = {'a':0, 'b':1, 'c':2, 'd':3, 'e':4, 'f':5, 'g':6, 'h':7}
    #Compute piece origin coordinate
    origin = (files[uci[0]], 8 - int(uci[1]))
    #Compute piece destination coordinate
    destination = (files[uci[2]], 8 - int(uci[3]))
        
    #White king-side castling
    if (uci == "e1g1"):
        #Move king
        board_array[destination[0]][destination[1]] = board_array[origin[0]][origin[1]]
        board_array[origin[0]][origin[1]] = (None, None, None)
        #Move rook
        board_array[5][7] = board_array[7][7]
        board_array[7][7] = (None, None, None)
    #White queen-side castling
    elif (uci == "e1c1"):
        #Move king
        board_array[destination[0]][destination[1]] = board_array[origin[0]][origin[1]]
        board_array[origin[0]][origin[1]] = (None, None, None)
        #Move rook
        board_array[3][7] = board_array[0][7]
        board_array[0][7] = (None, None, None)
    #Black king-side castling
    elif (uci == "e8g8"):
        #Move king
        board_array[destination[0]][destination[1]] = board_array[origin[0]][origin[1]]
        board_array[origin[0]][origin[1]] = (None, None, None)
        #Move rook
        board_array[5][0] = board_array[7][0]
        board_array[7][0] = (None, None, None)
    #Black queen-side castling
    elif (uci == "e8c8"):
        #Move king
        board_array[destination[0]][destination[1]] = board_array[origin[0]][origin[1]]
        board_array[origin[0]][origin[1]] = (None, None, None)
        #Move rook
        board_array[3][0] = board_array[0][0]
        board_array[0][0] = (None, None, None)
    #Promotion
    elif (len(uci) == 5):
        #List of filenames to use, the order corresponds to the piece_dict dictionary
        if pi:
            filenames = ['Icons/rook_black.bmp', 
                    'Icons/knight_black.bmp', 
                    'Icons/bishop_black.bmp', 
                    'Icons/queen_black.bmp', 
                    'Icons/king_black.bmp', 
                    'Icons/pawn_black.bmp', 
                    'Icons/pawn_white.bmp', 
                    'Icons/rook_white.bmp', 
                    'Icons/knight_white.bmp', 
                    'Icons/bishop_white.bmp', 
                    'Icons/queen_white.bmp', 
                    'Icons/king_white.bmp']
        else:
            filenames = ['Icons/rook_black.svg', 
                    'Icons/knight_black.svg', 
                    'Icons/bishop_black.svg', 
                    'Icons/queen_black.svg', 
                    'Icons/king_black.svg', 
                    'Icons/pawn_black.svg', 
                    'Icons/pawn_white.svg', 
                    'Icons/rook_white.svg', 
                    'Icons/knight_white.svg', 
                    'Icons/bishop_white.svg', 
                    'Icons/queen_white.svg', 
                    'Icons/king_white.svg']
        #Dictionary for converting the character representation of each piece to the filename of that piece icon
        piece_dict = {'r':0, 'n':1, 'b':2, 'q':3, 'k':4, 'p':5, 'P':6, 'R':7, 'N':8, 'B':9, 'Q':10, 'K':11}
        #Dictionary for correct sizing of each icon
        #Found by printing out the rectangle of each icon after importing then dividing by two
        size_dict = {'r':(17, 21), 'n':(17, 22), 'b':(17, 22), 'q':(21, 22), 'k':(20, 22), 'p':(17, 21), 'P':(17, 21), 'R':(17, 21), 'N':(17, 22), 'B':(17, 22), 'Q':(21, 22), 'K':(20, 22)}
        
        #White pieces are capitalized
        if (destination[1] == 0):
            piece = uci[4].upper
        #Black pieces are lowercase, just like the notation already is
        elif (destination[1] == 7):
            piece = uci[4]
        
        #Load in image for newly promoted piece
        board_array[destination[0]][destination[1]][0] = pygame.image.load(filenames[piece_dict[piece]])
        #Get size and location variable for the new image
        board_array[destination[0]][destination[1]][1] = board_array[destination[0]][destination[1]][0].get_rect()
        #Update the board_array character of the piece
        board_array[destination[0]][destination[1]][2] = piece
        #Replace move origin square with empty space
        board_array[origin[0]][origin[1]] = (None, None, None)
    #If the move is en passant
    #NOTE: the move has to be sent to this function before being pushed to the board, or is_en_passant won't recognize the move as an en passant capture
    elif (board.is_en_passant(chess.Move.from_uci(uci))):
        #Remove piece behind destination square in opposite direction of pawn travel
        board_array[destination[0]][destination[1] + (origin[1] - destination[1])] = (None, None, None)
        #Replace destination square with piece from move origin square
        board_array[destination[0]][destination[1]] = board_array[origin[0]][origin[1]]
        #Replace move origin square with empty space
        board_array[origin[0]][origin[1]] = (None, None, None)
    #Any other move
    else:            
        #Replace destination square with piece from move origin square
        board_array[destination[0]][destination[1]] = board_array[origin[0]][origin[1]]
        #Replace move origin square with empty space
        board_array[origin[0]][origin[1]] = (None, None, None)
    return board_array

def color_array_to_uci(old_array, new_array, board):
    '''
    Function to translate the difference in the previous and current color arrays to a chess move in uci format
    Takes in the previous color array, the current color array, and the current board variable to tell when a pawn reaches the back rank
    Works by taking the difference between the new array and old array, and assigning the move based on the nonzero elements of the resulting array
    Returns the move as a string in uci notation
    '''
    #String with the names of each file in order
    files = 'abcdefgh'
    #Initialize empty array to hold the names of each square
    square_names = np.empty((8, 8), dtype=object)
    #Iterate through each vertical file
    for y in range(8):
        #Iterate through each horizontal rank
        for x in range(8):
            #Assign square names with the file and the rank as a string
            square_names[y][x] = files[x] + str(8-y)
    #Take the difference between the new and old color arrays to see which squares changed
    difference = new_array - old_array
    #Empty list to easily store the origin and destination squares needed for uci notation
    move = ['', '']
    
    #If 3 squares were changed, that signals an en passant capture
    if (np.count_nonzero(difference) == 3):
        #Transform difference array to a 1D array by flattening it and take the absolute value element wise
        flat_abs_difference = np.abs(difference.flatten())
        #Count the occurence of each value in the flattened absolute value difference array, and return whichever number shows up least
        #0 will show up most in the first element, which is ignored, the important parts are the second and third elements, which show how many times ones and twos show up in the difference array, respectively
        min_val = np.argmin(np.bincount(flat_abs_difference))
        #Make an array with zeros where the squares weren't changed, and the min_val wherever squares were changed
        min_val = min_val * np.ones((8,8), dtype=int) * (difference != 0).tolist()
        #Subtract the min_val array from the difference array to remove the value that occurs the least in the difference array, this was the pawn that was captured in en passant
        #Since the captured pawn isn't given in uci notation, we just want the origin and destination square for the capturing pawn, which are the other two square changes
        difference = np.abs(difference) - min_val
        #After the difference array is replaced by the modified version without the least occuring value, the if statement for 2 changed squares will evaluate to be true and the uci notation can be found as normal
    #If 2 squares were changed, that signals either moving a piece to an empty square, or a conventional capture
    if (np.count_nonzero(difference) == 2):   
        #Create an empty modifier string variable in case a pawn is promoted and the promotion piece needs to be added to the end of the uci string
        modifier = ''
        #
        move[ min(new_array[np.nonzero(difference)][0], 1)] = square_names[np.nonzero(difference)][0]
        move[ min(new_array[np.nonzero(difference)][1], 1)] = square_names[np.nonzero(difference)][1]
        #If the piece came from the 7th rank and went to the 8th rank, or came from the 2nd rank and went to the 1st rank, check to see if it is a pawn that should be promoted
        if (len(move[0]) == 2) and (len(move[1]) == 2):
            if (int(move[0][1]) == 7 and int(move[1][1]) == 8) or (int(move[0][1]) == 2 and int(move[1][1]) == 1):
                #Get and split the current board fen notation into 8 strings for each rank
                position = board.fen().split()[0].split('/')
                #Set the x (file) notation to 0
                x = 0
                #If the piece being considered is at the back rank, it has to be a white pawn to be promoted
                if (int(move[1][1]) == 8):
                    pawn = 'P'
                #Else if the considered piece is at the front rank, it has to be a black pawn to be promoted
                else:
                    pawn = 'p'
                #For each character in the rank string
                for character in position[8 - int(move[0][1])]:
                    #If the current character is a number, add that many to the x variable to skip the empty squares
                    if (character.isdigit()):
                        x += int(character)
                    #If the character is not a number
                    else:
                        #Check if the square it came from previously held a pawn
                        if (files[x] == move[0][0] and character == pawn):
                            #Default the promotion type to a queen
                            modifier = 'q'
                        #Add one to the x variable to move onto the next square
                        x += 1
            #Assemble the move in uci notation by joining the origin square with the destination square, and the type of piece it is promoted to if necessary
            move = move[0] + move[1] + modifier
        else:
            move = 0
    #If 4 squares were changed, that signals that one of the sides castled
    elif (np.count_nonzero(difference) == 4):
        #If the castling happened in the front rank and the squares involved are on the right side of the board
        if (np.nonzero(difference)[0][0] == 7 and max(np.nonzero(difference)[1]) > 4):
            move = 'e1g1'
        #If the castling happened in the front rank and the squares involved are on the left side of the board
        elif (np.nonzero(difference)[0][0] == 7 and max(np.nonzero(difference)[1]) == 4):
            move = 'e1c1'
        #If the castling happened in the back rank and the squares involved are on the right side of the board
        elif (np.nonzero(difference)[0][0] == 0 and max(np.nonzero(difference)[1]) > 4):
            move = 'e8g8'
        #If the castling happened in the back rank and the squares involved are on the left side of the board
        elif (np.nonzero(difference)[0][0] == 0 and max(np.nonzero(difference)[1]) == 4):
            move = 'e8c8'
    return move
        
#-----------------------------------------CHESS GUI FUNCTIONS
def create_gui(square_size):
    '''
    Function to create the gui elements that are needed to display the chessboard
    No inputs are taken
    The gui window and the square size used are returned
    '''
    #Initialize an instance of pygame
    pygame.init()
    
    #Set the size of the window to 8 squares by 8 squares
    window = pygame.display.set_mode((square_size * 12, square_size * 8))
    #Set the window name to Chessboard
    pygame.display.set_caption('Chessboard')
    #Load in an icon of a knight
    icon=pygame.image.load('Icons/icon.bmp')
    #Set the window icon
    pygame.display.set_icon(icon)
    #Draw a grid on the window
    window = draw_grid(window, square_size)
    #Show the window
    pygame.display.flip()
    return window, square_size

def draw_grid(window, square_size):
    '''
    Function to draw a chessboard grid in a pygame window
    Takes in the pygame window variable and the size of each square as inputs
    Returns the window with a grid on it
    '''
    #For each horizontal rank of the board
    for rank in range(8):
        #For each vertical file of the board
        for File in range(8):
            #Alternate the colors by using remainder functions to only color every other square tan, and switch whether even or odd squares are tan each rank
            if ((File + rank % 2) % 2 == 0):
                #Set color for this square to be tan
                color = (235, 236, 208) #tan
            else:
                #Set color for this square to be green
                color = (119, 149, 86) #green
            #Color the current square the selected color
            pygame.draw.rect(window, color, pygame.Rect(File * square_size, rank * square_size, square_size, square_size))
            
    pygame.draw.rect(window, (60, 60, 60), pygame.Rect(8 * square_size, 0 * square_size, square_size * 4, square_size * 8))
    return window

def print_board(window, board_array, square_size, move=False):
    '''
    Function to print the board_array on the pygame window
    Takes in the window to print on, the board array with piece icons, locations, and characters, and the size of the square to get the spacing right
    Returns nothing
    '''
    #Draw a grid on the window to overlay the current window and cover everything up
    draw_grid(window, square_size)
    #Iterate through each rank of the chessboard
    for y in range(8):
        #Iterate through each file of the chessboard
        for x in range(8):
            #If the current square of the board array isn't empty
            if (board_array[x][y][0] != None):
                #Set x coordinate to the middle of the current square
                board_array[x][y][1].centerx = (square_size // 2) + square_size * x
                #Set y coordinate to the middle of the corrent square
                board_array[x][y][1].centery = (square_size // 2) + square_size * y
                #Send updates to the window
                window.blit(board_array[x][y][0], board_array[x][y][1])
    
    if move:              
        #Set the font to display
        #1st parameter is the font file
        #2nd parameter is size of the font
        font = pygame.font.Font('freesansbold.ttf', 32)
        
        #Set the text to display in white
        text = font.render(move, True, (255, 255, 255), (60, 60, 60))
        
        #Get the rectangle in which text is displayed
        textRect = text.get_rect()
        
        #Set the center of the rectangle text is displayed to the top of the right bit
        textRect.center = (square_size * 10, 80 // 2)
        
        #Send the text to be displayed
        window.blit(text, textRect)
    
    #Display the window
    pygame.display.flip()

#-----------------------------------------CHESS FUNCTIONS
def open_engine(difficulty):
    if pi:
        #List of engine to use and their rankings
        engines = [[968, "feeks-master/main.py"], [1198, "belofte64-2.1.1"], [3717, "stockfish_13_linux_x64"]]
        #Sort engines by rating
        engines.sort(key = lambda engines: engines[0]) 
        #Sort to get closest ranking to the desired difficulty
        engine_to_use = min([(engines[i][0], engines[i][1], i) for i in range(len(engines))], key = lambda x: abs(x[0]-difficulty))
        print("Using engine " + engine_to_use[1] + " with a rating of " + str(engine_to_use[0]))
        #Open engine
        engine = chess.engine.SimpleEngine.popen_uci("/home/pi/Chessboard/Engines/" + engine_to_use[1])
    else:
        #List of engine to use and their rankings
        engines = [[968, "feeks-master/main.py"], [1198, "belofte64-2.1.1"], [3717, "stockfish_13_linux_x64"]]
        #Sort engines by rating
        engines.sort(key = lambda engines: engines[0]) 
        #Sort to get closest ranking to the desired difficulty
        engine_to_use = min([(engines[i][0], engines[i][1], i) for i in range(len(engines))], key = lambda x: abs(x[0]-difficulty))
        print("Using engine " + engine_to_use[1] + " with a rating of " + str(engine_to_use[0]))
        #Open engine
        engine = chess.engine.SimpleEngine.popen_uci("/home/blemay360/Documents/chessboard-main/Engines/" + engine_to_use[1])
    return engine

#-----------------------------------------PI FUNCTIONS
def setup_camera():
    #Initialize the camera and grab a reference to the raw camera capture
    camera = PiCamera()
    #Set resolution
    camera.resolution = (1024, 768)
    return camera

def pi_take_image(camera):
    #Get raw capture from camera
    #For some reason this works better calling this line everytime
    rawCapture = PiRGBArray(camera)
    #Allow the camera to warmup
    time.sleep(0.1)
    #Grab an image from the camera
    camera.capture(rawCapture, format="bgr")
    input_image = rawCapture.array
    return input_image
    
#-----------------------------------------MAIN FUNCTIONS
def setup():
    global engine, window, square_size, border_template, camera
    #The pi screen is smaller and needs different sizing
    if pi:
        #Set square size to 40 pixels
        #square_size = 40
        square_size = 80
        #Set up camera
        camera = setup_camera()
    else:
        #Set square size to 70 pixels
        square_size = 70
    #Create a gui to display the state of the chessboard, saving the window it creates  for later functions
    window, square_size = create_gui(square_size)
    
    #Set desired difficulty of the computer
    difficulty = 900

    #Find and open the desired engine for the difficulty
    engine = open_engine(difficulty)
    
    #Open reference image with border pattern
    border_template = cv2.imread('ComparisonImages/11in_TestChessboard_16h5_Comparison_5pt.png')
        
def process_game():
    global engine, window, square_size, border_template, wait, camera
    #Remove all previous debugging images
    if pi:
        for files in os.listdir(image_directory):
            os.remove(os.path.join(image_directory, files))
    
    #Create a board array to keep track of the images displayed on the gui chessboard
    board_array = create_board_array()

    #Create a board variable to keep track of the game
    board = chess.Board()

    #Print the chessboard to the window
    print_board(window, board_array, square_size)
    
    #Initialize a variable to keep track of how many white and black pieces are on the board, and which side just moved
    turn_background = [16, 16, 0]
    #[# of white pieces on board, # of black pieces on board, 0=black just moved | 1=white just moved]
    
    if pi:
        #Take an image from the camera
        input_image = pi_take_image(camera)
        #Rotate image 180 degrees to correct for camera flip
        #input_image = imutils.rotate(input_image, 180)
        cv2.imwrite("TestingImages/Debugging/"+ time.ctime(time.time()) + ".jpg", input_image)
    elif process_video:
        print("Processing video")
        # Create a VideoCapture object and read from input file
        cap = cv2.VideoCapture('ScholarsMate.h264')
        
        # Check if camera opened successfully
        if (cap.isOpened() == False):
            print("Error opening video stream or file")
            
        ret, frame = cap.read()
        
        if ret == True:
            input_image = frame
            input_image = imutils.rotate(input_image, 270)
    else:
        files = os.listdir(image_directory)
        files.sort()
        #Read the first frame in
        input_image = cv2.imread(image_directory + files[0])
        #input_image = cv2.imread(image_directory + 'medium_block.jpg')
        
    if display[0]:
        #Show the input image
        show_images('resize', ("Input Image", input_image))
        cv2.imwrite("TestingImages/PresentationImages/InputImage0.jpg", input_image)
        cv2.waitKey(1)
        
    #Save the color array as old to compare with the second frame later
    valid_frame, previous_detections, old_color_array, apriltag_rect, edge_knots, piece_detection, color_detection = process_frame(input_image, border_template, turn_background, True)
    
    if display[1]:
        #Show the grayscale color detection image and piece detection image
        show_images('resize', ('Apriltag Location', apriltag_rect))
        cv2.imwrite("TestingImages/PresentationImages/ApriltagRect0.jpg", apriltag_rect)
    if display[2]:
        #Show the knot detection image
        show_images('resize', ('Knot Detection', edge_knots))
        cv2.imwrite("TestingImages/PresentationImages/EdgeKnots0.jpg", edge_knots)
    if display[3]:
        #Show the piece detection image
        show_images('resize', ('Piece Detection', piece_detection))
        cv2.imwrite("TestingImages/PresentationImages/PieceDetection0.jpg", piece_detection)
    if display[4]:
        #Show the grayscale color detection image and piece detection image
        show_images('resize', ('Color Values', color_detection))
        cv2.imwrite("TestingImages/PresentationImages/ColorDetection0.jpg", color_detection)
        
    if wait == 0:
        #Wait for a keypress while updating the chessboard gui
        while (cv2.waitKey(100) == -1):
            print_board(window, board_array, square_size)
    else:
        #Don't wait for a keypress
        cv2.waitKey(wait)

    if not valid_frame:
        print("Couldn't validate first frame")
        input("Pieces not in starting postition. Press enter to restart game")
        process_game()

    #--------------------------------------------LOOP
    run = True
    move_counter = 2
    file_counter = 1
        
    result = False    
    
    #If running from files, calculate the number of files to run
    if not pi and not process_video:
        #max_file_count = max([int(i.split('.')[0]) for i in os.listdir(image_directory) if i.split('.')[0].isdigit()]) + 1;
        max_file_count = len(os.listdir(image_directory))
    else:
        max_file_count = 0
    
    while run:
        #If it's running from images and finishes the last image
        if (file_counter == max_file_count) and not pi:
            #Stop running the program
            print("Reached end of files")
            run = False
            break
        
        #Start a timer to measure processing time for the current frame
        start = time.time()
        #Update the variable of which side just went
        turn_background[2] = 1 - (move_counter % 2)
        
        #Read the current frame
        if pi:
            input_image = pi_take_image(camera)
            #input_image = imutils.rotate(input_image, 180)
            cv2.imwrite("TestingImages/Debugging/" + time.ctime(time.time()) + ".jpg", input_image)
        elif process_video:
            ret, frame = cap.read()
            
            if ret == True:
                input_image = frame
                input_image = imutils.rotate(input_image, 270)
            else:
                #Stop running the program
                print("Reached end of video")
                run = False
                break
        else:
            input_image = cv2.imread(image_directory + files[file_counter])
        
        #print(file_counter, max_file_count)
        
        #if (file_counter + 2 == max_file_count):
            #print("Transitioning wait to 0")
            #wait = 0
        
        #Process the current frame
        valid_frame, previous_detections, new_color_array, apriltag_rect, edge_knots, piece_detection, color_detection = process_frame(input_image, border_template, turn_background, False, previous_detections)
        
        if display[0]:
            #Show the grayscale color detection image and piece detection image
            show_images('resize', ('Input Image', input_image))
            cv2.imwrite("TestingImages/PresentationImages/InputImage" + str(file_counter) + ".jpg", input_image)
        if display[1]:
            #Show the grayscale color detection image and piece detection image
            show_images('resize', ('Apriltag Location', apriltag_rect))
            cv2.imwrite("TestingImages/PresentationImages/ApriltagRect" + str(file_counter) + ".jpg", apriltag_rect)
        if display[2]:
            #Show the knot detection image
            show_images('resize', ('Knot Detection', edge_knots))
            cv2.imwrite("TestingImages/PresentationImages/EdgeKnots" + str(file_counter) + ".jpg", edge_knots)
        if display[3]:
            #Show the piece detection image
            show_images('resize', ('Piece Detection', piece_detection))
            cv2.imwrite("TestingImages/PresentationImages/PieceDetection" + str(file_counter) + ".jpg", piece_detection)
        if display[4]:
            #Show the grayscale color detection image and piece detection image
            show_images('resize', ('Color Values', color_detection))
            cv2.imwrite("TestingImages/PresentationImages/ColorDetection" + str(file_counter) + ".jpg", color_detection)
        cv2.waitKey(wait)
        
        #If the frame isn't valid, restart from the beginning of the loop
        if not valid_frame:
            if not pi:
                file_counter += 1
            continue
        
        #Compare the color detection array of the current image with the last image to deterime the move that was made
        if not np.array_equal(old_color_array, new_color_array):
            move = color_array_to_uci(old_color_array, new_color_array, board)
            if move == 0:
                if not pi:
                    file_counter += 1
                continue
        else:
            if not pi:
                file_counter += 1
            continue
        
        if (move == ['','']):
            if not pi:
                file_counter += 1
            continue
        else:
            #Compute the move variable using the chess library
            move = chess.Move.from_uci(move)
        
        #If it's time to check the computer's move was properly carried out
        if vs_comp and (turn_background[2] == 0):
            #If the move just made was the same one as the engine calculated
            if (move == result.move):
                result = False
                print("Good job")
            #If the move wasn't the same as the engine's move
            else:
                print("Wrong move")
                if not pi:
                    file_counter += 1
                continue
        
        #If the move wasn't legal
        if not (move in board.legal_moves):
            #Print the move wasn't legal
            print(str(move) + " not legal")
            if not pi:
                file_counter += 1
            continue
        
        #Update the board array to reflect the move that was just made
        board_array = update_board_array_uci(board, board_array, chess.Move.uci(move))
        #Push the move to the board
        board.push(move)
        #Update the chessboard gui
        if result:
            print_board(window, board_array, square_size, board.san(result.move))
        else:
            print_board(window, board_array, square_size)
        #Replace the old color array with the current color array to prepare for the next frame
        old_color_array = new_color_array
        
        #Print the move that was made and the time it took to process the frame
        print(move, time.time() - start)
        
        #If there is a check on the board
        if board.is_check():
            #Print check
            print("Check", end='')
            #If there is a checkmate on the board
            if board.is_checkmate():
                #Add mate to the end of the printed check
                print("mate")
                #Stop running the loop
                run = False
                #Break out of the loop
                break
            else:
                print()
        
        if vs_comp and (turn_background[2] == 1):
            result = engine.play(board, chess.engine.Limit(time=0.5))
            #print("Computer move: " + str(board.san(result.move)))
            print_board(window, board_array, square_size, board.san(result.move))
        
        if wait == 0:
            #Wait for a keypress while updating the chessboard gui
            while (cv2.waitKey(100) == -1):
                #Update the chessboard gui
                if result:
                    print_board(window, board_array, square_size, board.san(result.move))
                else:
                    print_board(window, board_array, square_size)
        else:
            #Don't wait for a keypress
            cv2.waitKey(wait)
            
        #Update move counter to know we're on the next frame
        move_counter += 1
        if not pi:
                file_counter += 1
    
    #Close engine
    engine.quit()
    #When all images have been processed, wait a bit to allow the user to decompress before ending
    time.sleep(0.5)

def main():
    setup()
    process_game()

main()
