blemay360/Chessboard/(commit log)

2021-03-12 Finished prototype function for color identification
2021-03-19 Tested adding threads
2021-03-20 Switched input images to be taken from the pi camera and changed display settings to work on pi display
2021-03-20 Added flags to easier switch from running phone pictures to pi
2021-03-21 Started testing with large board
2021-03-21 Fixed selection for chess engine
    [Chessboard.py]
2021-03-21 Fixed typo for right_move
    [Chessboard.py]
2021-03-21 Fixed another typo with right_move, tested on pi. Works for a couple moves, then errors out
    [Chessboard.py]
2021-03-22 Added auto pi/laptop switching, more verbose output, and the ability to automatically stop when running from images
2021-03-22 Fixed max_file_count error for pi
    [Chessboard.py]
2021-03-22 Added function to tell when edge of board is obstructed from player's arm
2021-03-26 Fixed error that crashed program when an apriltag was blocked, is mostly playable now
    [Chessboard.py]
2021-03-27 Updated program flowchart
2021-03-27 Started testing on wooden board
2021-03-28 Testing wooden board
2021-03-28 Changed settings for hough line transform to through out short lines and be able to link across longer gaps
    [Chessboard.py]
2021-04-01 Fixed up angle errors in edge_clear
    [Chessboard.py]
2021-04-04 Added stls for prototype construction
    [Board mount MVP.stl, Camera Standoff.stl]
2021-04-05 Changed border obstruction detection to work with linear celtic knot pattern
2021-04-06 Changed display variable to be global, added testing images that cause an error
    [Chessboard.py]
2021-04-06 Fixed saving debugging images
    [Chessboard.py]
2021-04-06 Changed margin of squares in piece detection to fix some mislabeled colors
    [Chessboard.py]
2021-04-07 Updated debugging images with apriltag error
    [Chessboard.py]
2021-04-07 Changed how missing apriltags are treated when searching last known tag locations
    [Chessboard.py]
2021-04-07 Fixed debugging image filenames
    [Chessboard.py]
2021-04-07 Changed display function to be more adaptable, split main function into setup and process_game, added support for playing timestamped frames from the pi
2021-04-08 New error found in color_array_to_uci, debugging images in this commit
    [Chessboard.py]
2021-04-08 Added debugging photos for an error with amounts of pieces on the board
    [Chessboard.py]
2021-04-11 Changed margin for edge detection of pieces and made number of pieces detected error throw out the frame
    [Chessboard.py]
2021-04-11 Moved camera setup to setup function
2021-04-11 Made camera global variable to fix error
    [Chessboard.py]
2021-04-11 Added new debugging images, had problems with edge_count_threshold being set too low
    [Chessboard.py]
2021-05-11 Added control board testing code and wrote part of the documentation report
2021-05-11 Rerecorded video in original frame size
2021-05-13 Tweaked color detection algorithm to work with current lighting and added tons of processed images for presentation
2021-05-17 Added control board PCB files and organized some folders
    [Control.brd, Control.sch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]
2021-05-19 Added condition to discard frames where color of pieces seem to switch
2022-08-14 Started to reorganize directory layout
    [Bishop.stl, Board mount MVP.stl, Camera Standoff.stl, Control.brd, Control.sch, King.STL, Knight.STL, Pawn.stl]
